londey/pico-gs/twin/components/rasterizer/tests/fixtures/single_triangle_ref.png

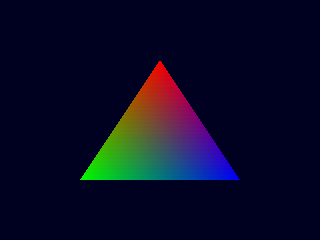
twin/components/rasterizer/tests/fixtures/single_triangle_ref.png
