londey/pico-gs/integration/golden/ver_013_color_combined.png

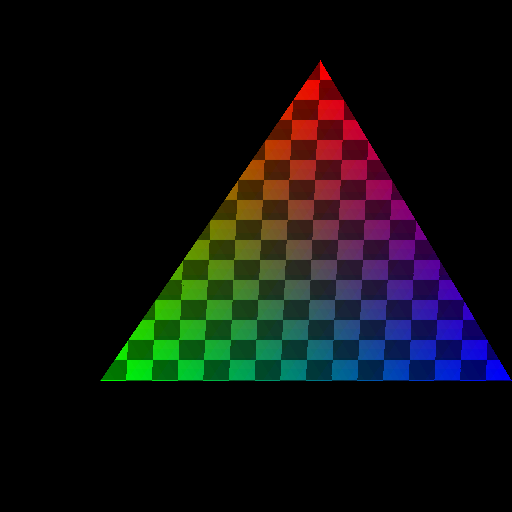
integration/golden/ver_013_color_combined.png
