londey/pico-gs/README.md

# pico-gs

A PS1/N64-era 3D graphics processor implemented in SystemVerilog, targeting the **ECP5-25K** FPGA on an [ICEpi Zero v1.3](external/icepi-zero/) board.
An **RP2350** (Raspberry Pi Pico 2) drives the GPU over SPI; the GPU outputs 640x480 @ 60 Hz DVI.
Named after the PS2 Graphics Synthesizer.

See [ARCHITECTURE.md](ARCHITECTURE.md) for the GPU pipeline architecture, block diagram, and memory system.

## Repository Structure

```text
pico-gs/
├── rtl/                  # SystemVerilog RTL
│   ├── pkg/              # Shared SV packages (fp_types_pkg.sv)
│   ├── top/gpu_top.sv    # Top-level RTL module
│   ├── tb/               # C++ Verilator integration-level testbench (harness, sdram model)
│   └── components/       # Per-component RTL (one subdir each)
│       ├── rasterizer/   # Triangle setup + iteration
│       ├── stipple/      # Stipple test
│       ├── early-z/      # Early depth test
│       ├── texture/      # Texture sampling + decoding (with detail/ subunits)
│       ├── color-combiner/
│       ├── dither/
│       ├── pixel-write/  # Framebuffer write
│       ├── zbuf/         # Z-buffer tile cache
│       ├── memory/       # SDRAM + SRAM controllers
│       ├── display/      # Scan-out / DVI output
│       ├── spi/          # SPI transport + register file
│       ├── registers/    # GPU register interface (SystemRDL source + generated SV)
│       ├── core/         # PLL, reset (RTL only)
│       └── utils/        # FIFOs (RTL only)
├── twin/                 # Rust digital twin crates (one per component)
│   └── components/       # gs-rasterizer, gs-texture, gs-memory, gpu-registers, …
├── shared/
│   └── gs-twin-core/     # Shared Rust foundation crate (types, math)
├── integration/
│   ├── gs-twin/          # Pipeline orchestrator crate
│   ├── gs-twin-cli/      # CLI: render golden references
│   ├── sim/              # Interactive simulator
│   ├── golden/           # Approved golden images
│   └── scripts/          # Hex test scripts + Python generators
├── crates/
│   ├── qfixed/           # Fixed-point math library
│   ├── bits/             # Compile-time width-checked bit vector type
│   ├── ecp5-model/       # Cycle-accurate ECP5 primitive models (DP16KD, MULT18X18D)
│   ├── sdram-model/      # Cycle-accurate SDRAM chip model (W9825G6KH)
│   └── pico-gs-emulator/ # Cycle-accurate GPU emulator
├── pipeline/             # Pipeline microarchitecture (YAML model + validation + diagrams)
├── constraints/          # FPGA constraints
├── doc/                  # Syskit specifications (REQ/INT/UNIT/VER)
├── external/
│   └── icepi-zero/       # Board documentation (git submodule)
├── ARCHITECTURE.md       # GPU architecture document
├── build.sh              # Unified build script
└── Cargo.toml            # Workspace root
```

## Specifications

This project uses [syskit](CLAUDE.md#syskit) for specification-driven development.
Specifications live in `doc/`:

- **Requirements** (`doc/requirements/`): What the system must do (REQ-NNN)
- **Interfaces** (`doc/interfaces/`): Contracts between components (INT-NNN)
- **Design** (`doc/design/`): Implementation approach and decisions (UNIT-NNN)

## Pipeline Model

`pipeline/pipeline.yaml` defines the GPU's pipeline microarchitecture — hardware units, FPGA resource budgets (DSP/EBR/LUT4), and cycle-level schedules for each pipeline mode.
Python scripts validate resource budgets and generate D2 sequence diagrams showing how units are scheduled across clock cycles.

```bash
./build.sh --pipeline   # Validate budgets + generate diagrams (SVG + PNG)
```

Output: `build/pipeline/` (dataflow diagram + per-schedule cycle maps).
Pipeline validation also runs as part of `./build.sh --check`.

## Building

### Prerequisites

- Rust stable (1.75+)
- FPGA toolchain: Yosys, nextpnr-ecp5, ecppack
- Verilator (for RTL simulation)
- ARM cross-compilation target: `rustup target add thumbv8m.main-none-eabihf`

### Build Commands

Build everything (software + FPGA + all tests):
```bash
./build.sh
```

Build specific components:
```bash
./build.sh --fpga-only       # Build FPGA bitstream only
./build.sh --firmware-only   # Build RP2350 firmware only
./build.sh --assets-only     # Process assets only
```

Build in release mode:
```bash
./build.sh --release
```

Flash to hardware:
```bash
./build.sh --flash-fpga --flash-firmware
```

### Component-Specific Builds

**FPGA:**
```bash
cd spi_gpu
make bitstream    # Full synthesis, PNR, bitstream
make synth        # Synthesis only
make program      # Flash to FPGA via JTAG
```

**Firmware:**
```bash
cargo build -p pico-gs-rp2350 --target thumbv8m.main-none-eabihf
cargo test -p pico-gs-core
```

**Asset tool:**
```bash
cargo build -p asset-build-tool
```

## Installing onto Hardware

pico-gs requires two boards: an **ICEpi Zero** (ECP5 FPGA) for the GPU and a **Raspberry Pi Pico 2** (RP2350) as the host controller.

### Prerequisites

In addition to the build prerequisites above:

- [openFPGALoader](https://trabucayre.github.io/openFPGALoader/) for FPGA programming
- [probe-rs](https://probe.rs/) for RP2350 flashing (via a debug probe such as the Raspberry Pi Debug Probe or another CMSIS-DAP adapter)

### Step 1: Build in release mode

```bash
./build.sh --release
```

This produces:
- FPGA bitstream: `build/gpu_top.bit`
- Firmware ELF: `build/pico-gs-rp2350.elf`

### Step 2: Flash the ICEpi Zero

Connect the ICEpi Zero via USB (the on-board FT231X provides JTAG).

**Volatile load** (bitstream lost on power-off — useful for development):
```bash
openFPGALoader -b icepi-zero build/gpu_top.bit
```

**Persistent flash** (bitstream survives power cycles):
```bash
openFPGALoader -b icepi-zero --write-flash build/gpu_top.bit
```

> **Note:** If you have an older version of openFPGALoader that does not recognise the `-b icepi-zero` flag, use `-cft231X --pins=7:3:5:6` instead.

### Step 3: Flash the Pico 2

#### Option A: Debug probe (probe-rs)

Connect a CMSIS-DAP debug probe (e.g. Raspberry Pi Debug Probe) to the Pico 2's SWD pins, then run:

```bash
probe-rs run --chip RP2350 build/pico-gs-rp2350.elf
```

Or use the cargo runner shortcut (configured in `.cargo/config.toml`):

```bash
cargo run --release -p pico-gs-rp2350 --target thumbv8m.main-none-eabihf
```

#### Option B: UF2 drag-and-drop (no debug probe required)

1. Hold the **BOOTSEL** button on the Pico 2 while connecting it via USB.
   It mounts as a USB mass-storage device.
2. Convert the ELF to UF2:
   ```bash
   elf2uf2-rs build/pico-gs-rp2350.elf build/pico-gs-rp2350.uf2
   ```
3. Copy the `.uf2` file to the mounted drive.
   The Pico 2 reboots and runs the firmware automatically.

> Install the conversion tool with `cargo install elf2uf2-rs` if you don't have it.

### One-step build and flash

The build script can build and flash both targets in one go:

```bash
./build.sh --release --flash-fpga --flash-firmware
```

## Digital Twin Verification

Each pipeline component has a Rust digital twin (`twin/`) that defines the bit-accurate expected behaviour.
The `/dt-verify-team` Claude Code command spawns an agent team to create DT-verified test benches for any component.

### Usage

```bash
/dt-verify-team rtl/components/texture/detail/l1-cache
```

The command accepts any component path under `rtl/components/` that has a matching twin crate under `twin/components/`.

### What it does

1. **Pre-flight** — reads the twin crate, RTL sources, and UNIT spec to understand the component
2. **dt-vectors** agent — proposes a test plan (waits for your approval), then generates Rust binaries that produce `$readmemh`-compatible hex stimulus and expected-output files
3. **rtl-testbench** agent — implements SystemVerilog testbenches that load those hex files and verify RTL output binary-matches the twin
4. **Integration** — wires the new test benches into `./build.sh --dt-verify`

Run all DT-verified test benches with:

```bash
./build.sh --dt-verify
```

### File naming conventions

| Type | Pattern | Location |
|---|---|---|
| Vector generator | `gen_<module>_<scenario>_vectors.rs` | `<component>/twin/src/bin/` |
| RTL testbench | `tb_<module>_<scenario>_dt.sv` | `<component>/rtl/tests/` |

## Development

See [CLAUDE.md](CLAUDE.md) for development guidelines and project conventions.

## License

MIT
