londey/pico-gs/doc/requirements/req_003.02_multitexture_rendering.md

# REQ-003.02: Multi-Texture Rendering

## Requirement

When the firmware configures two texture units (TEX0 and TEX1) with valid base addresses and formats, the system SHALL sample both textures during rasterization and provide both texture colors (TEX_COLOR0, TEX_COLOR1) as inputs to the color combiner stage.

## Rationale

Dual-texture rendering enables common multi-texture effects such as diffuse + lightmap, base texture + detail map, or environment mapping + diffuse in a single rendering pass.
This aligns with N64/GeForce2 MX-era dual-texture capabilities.
Effects requiring more than two textures (e.g., diffuse + lightmap + specular + detail) are achievable via multi-pass rendering.

## Parent Requirements

REQ-003

## Interfaces

- INT-010 (GPU Register Map)
- INT-014 (Texture Memory Layout)

## Design Allocation

UNIT-011 (Texture Sampler) — two independent sampler instances (TEX0, TEX1), each with its own index cache; palette LUT is shared

## Functional Requirements

### FR-008-1: Dual Texture Unit Support

When the firmware enables one or both texture units via TEXn_CFG.ENABLE, the system SHALL support up to 2 independent texture units (TEX0 and TEX1), each with its own base address, format, dimensions, and UV coordinate registers (UV0, UV1).

### FR-008-2: Independent Texture Configuration

When a texture unit is configured, each unit SHALL independently specify:

- Enable, format (INDEXED8_2X2 = 4'd0), filter, dimensions, wrap mode, and palette slot selection (TEXn_CFG register)
- Base address in SDRAM (TEXn_CFG.BASE_ADDR field, 512-byte granularity)
- Pre-divided texture coordinates per vertex (ST0_ST1 register, packed S=U/W, T=V/W)

### FR-008-3: Color Combiner Input

When both texture units are enabled, the system SHALL provide both sampled texture colors (TEX_COLOR0 from TEX0, TEX_COLOR1 from TEX1) as inputs to the color combiner stage (REQ-004.01).

### FR-008-4: Single Texture Fallback

When only TEX0 is enabled (TEX1 disabled), the system SHALL provide TEX_COLOR0 to the color combiner and treat TEX_COLOR1 as a neutral value (implementation-defined, typically white RGBA=1,1,1,1).

## Verification Method

**Demonstration:** The system SHALL meet the following acceptance criteria:

- [ ] Configure 2 independent texture units (TEX0, TEX1)
- [ ] Each texture unit configured independently via TEX0_CFG and TEX1_CFG registers
- [ ] Set ST0_ST1 register before each VERTEX write (packed S0/T0/S1/T1, pre-divided texture coordinates S=U/W, T=V/W)
- [ ] Both enabled textures sample in a single draw call using INDEXED8_2X2 format
- [ ] Textures can have different dimensions (e.g., 256×256 diffuse, 64×64 lightmap)
- [ ] Textures can reference different palette slots (TEX0 and TEX1 PALETTE_IDX may differ)
- [ ] Single-texture mode works correctly when only TEX0 is enabled (TEX1_CFG.ENABLE=0)
- [ ] See INT-010 (GPU Register Map) for register details

## Notes

This requirement supersedes the previous 4-texture-unit specification.
The reduction from 4 to 2 texture units per pass simplifies the pipeline while maintaining sufficient capability for common multi-texture effects.
Each sampler has an independent index cache (REQ-003.08); the palette LUT (UNIT-011.06) is shared between both samplers.
Effects previously requiring 4 simultaneous textures can be achieved through multi-pass rendering combined with the color combiner (REQ-004.01).
