londey/pico-gs/doc/requirements/req_001_gpu_spi_hardware.md

# REQ-001: GPU SPI Hardware

## Requirement

The system SHALL provide FPGA-side SPI hardware that accepts register read/write transactions, buffers commands in a FIFO, implements the vertex submission protocol, supports memory upload, and provides GPIO-based flow control to prevent command buffer overflow.

## Rationale

The GPU SPI hardware area groups all FPGA-side requirements for the physical SPI interface and its supporting mechanisms.
This covers the SPI slave controller, command FIFO, register file, vertex submission protocol, memory upload path, and flow control signaling.
Host-side driver software is covered separately by REQ-013 (Host SPI Driver).

## Parent Requirements

None (top-level area)

## Sub-Requirements

- REQ-001.01 (Basic Host Communication)
- REQ-001.02 (Memory Upload Interface)
- REQ-001.03 (SPI Electrical Interface)
- REQ-001.04 (Command Buffer FIFO)
- REQ-001.05 (Vertex Submission Protocol)
- REQ-001.06 (GPU Flow Control)

## Interfaces

- INT-010 (GPU Register Map)
- INT-012 (SPI Transaction Format)
- INT-013 (GPIO Status Signals)
