londey/pico-gs/doc/requirements/req_004_fragment_processor.md

# REQ-004: Fragment Processor / Color Combiner

## Requirement

The system SHALL process rasterized fragments through a programmable color combiner stage, combining texture samples, vertex colors, and constant colors using configurable blend equations at extended internal precision.

## Rationale

The fragment processor area groups requirements for the programmable color combination stage that sits between texture sampling and framebuffer write.
This includes the color combiner modes and the internal precision format used for intermediate calculations.

## Parent Requirements

None (top-level area)

## Interfaces

- INT-010 (GPU Register Map)

## Verification Method

**Inspection:** Verify that UNIT-010 (Color Combiner) is instantiated within UNIT-006 (Pixel Pipeline) with live connections from the `cc_mode` and `const_color` register file outputs, and that DST_COLOR is wired from the color tile buffer to the CC pass-2 input mux.
Child requirements REQ-004.01 and REQ-004.02 carry individual Test-level verification via VER-004 (color combiner unit test) and VER-013/VER-024 (golden image integration tests).

## Notes

This is one of 13 top-level requirement areas organizing the specification hierarchy.
UNIT-010 implements the three-pass color combiner; its `cc_mode` and `const_color` inputs are wired live from UNIT-003 (Register File) through UNIT-006 (Pixel Pipeline).
Alpha blending (REQ-005.03) is implemented as CC pass 2 within UNIT-010, reading DST_COLOR from the color tile buffer managed by UNIT-006.
