londey/pico-gs/doc/requirements/req_006_screen_scan_out.md

# REQ-006: Screen Scan Out

## Requirement

The system SHALL scan out the framebuffer contents as a DVI/HDMI video signal at 640x480 progressive 60 Hz with optional color grading.

## Rationale

The screen scan out area groups all requirements related to reading the completed framebuffer and producing a display output signal, including video timing, vsync frame synchronization, and post-processing (color grading LUT).

## Parent Requirements

None (top-level area)

## Interfaces

- INT-002 (DVI TMDS Output)
- INT-010 (GPU Register Map)
- INT-011 (SDRAM Memory Layout)
