londey/pico-gs/doc/requirements/req_013_host_spi_driver.md

# REQ-013: Host SPI Driver

## Requirement

The system SHALL provide host-side software that communicates with the GPU over SPI, managing the transaction protocol, texture upload sequences, and vsync frame synchronization.

## Rationale

The host SPI driver area groups all host-side (RP2350 and PC) software requirements for driving the GPU over SPI.
This is the software counterpart to REQ-001 (GPU SPI Hardware), covering the Rust driver API, transaction framing, and synchronization.

## Parent Requirements

None (top-level area)

## Sub-Requirements

- REQ-013.01 (GPU Communication Protocol)
- REQ-013.02 (Upload Texture)
- REQ-013.03 (VSync Synchronization)
