londey/pico-gs/doc/reports/rp2350_vertex_throughput.md

# RP2350 Vertex Processing Throughput Analysis

## Technical Report: Estimated Rendering Performance on Single Cortex-M33 Core

---

## 1. Hardware Foundation

**Processor:** RP2350 dual Cortex-M33 at 150 MHz (default clock)
**Available core:** One core (Core 1) dedicated to rendering; Core 0 handles scene management, USB input, and command generation
**FPU:** FPv5 single-precision, pipelined

**Confirmed FPU Instruction Latencies (Cortex-M33 FPv5):**

| Instruction | Latency (cycles) | Throughput (CPI) | Notes |
|---|---|---|---|
| VADD.F32 / VSUB.F32 | 1 | 1 | Single-cycle pipeline |
| VMUL.F32 | 1 | 1 | Single-cycle pipeline |
| VMLA.F32 (multiply-accumulate) | 3 | 3 | NOT fused; 3-cycle penalty vs separate VMUL+VADD (2 cycles) |
| VFMA.F32 (fused multiply-add) | 3 | 3 | Fused but same latency as VMLA |
| VNMUL.F32 | 1 | 1 | Negate-multiply |
| VDIV.F32 | 14 | 14 | Iterative; integer instructions can execute concurrently |
| VSQRT.F32 | 14 | 14 | Iterative; same concurrency as VDIV |
| VCVT (float<->int) | 1 | 1 | Single-cycle conversion |
| VLDR.F32 | 1-2 | 1 | Zero-wait-state from SRAM; may stall on bus contention |
| VSTR.F32 | 1 | 1 | Zero-wait-state to SRAM |
| VMOV (FPU<->GPR) | 1 | 1 | Register transfer |

**Key insight:** VMLA/VFMA take 3 cycles.
The compiler often prefers separate VMUL+VADD (2 cycles total) over VMLA (3 cycles).
With `glam` in scalar mode (no SIMD on Cortex-M33), the generated code will be scalar FPU operations.

**Memory:** 520 KB SRAM in 10 independent banks via AHB-Lite crossbar.
SRAM accesses are single-cycle when no bus contention occurs between cores.
The crossbar supports concurrent access to different banks from different bus masters.

**SPI interface:** 25 MHz SPI to FPGA GPU.
Each register write is a 9-byte SPI transaction (1 address byte + 8 data bytes).
At 25 MHz, one 9-byte write takes 72 SPI bit-clocks = 2.88 us = **432 CPU cycles at 150 MHz**.

---

## 2. Current Pipeline Implementation

Based on the actual codebase, the current vertex processing pipeline performs these operations per vertex:

From `/workspaces/pico-gs/crates/pico-gs-core/src/render/mesh.rs` (lines 59-67):
```rust
let screen = transform_vertex(pos, mvp);          // MVP + perspective divide + viewport
let eye_normal = transform_normal(norm, mv);       // Normal transform + normalize
let color = compute_lighting(eye_normal, base_color, lights, ambient);  // 4-light Gouraud
```

**Architecture note:** The current system splits work across cores:
- **Core 0** performs all vertex transformation, lighting, culling, and packing
- **Core 1** only dequeues `RenderCommand` structs and sends pre-packed data over SPI

This means the vertex processing throughput is determined by **Core 0's** compute budget, not Core 1.
The SPSC queue (64 entries) provides decoupling but Core 0 will block when it fills up.

---

## 3. Detailed Per-Vertex Cycle Breakdown

### 3.1 Common Operations

#### A. Mat4 * Vec4 (MVP Transform)

`glam` on Cortex-M33 uses scalar fallback (no SIMD, `default-features = false`).
A Mat4 * Vec4 expands to:
- 4 result components, each = dot product of matrix row with Vec4
- Each dot product: 4 VMUL + 3 VADD = 7 FPU ops
- Total: 16 VMUL + 12 VADD = **28 FPU cycles** (assuming no pipeline stalls)
- Load overhead: 16 matrix floats + 4 vector floats = 20 VLDR instructions = ~20 cycles
- Store: 4 VSTR = 4 cycles
- **Subtotal: ~52 cycles** (pure instruction count)

With pipeline hazards, register pressure, and loop/function call overhead:
- **Realistic estimate: 60-75 cycles per Mat4 * Vec4**

#### B. Perspective Divide

- VABS + VCMP + branch: ~3 cycles
- VDIV (1.0 / w): **14 cycles**
- 3x VMUL (ndc_x, ndc_y, ndc_z): 3 cycles (but first depends on VDIV result)
- Note: VDIV allows concurrent integer execution, but subsequent VMUL.F32 must wait
- **Subtotal: ~20 cycles**

#### C. Viewport Transform

- Per axis: 1 VADD + 2 VMUL (or 1 VADD + 1 VMUL if constants pre-combined)
- 3 axes: ~9 VADD/VMUL = **~9 cycles**
- Plus clamp on sz: VMOV + VCMP + conditional moves = ~4 cycles
- **Subtotal: ~13 cycles**

#### D. Normal Transform + Normalize

- Mat4 * Vec4 (with w=0.0, compiler may optimize away 4 multiplies): **~50-65 cycles** (slightly cheaper)
- `normalize_or_zero()`:
  - Dot product (length_squared): 3 VMUL + 2 VADD = 5 cycles
  - Comparison with epsilon: 2 cycles
  - VSQRT: **14 cycles**
  - VDIV (1/length): **14 cycles** (or reciprocal + VMUL)
  - 3x VMUL (scale): 3 cycles
  - **Normalize subtotal: ~38 cycles**
- **Subtotal: ~88-103 cycles**

#### E. Back-Face Culling (per triangle, amortized per vertex)

- 4 VSUB + 2 VMUL + 1 VSUB + VCMP = ~8 FPU cycles
- Per triangle = 3 vertices, so per-vertex amortized: ~2.7 cycles
- **Subtotal (amortized per vertex): ~3 cycles**

#### F. Float-to-Fixed Conversion (Packing)

Per conversion: clamp (2 VCMP + 2 conditional moves) + VMUL + VCVT.F32.S32 = ~6 cycles
- 3 conversions (x, y, z): ~18 cycles
- Bit packing (shifts + ORs on integer side): ~10 integer cycles
- Color packing: ~5 integer cycles (byte shifts + ORs)
- **Subtotal: ~33 cycles**

---

## 4. Scenario Analysis

### Scenario A: Lightmapped Static Mesh with 4 Dynamic Point Lights

This scenario represents a pre-transformed world-space mesh (common in retro-style engines where level geometry is static).
Vertices are stored in world space, so only a VP (view-projection) transform is needed.

| Operation | FPU Ops | Est. Cycles | Notes |
|---|---|---|---|
| Load vertex data (pos, normal, 2 UVs) | - | 20 | 5 Vec3/Vec2 loads from SRAM |
| VP transform (Mat4*Vec4) | 28 | 65 | No model matrix needed |
| Perspective divide | 4 | 20 | 1 VDIV + 3 VMUL |
| Viewport transform | 9 | 13 | Scale + offset, 3 axes |
| Normal load (pre-transformed) | - | 6 | 3 floats from SRAM |
| **Point light 1** | | | |
| - Vertex-to-light vector | 3 | 3 | 3 VSUB |
| - Distance squared | 5 | 5 | 3 VMUL + 2 VADD |
| - VSQRT(distance) | 1 | 14 | Iterative |
| - 1/distance (attenuation) | 1 | 14 | VDIV (can overlap sqrt integer work) |
| - Attenuation factor | 2 | 2 | VMUL + VMUL (1/d^2 * intensity) |
| - N dot L | 5 | 5 | 3 VMUL + 2 VADD |
| - Clamp + scale color | 6 | 6 | max(0) + 3 VMUL for RGB |
| **Point light subtotal (x1)** | 23 | **49** | |
| **Point lights (x4)** | 92 | **196** | Dominated by VSQRT + VDIV |
| Accumulate ambient | 3 | 3 | 3 VADD |
| Modulate base color | 3 | 3 | 3 VMUL |
| Color to u8 (clamp + convert) | - | 12 | 3x VCVT + clamp |
| UV0 pass-through | - | 4 | Load + store |
| UV1 (lightmap) pass-through | - | 4 | Load + store |
| Pack UV (with 1/w) | 5 | 24 | 1 VDIV + 2 VMUL + 3 VCVT + bit ops |
| Float-to-fixed + pack position | - | 33 | As computed above |
| Back-face cull (amortized) | - | 3 | Per-vertex share |
| **TOTAL (instruction count)** | | **406** | |
| Loop + function overhead | | ~60 | Branch, index, bounds check |

| Metric | Optimistic | Realistic (1.5x overhead) |
|---|---|---|
| **Cycles per vertex** | 406 | 610 |
| **Vertices/sec at 150 MHz** | 369,458 | 245,902 |
| **Triangles/sec** (1.5 verts/tri) | 246,305 | 163,934 |
| **Triangles/frame at 60 FPS** | 4,105 | 2,732 |

**Key bottleneck:** The 4 point lights account for ~48% of the per-vertex cost, with VSQRT and VDIV (14 cycles each) dominating.
Optimization: precompute 1/distance^2 tables, use fast inverse-square-root approximation, or switch to directional lights.

---

### Scenario B: Static Mesh with 4 Directional Lights

This is closest to the existing teapot demo in the codebase, which already implements exactly this pattern.

| Operation | FPU Ops | Est. Cycles | Notes |
|---|---|---|---|
| Load vertex data (pos, normal) | - | 12 | 2 Vec3 loads |
| MVP transform (Mat4*Vec4) | 28 | 65 | Pre-combined model*view*projection |
| Perspective divide | 4 | 20 | 1 VDIV + 3 VMUL |
| Viewport transform | 9 | 13 | |
| Normal transform (MV * normal) | 28 | 60 | Mat4*Vec4 with w=0 |
| Normalize | 12 | 38 | dot + sqrt + div + 3 mul |
| **Directional light 1** | | | |
| - N dot L | 5 | 5 | 3 VMUL + 2 VADD |
| - max(0, NdotL) | 1 | 2 | VCMP + conditional |
| - Scale by light color (RGB) | 3 | 3 | 3 VMUL |
| **Dir light subtotal (x1)** | 9 | **10** | |
| **Dir lights (x4)** | 36 | **40** | Very cheap without distance |
| Accumulate ambient | 3 | 3 | |
| Modulate by base color | 3 | 3 | |
| Color clamp + convert to u8 | - | 12 | |
| Float-to-fixed + pack position | - | 33 | |
| Back-face cull (amortized) | - | 3 | |
| **TOTAL (instruction count)** | | **302** | |
| Loop + function overhead | | ~45 | |

| Metric | Optimistic | Realistic (1.5x overhead) |
|---|---|---|
| **Cycles per vertex** | 302 | 453 |
| **Vertices/sec at 150 MHz** | 496,689 | 331,126 |
| **Triangles/sec** (1.5 verts/tri) | 331,126 | 220,751 |
| **Triangles/frame at 60 FPS** | 5,519 | 3,679 |

**Validation against existing codebase:** The teapot demo has 146 vertices and 288 triangles.
At 453 cycles/vertex, 146 vertices = 66,138 cycles = **0.44 ms** at 150 MHz.
This leaves ample headroom within a 16.67 ms frame.
The actual demo runs at 60 FPS without issue, which is consistent with these estimates (the SPI submission on Core 1 is the real bottleneck for that demo: 288 triangles x 6-9 register writes x 432 cycles/write = 745k-1.1M cycles = 5-7.5 ms).

---

### Scenario C: 3-Bone Skinned Mesh with 4 Directional Lights

This is the most computationally intensive scenario.
Skeletal animation requires blending bone matrices per vertex before any other transform.

| Operation | FPU Ops | Est. Cycles | Notes |
|---|---|---|---|
| Load vertex data (pos, normal, weights, bone indices) | - | 20 | pos(3) + normal(3) + weights(3) + indices(3) |
| **Load 3 bone matrices** | - | 54 | 3 x 16 floats x ~1.1 cycles (potential bank contention) |
| **Skinned position: w0*(M0*v) + w1*(M1*v) + w2*(M2*v)** | | | |
| - M0 * Vec4 | 28 | 65 | Full Mat4*Vec4 |
| - w0 * result0 | 4 | 4 | Scalar * Vec4 |
| - M1 * Vec4 | 28 | 65 | |
| - w1 * result1 | 4 | 4 | |
| - result0 + result1 | 4 | 4 | Vec4 add |
| - M2 * Vec4 | 28 | 65 | |
| - w2 * result2 | 4 | 4 | |
| - result01 + result2 | 4 | 4 | Vec4 add |
| **Skinned position subtotal** | 104 | **215** | |
| **Skinned normal (Mat3 approx)** | | | |
| - M0_3x3 * normal | 15 | 40 | 9 mul + 6 add + overhead |
| - w0 * result0 | 3 | 3 | |
| - M1_3x3 * normal | 15 | 40 | |
| - w1 * result1 | 3 | 3 | |
| - M2_3x3 * normal | 15 | 40 | |
| - w2 * result2 | 3 | 3 | |
| - Accumulate (2 Vec3 adds) | 6 | 6 | |
| **Skinned normal subtotal** | 60 | **135** | |
| Renormalize skinned normal | 12 | 38 | dot + sqrt + div + 3 mul |
| VP transform (skinned pos already in world space) | 28 | 65 | |
| Perspective divide | 4 | 20 | |
| Viewport transform | 9 | 13 | |
| **Dir lights (x4)** | 36 | 40 | Same as Scenario B |
| Accumulate ambient + modulate | 6 | 6 | |
| Color convert | - | 12 | |
| Float-to-fixed + pack | - | 33 | |
| Back-face cull (amortized) | - | 3 | |
| **TOTAL (instruction count)** | | **654** | |
| Loop + function overhead | | ~80 | More complex function, more loads |

**Memory access concern:** Loading 3 bone matrices = 3 x 16 x 4 = 192 bytes.
If bone matrices are stored contiguously and span SRAM bank boundaries, the AHB crossbar provides single-cycle access.
However, if Core 0 is simultaneously accessing the same bank for scene data, bank contention adds 1 cycle per conflicting access.
Realistic overhead factor should be higher for this scenario: **1.6-2.0x**.

| Metric | Optimistic | Realistic (1.8x overhead) |
|---|---|---|
| **Cycles per vertex** | 654 | 1,177 |
| **Vertices/sec at 150 MHz** | 229,358 | 127,443 |
| **Triangles/sec** (1.5 verts/tri) | 152,905 | 84,962 |
| **Triangles/frame at 60 FPS** | 2,548 | 1,416 |

---

## 5. SPI Submission Bottleneck Analysis

The vertex processing throughput estimated above is for **Core 0 only** (compute-bound).
However, the system must also submit the computed triangles to the FPGA GPU over SPI.
This is handled by Core 1, and the SPI bandwidth may be the actual bottleneck.

**Per-triangle SPI cost:**

Each triangle requires:
- 3 vertices x (1 COLOR write + 1 VERTEX write) = **6 register writes** (non-textured)
- 3 vertices x (1 COLOR write + 1 UV0 write + 1 VERTEX write) = **9 register writes** (textured)

Each register write = 9 bytes at 25 MHz SPI = **2.88 microseconds = 432 CPU cycles**.

| Config | Writes/Triangle | SPI Time/Triangle | Triangles/sec (SPI-limited) | Tri/frame @60fps |
|---|---|---|---|---|
| Non-textured | 6 | 17.28 us | 57,870 | 964 |
| Textured | 9 | 25.92 us | 38,580 | 643 |

**This is a critical finding:** The SPI bottleneck at 25 MHz limits throughput far below the vertex compute capacity.
The SPI bus can push at most **964 non-textured triangles/frame** or **643 textured triangles/frame** at 60 FPS.

This means Core 0's vertex processing is NOT the bottleneck in any scenario.
Core 0 can transform vertices faster than Core 1 can ship them over SPI, and the 64-entry SPSC queue will frequently fill up causing Core 0 to spin-wait.

---

## 6. Summary Table

| Scenario | Cycles/Vert (Optimistic) | Cycles/Vert (Realistic) | Verts/sec (Realistic) | Tri/sec Compute | Tri/sec SPI-limited | Tri/frame @60fps (Effective) |
|---|---|---|---|---|---|---|
| **A: Lightmapped + 4 Point Lights** | 406 | 610 | 245,902 | 163,934 | 38,580 (textured) | **643** |
| **B: Static + 4 Dir Lights** | 302 | 453 | 331,126 | 220,751 | 57,870 (non-textured) | **964** |
| **C: 3-Bone Skinned + 4 Dir Lights** | 654 | 1,177 | 127,443 | 84,962 | 57,870 (non-textured) | **964** |

**Effective triangle budget** is dominated by SPI bandwidth, not vertex compute.

---

## 7. Optimization Opportunities

### 7.1 SPI Throughput (highest impact)

The SPI clock of 25 MHz is the dominant bottleneck.
Options:
1. **Increase SPI clock to 50 MHz** (if FPGA supports it): doubles triangle throughput to ~1,928 tri/frame
2. **DMA-based SPI with overlap**: While DMA transfers one triangle's data, Core 1 prepares the next.
   Effective throughput gain: ~10-20%
3. **Batch register protocol**: Send multiple vertices in a single CS-low transaction without repeating the address byte per register.
   Could reduce per-vertex overhead by ~15%
4. **Wider SPI bus (dual/quad SPI)**: 4x throughput with QSPI

### 7.2 Vertex Compute Optimizations

These matter less given SPI bottleneck, but would help if SPI is improved:

1. **Fast inverse square root** for point lights: Replace VSQRT + VDIV (28 cycles) with Newton-Raphson approximation (~6 cycles).
   The FPv5 has VRSQRTE (reciprocal square root estimate, ~1 cycle) that can seed a single Newton iteration.
2. **Skip normalize when normals are unit-length**: If the model matrix has uniform scale, transformed normals only need rescaling, not full normalize.
   Saves ~24 cycles/vertex.
3. **Pre-combine MVP matrix once per frame** (already done in the teapot demo): Saves one Mat4*Vec4 per vertex.
4. **Use Cortex-M33 custom instructions** (if implemented in RP2350): The RP2350 supports Arm Custom Instructions (ACI).
   In theory, dot-product-4 could be a single instruction.
5. **Dual-core vertex processing**: Currently Core 0 does all transforms.
   If the SPI bottleneck is resolved, split vertex batches across both cores with double-buffered output.

### 7.3 Realistic Target for the Hobby GPU

At 60 FPS with current 25 MHz SPI:
- **~640-960 triangles per frame** is the hard ceiling
- This is comparable to early 3D consoles (Virtual Boy: ~300 triangles, PS1 launch titles: ~500-2000 visible triangles)
- Well-suited for low-poly aesthetic: a character (200 tri) + environment (400 tri) + props (200 tri) fits within budget

At 50 MHz SPI (achievable with careful FPGA timing):
- **~1,300-1,900 triangles per frame** becomes feasible
- Vertex compute for Scenario B (directional lights) still has 3.6x headroom

With QSPI (see FTDI 245 vs SPI report):
- **~2,500-3,800 triangles per frame** at 37.5 MHz QSPI
- Vertex compute starts to matter for Scenario C (skinned meshes)

---

## 8. Validation: Existing Teapot Demo

The codebase's spinning teapot (146 vertices, 288 triangles, 2 active directional lights) provides a real-world validation point:

- **Vertex compute (Core 0):** 146 vertices x ~400 cycles = 58,400 cycles = 0.39 ms
- **SPI submission (Core 1):** 288 triangles x 6 writes x 432 cycles = 746,496 cycles = 4.98 ms
- **Total frame time estimate:** ~5.4 ms (dominated by SPI)
- **Achievable framerate:** ~185 FPS (compute+SPI only), capped at 60 FPS by vsync
- **Headroom:** ~3x more triangles could fit within the 16.67 ms frame budget

This is consistent with the demo running comfortably at 60 FPS as designed.

---

## Sources

- [ARM Cortex-M33 Technical Reference Manual](https://documentation-service.arm.com/static/5f15c42420b7cf4bc5247f3a)
- [Cortex-M33 instruction cycle counts discussion (ST Community)](https://community.st.com/t5/stm32-mcus-products/cortex-m33-instruction-cycle-counts/td-p/123198)
- [Cortex-M4 Instruction Timing Reference](https://www.cse.scu.edu/~dlewis/book3/docs/Cortex-M4%20Instruction%20Timing.pdf)
- [ARM Cortex-M Wikipedia (FPU comparison table)](https://en.wikipedia.org/wiki/ARM_Cortex-M)
- [RP2350 Datasheet (Raspberry Pi)](https://datasheets.raspberrypi.com/rp2350/rp2350-datasheet.pdf)
- [Introducing the RP2350 (Dmitry.GR)](https://dmitry.gr/?r=06.+Thoughts&proj=11.+RP2350)
- [SEGGER Floating-Point Performance Comparison](https://blog.segger.com/floating-point-face-off-part-2-comparing-performance/)
- [glam-rs GitHub (scalar math fallback)](https://github.com/bitshifter/glam-rs)
- [STM32 Cortex-M33 Programming Manual](https://www.st.com/resource/en/programming_manual/pm0264-stm32-cortexm33-mcus-and-mpus-programming-manual-stmicroelectronics.pdf)
