londey/pico-gs/doc/interfaces/int_010_gpu_register_map.md

# INT-010: GPU Register Map

## Type

Internal

## Specification

## Overview

The GPU is controlled via a 7-bit address space providing 128 register locations. Each register is 64 bits wide, though many use fewer bits (unused bits are reserved and must be written as zero, read as zero).

**Transaction Format** (72 bits total):
```
[71]      R/W̄ (1 = read, 0 = write)
[70:64]   Register address (7 bits)
[63:0]    Register value (64 bits)
```

**Command Sources:** Register writes arrive at the register file (UNIT-003) from the command FIFO (UNIT-002), which has two sources:
1. **SPI transactions** from the host (primary, steady-state source)
2. **Pre-populated boot commands** baked into the FIFO memory at bitstream generation time (autonomous, power-on only; see DD-019)

The boot sequence uses registers COLOR (0x00), VERTEX_KICK_012 (0x07), RENDER_MODE (0x30), FB_CONFIG (0x40), and FB_DISPLAY (0x41) to render a self-test screen.
All register semantics are identical regardless of command source.

**Major Features**:
- **2 independent texture units with separate UV coordinates**
- **Dedicated color combiner module with programmable input selection**
- **DOT3 bump mapping with interpolated light direction**
- **Dual vertex colors: diffuse (VER_COLOR0) + specular (VER_COLOR1)**
- **NEAREST (point-sample) texture filtering**
- **Single texture format: INDEXED8_2X2** — 8-bit palette index per 2×2 apparent-texel tile; 4-bit FORMAT field retained for ABI stability (values 4'd1–4'd15 reserved); see INT-014
- **2-slot shared palette LUT** — 256 entries × 4 quadrant RGBA colors per slot; loaded via PALETTE0/PALETTE1 registers (0x12/0x13)
- Swizzle patterns for channel reordering
- **Unified RENDER_MODE register (TRI_MODE + ALPHA_BLEND + Z-modes + dithering)**
- **Scissor rectangle for pixel clipping**
- **Framebuffer write enable masks (Z-buffer, color buffer)**
- Memory upload interface
- Color grading LUT at scanout
- Integrated triangle kick mode control
- **Packed performance counters: 2×32-bit per register**
- Backface culling based on winding order
- **Material colors (MAT_COLOR0, MAT_COLOR1) and fog via Z_COLOR**

---

## Address Space Organization

```
0x00-0x0F: Vertex State (COLOR, ST0_ST1, LIGHT_DIR, VERTEX variants)
0x10-0x17: Texture Configuration (2 units × 4 registers each)
0x18-0x1F: Color Combiner (CC_MODE, MAT_COLOR0, MAT_COLOR1, FOG_COLOR, reserved)
0x20-0x2F: Reserved (freed from old texture registers)
0x30-0x3F: Rendering Configuration (RENDER_MODE consolidated)
0x40-0x4F: Framebuffer, Z-Buffer, Scissor, Color Grading
0x50: Performance Timestamp (PERF_TIMESTAMP)
0x51-0x6F: Reserved
0x70-0x7F: Status & Control (MEM_ADDR, MEM_DATA, ID)
```

**Key Optimizations**:
- Texture units reduced from 4 to 2, with 4x larger per-unit cache (16K texels)
- Color combiner replaces sequential 4-texture blend with flexible N64/GeForce2-style combining
- UV2_UV3 register eliminated (0x02 freed), texture registers 0x18-0x1F repurposed for color combiner
- Performance counters replaced with command-stream timestamp marker (PERF_TIMESTAMP writes to SDRAM)

---

## Register Summary

| Addr | Name | R/W | Description |
|---|---|-----|---|
| **Vertex State** ||||
| 0x00 | COLOR | W | Diffuse[63:32] + Specular[31:0] vertex colors |
| 0x01 | ST0_ST1 | W | Texture units 0+1 pre-divided coordinates (packed S=U/W, T=V/W) |
| 0x02 | - | - | Reserved |
| 0x03 | LIGHT_DIR | W | Light direction XYZ for DOT3 (X8Y8Z8) |
| 0x04-0x05 | - | - | Reserved (future vertex attributes) |
| 0x06 | VERTEX_NOKICK | W | Vertex position + 1/W, no triangle draw |
| 0x07 | VERTEX_KICK_012 | W | Vertex position + 1/W, draw tri (v[0], v[1], v[2]) |
| 0x08 | VERTEX_KICK_021 | W | Vertex position + 1/W, draw tri (v[0], v[2], v[1]) |
| 0x09-0x0F | - | - | Reserved (future vertex attributes) |
| **Texture Units** ||||
| 0x10 | TEX0_CFG | R/W | Texture unit 0: enable, format, dimensions, filter, wrap, palette slot, base addr, cache inv |
| 0x11 | TEX1_CFG | R/W | Texture unit 1: same layout as TEX0_CFG |
| 0x12 | PALETTE0 | R/W | Palette slot 0: SDRAM base address + load trigger |
| 0x13 | PALETTE1 | R/W | Palette slot 1: SDRAM base address + load trigger |
| 0x14–0x17 | - | - | Reserved |
| **Color Combiner** ||||
| 0x18 | CC_MODE | R/W | Color combiner mode and input selection |
| 0x19 | MAT_COLOR0 | R/W | Material color 0 (RGBA8888) |
| 0x1A | MAT_COLOR1 | R/W | Material color 1 (RGBA8888) |
| 0x1B | FOG_COLOR | R/W | Fog color (RGBA8888) |
| 0x1C-0x1F | - | - | Reserved |
| 0x20-0x2F | - | - | Reserved |
| **Rendering Config** ||||
| 0x30 | RENDER_MODE | R/W | **Unified rendering state** |
| 0x31 | Z_RANGE | R/W | **Depth range clipping min/max** |
| 0x32 | - | - | Reserved |
| 0x33-0x3F | - | - | Reserved (rendering config) |
| **Framebuffer** ||||
| 0x40 | FB_CONFIG | R/W | **Render target: color/Z base addresses + surface dimensions (WIDTH_LOG2, HEIGHT_LOG2)** |
| 0x41 | FB_DISPLAY | R/W | **Display scanout + LUT control + FB_WIDTH_LOG2 + LINE_DOUBLE (non-blocking)** |
| 0x42 | - | - | Reserved (previously FB_ZBUFFER; Z base address now in FB_CONFIG) |
| 0x43 | FB_CONTROL | R/W | **Scissor rectangle** |
| 0x44 | MEM_FILL | W | **Memory fill operation (blocking-write)** |
| 0x45 | FB_CACHE_CTRL | W | **Color-buffer cache flush/invalidate (blocking-write)** |
| 0x46 | - | - | Reserved |
| 0x47 | FB_DISPLAY_SYNC | R/W | **Display scanout + LUT control (vsync-blocking, same format as FB_DISPLAY)** |
| 0x48-0x4F | - | - | Reserved (framebuffer config) |
| **Performance Timestamp** ||||
| 0x50 | PERF_TIMESTAMP | R/W | **Write: capture cycle counter to SDRAM[22:0]; Read: live counter** |
| 0x51-0x6F | - | - | Reserved |
| **Status & Control** ||||
| 0x70 | MEM_ADDR | R/W | Memory dword address pointer (22-bit) |
| 0x71 | MEM_DATA | R/W | Memory data (bidirectional 64-bit, auto-increment) |
| 0x72-0x7E | - | - | Reserved |
| 0x7F | ID | R | GPU identification |

---

## Vertex State Registers (0x00-0x0F)

### 0x00: COLOR (Diffuse + Specular)

Latches RGBA colors for the next vertex push. Now holds both diffuse and specular colors.

```
[63:56]   Diffuse Alpha (8 bits)
[55:48]   Diffuse Blue (8 bits)
[47:40]   Diffuse Green (8 bits)
[39:32]   Diffuse Red (8 bits)
[31:24]   Specular Alpha (8 bits)
[23:16]   Specular Blue (8 bits)
[15:8]    Specular Green (8 bits)
[7:0]     Specular Red (8 bits)
```

**Blending Pipeline** (Color Combiner):
```
Step 1: Sample TEX0, TEX1 (2 texture units max)
Step 2: Color combiner pass 0 (CC0): combines inputs per CC_MODE[31:0] equation
        Inputs: VER_COLOR0 (diffuse), VER_COLOR1 (specular), TEX_COLOR0, TEX_COLOR1,
                MAT_COLOR0, MAT_COLOR1, Z_COLOR (fog)
Step 3: Color combiner pass 1 (CC1): combines inputs per CC_MODE[63:32]; COMBINED = pass 0 output
Step 4: Color combiner pass 2 (CC2/blend): COMBINED = pass 1 output;
        DST_COLOR from color tile buffer available; RENDER_MODE.ALPHA_BLEND selects blend equation
```

**Notes**:
- VER_COLOR0 (diffuse) and VER_COLOR1 (specular) are the two vertex colors
- The color combiner (CC_MODE register 0x18) controls how these inputs are combined
- VER_COLOR0 and VER_COLOR1 are interpolated across the triangle (Gouraud shading)
- Values are 0-255, where 255 = full intensity
- Color is associated with the next VERTEX write

**Reset Value**: 0x00000000_00000000 (both transparent black)

---

### 0x01: ST0_ST1

Latches pre-divided texture coordinates for texture units 0 and 1.
Values are pre-divided by W for perspective correction (S=U/W, T=V/W).
**Note**: 1/W (Q) is stored in VERTEX registers.

```
[63:48]   T1 = V1/W (Q4.12 signed fixed-point)
[47:32]   S1 = U1/W (Q4.12 signed fixed-point)
[31:16]   T0 = V0/W (Q4.12 signed fixed-point)
[15:0]    S0 = U0/W (Q4.12 signed fixed-point)
```

**Fixed-Point Format (Q4.12)**:
- Bit 15: Sign
- Bits 14:12: Integer part (3 bits)
- Bits 11:0: Fractional value
- Range: -8.0 to +7.999
- Resolution: 1/4096 ≈ 0.000244

**Notes**:
- Host must compute S=U/W, T=V/W per vertex for each texture unit
- GPU reconstructs U = S/Q, V = T/Q per pixel using Q from VERTEX register
- If only ST0 is used (single texture), write ST1 fields as 0
- ST coordinates for disabled texture units are ignored

**Reset Value**: 0x0000000000000000

---

### 0x02: UV2_UV3 (Removed)

Removed. With only 2 texture units, ST0_ST1 (0x01) provides all needed texture coordinates. This address is now reserved.

---

### 0x03: LIGHT_DIR

Latches light direction vector for DOT3 bump mapping. Interpolated across the triangle (Gouraud-style).

```
[63:24]   Reserved (write as 0)
[23:16]   Z direction (signed 8-bit, -128 to +127)
[15:8]    Y direction (signed 8-bit, -128 to +127)
[7:0]     X direction (signed 8-bit, -128 to +127)
```

**Format**: Signed 8-bit fixed-point, range [-1.0, +0.992] (scale: 128 = 1.0)

**Usage with DOT3**:
```
Per-vertex (host):
  light_dir = normalize(light_position - vertex_position)
  X = clamp(light_dir.x × 128, -128, 127)
  Y = clamp(light_dir.y × 128, -128, 127)
  Z = clamp(light_dir.z × 128, -128, 127)
  gpu_write(REG_LIGHT_DIR, (Z << 16) | (Y << 8) | X)

Per-pixel (GPU):
  light_xyz = interpolate_linear(v0.light_dir, v1.light_dir, v2.light_dir, bary)
  normal_xyz = texture_sample(normal_map) × 2 - 1  // Map [0,1] to [-1,+1]
  dot3_result = clamp(dot(normal_xyz, light_xyz), 0, 1)
  // Use dot3_result in texture blending when BLEND=DOT3
```

**Notes**:
- Light direction interpolated linearly across triangle (like vertex colors)
- Interpolated vector may not be unit length, but acceptable for DOT3
- Requires texture unit configured with BLEND=DOT3 mode
- Normal map texture typically uses BC4 (single R channel for compressed grayscale normals), BC1, or RGB565 encoding

**Reset Value**: 0x0000000000000000 (zero vector)

---

### 0x04-0x05: Reserved

Reserved for future vertex attributes (normals, tangents, skinning weights, etc.).

**Reset Value**: N/A (reserved)

---

### 0x06: VERTEX

Deprecated. Use VERTEX_NOKICK (0x06), VERTEX_KICK_012 (0x07), or VERTEX_KICK_021 (0x08) instead. This entry is retained for reference; the register address is now VERTEX_NOKICK.

```
[63:48]   Q = 1/W (UQ1.15 unsigned fixed-point)
[47:32]   Z depth (16 bits unsigned)
[31:16]   Y coordinate (Q12.4 signed fixed-point)
[15:0]    X coordinate (Q12.4 signed fixed-point)
```

**Fixed-Point Format (Q12.4)**:
- Bits 15:4: Signed integer (-2048 to +2047)
- Bits 3:0: Fractional (1/16 pixel)

**Fixed-Point Format Q (UQ1.15)**:
- Bit 15: Integer part (1 bit)
- Bits 14:0: Fractional value (resolution 1/32768)
- Range: 0.0 to ~2.0 (unsigned; 1/W is always non-negative, W ≥ 1)

**Z Format (16 bits)**:
- Unsigned, 0 = near plane, 0xFFFF = far plane
- Maps to normalized device coordinates after projection
- Higher values are further away

**Vertex Push Behavior**:
```
Write to VERTEX:
  vertex[vertex_count] = {current_COLOR, current_ST0_ST1, X, Y, Z}
  vertex_count++
  if vertex_count == 3:
    submit_triangle(vertex[0], vertex[1], vertex[2])
    vertex_count = 0
```

**Reset Value**: N/A (write-only trigger)

---

### 0x06: VERTEX_NOKICK

Latches vertex position and 1/W without triggering triangle rasterization. Used to accumulate vertices for strips, fans, or explicit triangle submission.

```
[63:48]   Q = 1/W (UQ1.15 unsigned fixed-point)
[47:32]   Z depth (16 bits unsigned)
[31:16]   Y coordinate (Q12.4 signed fixed-point)
[15:0]    X coordinate (Q12.4 signed fixed-point)
```

**Behavior**:
```
Write to VERTEX_NOKICK:
  vertex_buffer[vertex_count] = {current_COLOR, current_ST0_ST1, X, Y, Z, Q}
  vertex_count = (vertex_count + 1) % 3  // Wrap at 3
  // No triangle submission
```

**Use Cases**:
- **Triangle Strips**: Write first 2 vertices with NOKICK, then alternate KICK modes
- **Triangle Fans**: Write center vertex with NOKICK, then kick subsequent triangles
- **Explicit Control**: Accumulate 3 vertices, then trigger draw with a KICK register

**Reset Value**: N/A (write-only trigger)

---

### 0x07: VERTEX_KICK_012

Latches vertex position and 1/W, then triggers triangle rasterization with vertex order (v[0], v[1], v[2]).

```
[63:48]   Q = 1/W (UQ1.15 unsigned fixed-point)
[47:32]   Z depth (16 bits unsigned)
[31:16]   Y coordinate (Q12.4 signed fixed-point)
[15:0]    X coordinate (Q12.4 signed fixed-point)
```

**Behavior**:
```
Write to VERTEX_KICK_012:
  vertex_buffer[vertex_count] = {current_COLOR, current_ST0_ST1, X, Y, Z, Q}
  vertex_count = (vertex_count + 1) % 3
  submit_triangle(vertex_buffer[0], vertex_buffer[1], vertex_buffer[2])  // CW winding
```

**Winding Order**: Counter-clockwise (CCW) when vertices are in screen-space order (0, 1, 2).

**Use Cases**:
- Standard triangle rendering (same as deprecated VERTEX register)
- Triangle strips (odd triangles maintain winding)
- Triangle fans (all triangles with same winding)

**Reset Value**: N/A (write-only trigger)

---

### 0x08: VERTEX_KICK_021

Latches vertex position and 1/W, then triggers triangle rasterization with **reversed** vertex order (v[0], v[2], v[1]).

```
[63:48]   Q = 1/W (UQ1.15 unsigned fixed-point)
[47:32]   Z depth (16 bits unsigned)
[31:16]   Y coordinate (Q12.4 signed fixed-point)
[15:0]    X coordinate (Q12.4 signed fixed-point)
```

**Behavior**:
```
Write to VERTEX_KICK_021:
  vertex_buffer[vertex_count] = {current_COLOR, current_ST0_ST1, X, Y, Z, Q}
  vertex_count = (vertex_count + 1) % 3
  submit_triangle(vertex_buffer[0], vertex_buffer[2], vertex_buffer[1])  // Reversed
```

**Winding Order**: Clockwise (CW) when using the same vertex order as KICK_012. This reverses the triangle facing.

**Use Cases**:
- **Triangle strips**: Alternate with KICK_012 to maintain consistent winding across strip
  - Triangle 0: NOKICK, NOKICK, KICK_012 (v0, v1, v2) → CCW
  - Triangle 1: KICK_021 (v2, v1, v3) → CCW (winding maintained!)
  - Triangle 2: KICK_012 (v2, v3, v4) → CCW
- **Backface culling control**: Explicitly reverse winding for special cases

**Strip Example**:
```c
// 5-vertex triangle strip
gpu_write(COLOR, color0); gpu_write(ST0_ST1, st0); gpu_write(VERTEX_NOKICK, v0);  // v[0]
gpu_write(COLOR, color1); gpu_write(ST0_ST1, st1); gpu_write(VERTEX_NOKICK, v1);  // v[1]
gpu_write(COLOR, color2); gpu_write(ST0_ST1, st2); gpu_write(VERTEX_KICK_012, v2); // Draw tri(v0,v1,v2)
gpu_write(COLOR, color3); gpu_write(ST0_ST1, st3); gpu_write(VERTEX_KICK_021, v3); // Draw tri(v2,v1,v3)
gpu_write(COLOR, color4); gpu_write(ST0_ST1, st4); gpu_write(VERTEX_KICK_012, v4); // Draw tri(v2,v3,v4)
```

**Reset Value**: N/A (write-only trigger)

---

## Texture Configuration Registers (0x10-0x13)

TEX0_CFG is at index 0x10, TEX1_CFG at 0x11.
PALETTE0 is at index 0x12, PALETTE1 at 0x13.
Indices 0x14–0x17 are reserved.

---

### TEXn_CFG (0x10, 0x11) — Texture Sampler Configuration

> **Authoritative bit-field layout:** `registers/rdl/gpu_regs.rdl`, register `tex_cfg_reg`.
> This section documents behavioral semantics only; see the RDL for field positions and encodings.

Each sampler has a single 64-bit configuration register consolidating base address, format, dimensions, filtering, wrap modes, palette slot selection, and cache invalidation.
Any write to TEXn_CFG invalidates the corresponding sampler's index cache (see UNIT-011).

**Key fields** (see RDL for exact bit positions):

- **ENABLE** — activates the sampler.
- **FORMAT** — 4-bit field; only `INDEXED8_2X2 = 4'd0` is valid.
  Values 4'd1–4'd15 are reserved.
  The 4-bit field width is retained for ABI stability (see DD-042).
  Field encoding is defined in `registers/rdl/gpu_regs.rdl` (`tex_format_e`); see INT-014 for the INDEXED8_2X2 memory layout.
- **FILTER** — NEAREST (2'd0) only; values 2'd1–2'd3 are reserved.
  The 2-bit field is preserved for ABI compatibility.
- **WIDTH_LOG2, HEIGHT_LOG2** — log₂ of apparent texture dimensions (valid range: 1–10, i.e. 2–1024 apparent texels per axis; minimum texture 2×2).
- **U_WRAP, V_WRAP** — REPEAT, CLAMP_TO_EDGE, CLAMP_TO_ZERO, or MIRROR.
  For MIRROR, wrapping is applied on the full apparent (u, v) coordinates; the low bit then becomes the quadrant selector naturally (mirrored tiles swap NE↔NW or SE↔SW).
  Octahedral wrap implements coupled diagonal mirroring.
- **PALETTE_IDX[24:24]** — selects which of the two resident palette slots (0 or 1) is active for this sampler.
  The slot must be loaded via the corresponding PALETTEn register before sampling.
- **BASE_ADDR** — 16-bit value × 512 = byte address in SDRAM of the INDEXED8_2X2 index array (512-byte granularity, 32 MiB addressable).
- **RSVD_MID[31:25]** — reserved, write as zero.

**Behavioral notes:**

- Any write to TEXn_CFG invalidates the corresponding per-sampler index cache.
  Palette slot contents are not affected by TEXn_CFG writes; slots persist until a new PALETTEn load completes.
- Textures are sampled independently and passed to the color combiner (CC_MODE, 0x18).
- Swizzle patterns (SWIZZLE field) apply after palette lookup; see INT-014.

**Reset Value**: 0x0000000000000000 (disabled, INDEXED8_2X2, 2×2, NEAREST, REPEAT, slot 0)

---

### PALETTE0 (0x12) / PALETTE1 (0x13) — Palette Slot Load

> **Authoritative bit-field layout:** `registers/rdl/gpu_regs.rdl`, register `palette_reg`.
> This section documents behavioral semantics only; see the RDL for field positions and encodings.

Each register controls loading of one of the two resident palette slots into UNIT-011.06 (Palette LUT).

**Key fields:**

- **BASE_ADDR[15:0]** — 16-bit value × 512 = SDRAM byte address of the palette payload.
  The payload is 4096 bytes: 256 entries × 4 quadrant colors (NW, NE, SW, SE) × 4 bytes (RGBA8888 little-endian, R at lowest byte).
  Base address must be 512-byte aligned.
- **LOAD_TRIGGER[16:16]** — self-clearing pulse.
  When written as 1, the palette load FSM inside UNIT-011 begins a DMA load of 4096 bytes from `BASE_ADDR × 512` into the corresponding slot.
  The hardware clears this bit automatically when the load completes; reads return 0 when idle.
  Firmware must not assume the slot is valid until the load is complete (no status register; see firmware contract notes below).
- **[63:17]** — reserved, write as zero.

**Behavioral notes:**

- The palette load FSM is internal to `texture_sampler.sv` (UNIT-011) and uses SDRAM Port 3 via the 3-way arbiter shared with index cache fills.
- Each RGBA8888 channel byte is promoted to UQ1.8 inline during load: `UQ1.8 = UNORM8 << 1` (9-bit, top bit always 0 since UNORM8 ≤ 0xFF).
- An in-flight index cache fill preempts a pending palette load; the palette load resumes on the next Port 3 grant.
- Slot contents are isolated: writing PALETTE0 does not affect slot 1 and vice versa.
- There is no hardware fault or status if a sampler references an unloaded slot; firmware is responsible for loading before rendering.
- LOAD_TRIGGER is not affected by TEXn_CFG writes (palette contents persist across sampler reconfiguration).

**Reset Value**: 0x0000000000000000

---

---

## Color Combiner Registers (0x18-0x1F)

The color combiner replaces the sequential 4-texture blending pipeline with a programmable three-pass combiner (CC0, CC1, CC2/blend) implemented on a single time-multiplexed `(A-B)*C+D` datapath (UNIT-010).
Pass 2 uses DST_COLOR from the color tile buffer to express all alpha blend modes without a dedicated blend unit.

### 0x18: CC_MODE (Color Combiner Mode)

> **Authoritative bit-field layout:** `registers/rdl/gpu_regs.rdl`, register `cc_mode_reg`.
> **Source enumerations:** `cc_source_e` (A/B/D and all alpha slots), `cc_rgb_c_source_e` (RGB C slot).
> This section documents behavioral semantics only; see the RDL for field positions and encodings.

Selects the combiner equation and input mapping.
Currently 64 bits wide: pass 0 selectors occupy [31:0], pass 1 selectors occupy [63:32].
Pass-2 configuration for alpha blending is driven by RENDER_MODE.ALPHA_BLEND (see below).

**Combiner Equation** (applied independently to RGB and Alpha for each pass):

```
result = (A - B) × C + D
```

Each pass has 8 source selectors: RGB A/B/C/D and Alpha A/B/C/D.
The RGB C slot uses `cc_rgb_c_source_e` (includes alpha-to-RGB broadcast sources for blend factors).
All other slots use `cc_source_e`.
COMBINED (the output of the previous pass) chains passes together.
DST_COLOR (the promoted destination pixel from the color tile buffer) is available in all passes.

**Behavioral notes:**

- All operations are performed in Q4.12 fixed-point format (REQ-004.02)
- RENDER_MODE.ALPHA_BLEND selects the blend equation for the third combiner pass (CC2); when DISABLED, pass 2 is a passthrough
- Z_COLOR is computed as `interpolated_Z[15:8]` (high byte), providing 256-level fog granularity
- The combiner equation `(A - B) × C + D` can express multiply, add, subtract, lerp, fog, and all blend modes

---

### 0x19: MAT_COLOR0 (Material Color 0)

Per-material constant color for use in the color combiner.

```
[63:32]   Reserved (write as 0)
[31:24]   Alpha (8 bits)
[23:16]   Blue (8 bits)
[15:8]    Green (8 bits)
[7:0]     Red (8 bits)
```

**Use Cases**:
- Constant diffuse tint (environment color)
- Fog color (when used as D input with Z_COLOR as C)
- Material-specific flat color

**Reset Value**: 0x00000000FFFFFFFF (opaque white)

---

### 0x1A: MAT_COLOR1 (Material Color 1)

Second per-material constant color for use in the color combiner.

```
[63:32]   Reserved (write as 0)
[31:24]   Alpha (8 bits)
[23:16]   Blue (8 bits)
[15:8]    Green (8 bits)
[7:0]     Red (8 bits)
```

**Use Cases**:
- Secondary material color (e.g., highlight color, rim light color)
- Blend target for material transitions

**Reset Value**: 0x0000000000000000 (transparent black)

---

### 0x1B: FOG_COLOR

Fog color for distance-based fogging. Used as a combiner input source (Z_COLOR selects fog intensity from interpolated Z depth).

```
[63:32]   Reserved (write as 0)
[31:24]   Alpha (8 bits)
[23:16]   Blue (8 bits)
[15:8]    Green (8 bits)
[7:0]     Red (8 bits)
```

**Fog Implementation**:
```
Z_COLOR = interpolated_Z[15:8] / 255.0  // 0.0 (near) to 1.0 (far)
fog_result = (fragment_color - FOG_COLOR) × (1 - Z_COLOR) + FOG_COLOR
           = lerp(FOG_COLOR, fragment_color, 1 - Z_COLOR)
```

To achieve fog, configure CC_MODE: A=computed_color, B=FOG_COLOR, C=ONE_MINUS_Z_COLOR, D=FOG_COLOR.

**Notes**:
- Z_COLOR derives from the high byte of interpolated Z (0-255 → 0.0-1.0)
- For non-linear fog curves, a fog LUT could be added in future (using reserved address space)

**Reset Value**: 0x0000000000000000 (transparent black, no fog)

---

### 0x1C-0x1F: Reserved

Reserved for future color combiner expansion (additional combiner stages, fog LUT pointer, etc.).

**Reset Value**: N/A (reserved)

---

## Rendering Configuration Registers (0x30-0x3F)

### 0x30: RENDER_MODE (Unified Rendering State)

Consolidated rendering state register. Combines TRI_MODE, ALPHA_BLEND, Z-buffer modes, and dithering.

```
[63:16]   Reserved (write as 0)
[15:13]   Z_COMPARE: Depth test comparison function (3 bits)
          000 = LESS (<)
          001 = LEQUAL (≤)
          010 = EQUAL (=)
          011 = GEQUAL (≥)
          100 = GREATER (>)
          101 = NOTEQUAL (≠)
          110 = ALWAYS (always pass, no Z-test)
          111 = NEVER (always fail)
[12:11]   DITHER_PATTERN: Ordered dither pattern (2 bits)
          00 = Blue noise 16×16 (default)
          01-11 = Reserved
[10]      DITHER_EN: Dithering enable (1=enabled, 0=disabled)
[9:7]     ALPHA_BLEND: Framebuffer alpha blending mode (3 bits)
          000 = DISABLED (overwrite destination)
          001 = ADD (result = src + dst, saturate)
          010 = SUBTRACT (result = src - dst, saturate)
          011 = ALPHA_BLEND (result = src × α + dst × (1-α))
          100-111 = Reserved
[6:5]     CULL_MODE: Backface culling mode (2 bits)
          00 = CULL_NONE (draw all triangles, default)
          01 = CULL_CW (cull clockwise-wound triangles)
          10 = CULL_CCW (cull counter-clockwise triangles)
          11 = Reserved (treat as CULL_NONE)
[4]       COLOR_WRITE_EN: Enable color buffer writes (1=enabled, 0=Z-only pass)
[3]       Z_WRITE_EN: Write to Z-buffer on depth test pass
[2]       Z_TEST_EN: Enable depth testing
[1]       Reserved
[0]       GOURAUD: Enable Gouraud shading (1=interpolate vertex colors; 0=reserved, treat as 1)
```

**Update Frequency by Field**:
- **Per-material**: GOURAUD, ALPHA_BLEND, CULL_MODE (changes when switching materials/objects)
- **Per-render-pass**: Z_TEST_EN, Z_WRITE_EN, Z_COMPARE (e.g., opaque pass vs transparent pass)
- **Per-scene/frame**: DITHER_EN, DITHER_PATTERN (rarely changes)

**Common Mode Combinations**:

| Use Case | GOURAUD | Z_TEST_EN | Z_WRITE_EN | COLOR_WRITE_EN | Z_COMPARE | ALPHA_BLEND | CULL_MODE |
|---|---|---|---|---|---|---|---|
| Opaque 3D object | 1 | 1 | 1 | 1 | LEQUAL | DISABLED | CULL_CW |
| Transparent object | 1 | 1 | 0 | 1 | LEQUAL | ALPHA_BLEND | CULL_NONE |
| Skybox | 1 | 0 | 0 | 1 | ALWAYS | DISABLED | CULL_NONE |
| Particle additive | 1 | 1 | 0 | 1 | LEQUAL | ADD | CULL_NONE |
| UI/HUD 2D | 0 | 0 | 0 | 1 | ALWAYS | ALPHA_BLEND | CULL_NONE |
| Z-prepass | 0 | 1 | 1 | 0 | LEQUAL | DISABLED | CULL_CW |
| Depth-only shadow | 0 | 1 | 1 | 0 | LEQUAL | DISABLED | CULL_CW |

**Notes**:
- Z_COMPARE is in RENDER_MODE[15:13]; the Z-buffer base address is in FB_CONFIG[31:16] (Z_BASE)
- ALPHA_BLEND expanded from 2 bits to 3 bits for future blend modes (e.g., multiply, screen, etc.)
- Dithering typically enabled for all 3D rendering, disabled for UI
- Z_WRITE_EN should be 0 for transparent objects (still test depth, don't write it)
- CULL_MODE: Computed in Triangle Setup (UNIT-005.01) using signed area
  ```
  signed_area = (v1.x - v0.x) * (v2.y - v0.y) - (v2.x - v0.x) * (v1.y - v0.y)
  if signed_area > 0: triangle is CW
  if signed_area < 0: triangle is CCW
  if signed_area == 0: degenerate (always culled)
  ```

**Behavioral Note**: All fields in RENDER_MODE are consumed by the pixel pipeline (UNIT-006) after pixel pipeline integration.
GOURAUD, ALPHA_BLEND, CULL_MODE, DITHER_EN, DITHER_PATTERN, STIPPLE_EN, ALPHA_TEST, ALPHA_REF are live inputs to the pixel pipeline's per-fragment processing stages.
Writes to any of these fields have immediate effect on fragments that enter the pipeline after the write clears the command FIFO.

**Reset Value**: 0x0000000000000411 (GOURAUD=1, COLOR_WRITE_EN=1, DITHER_EN=1, DITHER_PATTERN=0, Z_COMPARE=LEQUAL, all else 0)

---

### 0x31: Z_RANGE (Depth Range Clipping)

Depth range clipping register (Z scissor). Fragments whose Z value falls outside [Z_RANGE_MIN, Z_RANGE_MAX] are discarded before any SDRAM access.

```
[63:32]   Reserved (write as 0)
[31:16]   Z_RANGE_MAX: Maximum Z value (16-bit unsigned, inclusive)
[15:0]    Z_RANGE_MIN: Minimum Z value (16-bit unsigned, inclusive)
```

**Depth Range Test**:
```
if fragment_z < Z_RANGE_MIN or fragment_z > Z_RANGE_MAX:
    discard fragment (no SDRAM access, no Z-test, no color write)
```

**Use Cases**:
- **Fog/distance culling**: Set Z_RANGE_MAX to discard fragments beyond a fog distance
- **Near-plane clipping**: Set Z_RANGE_MIN to discard fragments too close to camera
- **Depth slicing**: Render specific depth layers for multi-pass effects
- **Disabled (default)**: Z_RANGE_MIN=0x0000, Z_RANGE_MAX=0xFFFF passes all fragments

**Notes**:
- Test uses inclusive comparison: MIN <= fragment_z <= MAX
- Combined with early Z-test in Stage 0 of pixel pipeline (UNIT-006)
- Z_RANGE applies regardless of RENDER_MODE.Z_TEST_EN setting (independent clip test)
- This address was previously ALPHA_BLEND (moved to RENDER_MODE[9:7])

**Reset Value**: 0x00000000FFFF0000 (Z_RANGE_MAX=0xFFFF, Z_RANGE_MIN=0x0000 -- all fragments pass)

---

### 0x32: DITHER_MODE (Removed)

Separate DITHER_MODE register at address 0x32 has been removed.
Dithering control is now packed into RENDER_MODE[12:10].

See RENDER_MODE register (0x30) for current dithering control.

---

## Framebuffer & Z-Buffer Registers (0x40-0x4F)

### 0x40: FB_CONFIG

Render target configuration: color and Z-buffer base addresses with power-of-two surface dimensions.

```
[63:40]   Reserved (write as 0)
[39:36]   HEIGHT_LOG2: log₂(surface height in pixels), 0-15
          Effective height = 1 << HEIGHT_LOG2 pixels
          Rasterizer uses this to compute bounding box Y scissor: clamp Y to (1<<HEIGHT_LOG2)-1
[35:32]   WIDTH_LOG2: log₂(surface width in pixels), 0-15
          Effective width = 1 << WIDTH_LOG2 pixels
          Rasterizer and pixel pipeline use this for 4×4 block-tiled address calculation:
            stride = 1 << (WIDTH_LOG2 - 2) tiles per row
[31:16]   Z_BASE: Z-buffer base address >> 9 (512-byte aligned, 16 bits)
          Effective address range: 0x000000 - 0x1FFFE00 (32 MiB SDRAM)
[15:0]    COLOR_BASE: Color buffer base address >> 9 (512-byte aligned, 16 bits)
          Effective address range: 0x000000 - 0x1FFFE00 (32 MiB SDRAM)
```

**Consuming Units**:
- **UNIT-005 (Rasterizer)**: uses WIDTH_LOG2 for tiled stride, HEIGHT_LOG2 for Y scissor bound
- **UNIT-006 (Pixel Pipeline)**: uses WIDTH_LOG2 for tiled address calculation on all framebuffer and Z-buffer writes/reads
- FB_CONFIG is independent of FB_DISPLAY so that render-to-texture passes can reprogram the draw surface mid-frame without affecting the displayed framebuffer

**Notes**:
- Default after reset: COLOR_BASE=0x000000, Z_BASE=0x000000, WIDTH_LOG2=0, HEIGHT_LOG2=0
- Changing FB_CONFIG mid-frame allows render-to-texture (render to an off-screen surface, then bind as texture)
- Both color buffer and Z-buffer share the same surface dimensions; a paired Z-buffer at Z_BASE always has the same WIDTH_LOG2/HEIGHT_LOG2 as the color buffer
- Address encoding (×512) matches texture BASE_ADDR encoding

**Reset Value**: 0x0000000000000000

---

### 0x41: FB_DISPLAY (Non-Blocking)

Display scanout framebuffer address with horizontal scaling, vertical line doubling, and optional color grading LUT auto-load.
Non-blocking write (returns immediately); changes take effect at next vsync.

```
[63:52]   Reserved (write as 0)
[51:48]   FB_WIDTH_LOG2: Display framebuffer source width log₂, 0-15
          Source width = 1 << FB_WIDTH_LOG2 pixels (e.g. 9 → 512, 8 → 256)
          The display controller fetches this many RGB565 words per source scanline.
          A Bresenham accumulator stretches the source scanline to 640 output pixels.
          Latched independently from FB_CONFIG so the display surface and render surface
          can have different widths simultaneously (double-buffered rendering).
[47:32]   FB_ADDR: Framebuffer base address >> 9 (512-byte aligned, 16 bits)
          Effective address range: 0x000000 - 0x1FFFE00 (32 MiB SDRAM)
          Same encoding as texture BASE_ADDR
[31:16]   LUT_ADDR: Color grading LUT base address >> 9 (512-byte aligned, 16 bits)
          Effective address range: 0x000000 - 0x1FFFE00
          Special value: 0x0000 = skip LUT auto-load, keep current LUT
[15:2]    Reserved (write as 0)
[1]       LINE_DOUBLE: 1 = vertical line doubling enabled; 0 = normal (1:1 vertical)
          When set: only 240 source rows are read from SDRAM; each is output twice
          to fill 480 display lines. The scanline FIFO is reused for the repeated row
          (no additional SDRAM read). Halves display scanout SDRAM bandwidth.
[0]       COLOR_GRADE_ENABLE: 1=color grading enabled, 0=bypass (RGB565→RGB888 expansion)
```

**Behavior**:
- Write returns immediately (non-blocking)
- Framebuffer switch and LUT auto-load (if enabled) take effect at next vsync
- If `LUT_ADDR != 0`: Hardware auto-loads 384-byte LUT from SDRAM to inactive EBR bank during vblank, then swaps banks atomically with framebuffer switch
- If `LUT_ADDR == 0`: Skip LUT auto-load, only switch framebuffer
- Non-blocking allows firmware to continue work during frame rendering

**SDRAM LUT Format** (384 bytes at LUT_ADDR):
```
Offset  | Data    | Description
--------|---------|----------------------------------
0x000   | RGB888  | Red LUT entry 0 (R_in=0)
0x003   | RGB888  | Red LUT entry 1 (R_in=1)
...     | ...     | ...
0x05D   | RGB888  | Red LUT entry 31 (R_in=31)
0x060   | RGB888  | Green LUT entry 0 (G_in=0)
...     | ...     | ...
0x11D   | RGB888  | Green LUT entry 63 (G_in=63)
0x120   | RGB888  | Blue LUT entry 0 (B_in=0)
...     | ...     | ...
0x17D   | RGB888  | Blue LUT entry 31 (B_in=31)
```

Each RGB888 entry: 3 bytes (R[23:16], G[15:8], B[7:0])

**Notes**:
- Replaces register-based LUT upload
- LUT data must be prepared in SDRAM by firmware before write (see REQ-006.03)
- Address encoding matches texture BASE_ADDR (16-bit, 512-byte granularity, 32 MiB addressable)
- LUT auto-load DMA takes ~2µs during vblank (~1.43ms available)
- For blocking write (waits for vsync), use FB_DISPLAY_SYNC (0x47) instead
- Writing only FB address with LUT_ADDR=0, ENABLE=0 behaves as address-only mode

**Reset Value**: 0x0000000000000000 (FB at 0x000000, no LUT, color grading disabled)

---

### 0x42: Reserved

Previously FB_ZBUFFER (Z-buffer base address).
The Z-buffer base address (`Z_BASE`) is now part of **FB_CONFIG (0x40)**, field `[31:16]`.
Writes to 0x42 are ignored; reads return 0.

---

### 0x43: FB_CONTROL

Scissor rectangle for fragment clipping.

```
[63:40]   Reserved (write as 0)
[39:30]   SCISSOR_HEIGHT: Scissor rectangle height (10 bits, 1-1024)
[29:20]   SCISSOR_WIDTH: Scissor rectangle width (10 bits, 1-1024)
[19:10]   SCISSOR_Y: Scissor rectangle top-left Y (10 bits, 0-1023)
[9:0]     SCISSOR_X: Scissor rectangle top-left X (10 bits, 0-1023)
```

**Scissor Rectangle Behavior**:
- Pixels outside the scissor rect are discarded before Z-test and color writes
- Rectangle defined as: [SCISSOR_X, SCISSOR_X + SCISSOR_WIDTH) × [SCISSOR_Y, SCISSOR_Y + SCISSOR_HEIGHT)
- Default (disabled): SCISSOR_X=0, SCISSOR_Y=0, SCISSOR_WIDTH=1024, SCISSOR_HEIGHT=1024 (full screen)
- Typical use: UI rendering (set scissor per UI element to prevent overdraw)

**Common Use Cases**:

| Use Case | SCISSOR |
|---|---|
| Normal rendering | Full screen or UI bounds |
| Z-only prepass | Full screen |
| UI element | UI element bounding box |
| HUD overlay | HUD region |

**Reset Value**: 0x00000000_3FF003FF (full screen scissor 1024×1024 at 0,0)

---

### 0x44: MEM_FILL (Memory Fill — Blocking)

Triggers a hardware-accelerated SDRAM fill operation.
Writes blocks the SPI command stream until the fill completes.

```
[63:52]   Reserved (write as 0)
[51:32]   COUNT: Number of 16-bit words to fill (20 bits)
[31:16]   VALUE: 16-bit fill constant written to every word
[15:0]    FILL_BASE: Fill target base address >> 9 (512-byte aligned, 16 bits)
          Effective address range: 0x000000 – 0x1FFFE00 (32 MiB SDRAM)
```

**Behavior:**

- Asserts `mem_fill_trigger` for one cycle in UNIT-003 (Register File)
- SDRAM fill unit writes VALUE to COUNT consecutive 16-bit words starting at `FILL_BASE × 512`
- SPI command stream does not advance until fill completes

**Driver usage:** Issue `MEM_FILL` targeting the color buffer before `FB_CACHE_CTRL.INVALIDATE_TRIGGER` when clearing the framebuffer; the cache invalidate ensures stale cached lines are not written back over the freshly-filled SDRAM region.

**Reset Value:** N/A (write-only trigger)

---

### 0x45: FB_CACHE_CTRL (Color-Buffer Cache Control — Blocking)

Software-controlled flush and invalidate triggers for the color-buffer tile cache (UNIT-013).
Writes block the SPI command stream until the requested operation completes, matching the `MEM_FILL` (0x44) and `FB_DISPLAY_SYNC` (0x47) blocking semantics.

```
[63:2]    Reserved (write as 0)
[1]       INVALIDATE_TRIGGER: Self-clearing invalidate trigger
          When written as 1: drops all valid and dirty bits in the cache and resets
          the per-tile uninitialized flag array (16,384 cycles sweep).
          Lines that were dirty are discarded without writeback.
          After the sweep, subsequent first-touch writes lazy-fill with zeros
          rather than reading SDRAM (REQ-005.08).
          Hardware clears this bit and asserts invalidate_done when complete.
[0]       FLUSH_TRIGGER: Self-clearing flush trigger
          When written as 1: writes back all dirty 4×4 tiles to SDRAM via
          16-word burst writes on UNIT-007 port 1.
          Lines remain valid after flush; dirty bits are cleared.
          Hardware clears this bit and asserts flush_done when complete.
```

**Blocking behavior:**
Writing this register with either bit set causes the SPI command stream to stall (SPI CS held asserted) until the cache operation completes and the corresponding `flush_done` or `invalidate_done` pulse is received by UNIT-003.
Writing both bits simultaneously is undefined; driver software must issue them as separate writes.

**Driver usage — double-buffered swap:**
```
// Before every framebuffer swap:
gpu_write(FB_CACHE_CTRL, FLUSH_TRIGGER);  // Write-back dirty lines; blocks until done
gpu_write(FB_DISPLAY_SYNC, new_fb_addr);  // Swap; blocks until vsync
```

**Driver usage — render-target retarget (e.g., after MEM_FILL clear):**
```
// After clearing and before rendering to a new color base:
gpu_write(MEM_FILL, fill_params);            // Clear SDRAM; blocks until done
gpu_write(FB_CONFIG, new_color_z_config);    // Switch render target
gpu_write(FB_CACHE_CTRL, INVALIDATE_TRIGGER); // Drop stale cache state; blocks until done
// Render to new target...
```

**Consuming units:** UNIT-013 (Color-Buffer Tile Cache) receives the flush and invalidate pulses; UNIT-003 (Register File) emits the pulses and waits for ack.

**Reset Value:** N/A (write-only trigger; self-clearing)

---

### 0x47: FB_DISPLAY_SYNC (V-Sync Blocking)

Display scanout framebuffer address with horizontal scaling, vertical line doubling, and optional color grading LUT auto-load. **Blocking write** (waits for vsync).
Same register format as FB_DISPLAY (0x41); the only difference is blocking vs. non-blocking behavior.

```
[63:52]   Reserved (write as 0)
[51:48]   FB_WIDTH_LOG2: Display framebuffer source width log₂, 0-15 (same semantics as FB_DISPLAY)
[47:32]   FB_ADDR: Framebuffer base address >> 9 (512-byte aligned, 16 bits)
          Effective address range: 0x000000 - 0x1FFFE00 (32 MiB SDRAM)
          Same encoding as texture BASE_ADDR
[31:16]   LUT_ADDR: Color grading LUT base address >> 9 (512-byte aligned, 16 bits)
          Effective address range: 0x000000 - 0x1FFFE00
          Special value: 0x0000 = skip LUT auto-load, keep current LUT
[15:2]    Reserved (write as 0)
[1]       LINE_DOUBLE: 1 = vertical line doubling enabled (same semantics as FB_DISPLAY)
[0]       COLOR_GRADE_ENABLE: 1=color grading enabled, 0=bypass (RGB565→RGB888 expansion)
```

**Behavior**:
- **Write blocks** until next vsync edge (SPI CS remains asserted)
- Framebuffer switch and LUT auto-load (if enabled) happen atomically at vsync
- SPI transaction completes only after vsync trigger and updates applied
- If `LUT_ADDR != 0`: Hardware auto-loads 384-byte LUT from SDRAM to inactive EBR bank during vblank, then swaps banks atomically with framebuffer switch
- If `LUT_ADDR == 0`: Skip LUT auto-load, only switch framebuffer
- Blocking write ties up SPI bus for 0-16.67ms (max one frame period)

**SDRAM LUT Format** (384 bytes at LUT_ADDR):
```
Offset  | Data    | Description
--------|---------|----------------------------------
0x000   | RGB888  | Red LUT entry 0 (R_in=0)
0x003   | RGB888  | Red LUT entry 1 (R_in=1)
...     | ...     | ...
0x05D   | RGB888  | Red LUT entry 31 (R_in=31)
0x060   | RGB888  | Green LUT entry 0 (G_in=0)
...     | ...     | ...
0x11D   | RGB888  | Green LUT entry 63 (G_in=63)
0x120   | RGB888  | Blue LUT entry 0 (B_in=0)
...     | ...     | ...
0x17D   | RGB888  | Blue LUT entry 31 (B_in=31)
```

Each RGB888 entry: 3 bytes (R[23:16], G[15:8], B[7:0])

**Use Cases**:
- Game rendering: Atomic frame flip + color grading update
- PS2/N64-style rendering: Natural sync point between frames
- Simplified firmware: No explicit `gpu_wait_vsync()` needed
- Prevents tearing artifacts

**Implementation**:
- SPI slave keeps CS asserted during vsync wait via `spi_cs_hold` signal
- Register data latched on write, applied at vsync edge
- LUT DMA triggered during vblank if `LUT_ADDR != 0`

**Notes**:
- Same register format as FB_DISPLAY (0x41), only difference is blocking behavior
- LUT data must be prepared in SDRAM by firmware before write (see REQ-006.03)
- Address encoding matches texture BASE_ADDR (16-bit, 512-byte granularity, 32 MiB addressable)
- LUT auto-load DMA takes ~2µs during vblank (~1.43ms available)
- For non-blocking write, use FB_DISPLAY (0x41) instead

**Reset Value**: N/A (write-only blocking register)

---

## Performance Timestamp (0x50)

Command-stream timestamp marker for precise GPU-side profiling.
A 32-bit unsigned saturating cycle counter increments every `clk_core` cycle (100 MHz, 10 ns resolution) and resets to 0 on each vsync rising edge.
At 100 MHz the counter saturates after ~42.9 seconds, far exceeding the 16.67 ms frame period.

---

### 0x50: PERF_TIMESTAMP

**Write Behavior:**

DATA[22:0] specifies a 23-bit SDRAM word address (32-bit word granularity, 32 MiB addressable).
When this write reaches the front of the command FIFO and is executed by the register file, the GPU captures the current frame-relative cycle counter value and writes it as a 32-bit word to the specified SDRAM address via memory arbiter port 3.

The SDRAM write is fire-and-forget: the command FIFO advances immediately after latching the request.
If a second PERF_TIMESTAMP write arrives before the previous SDRAM write completes, the new request overwrites the pending one (latest wins).

```
[63:23]   Reserved (0)
[22:0]    SDRAM word address (32-bit granularity)
```

**Read Behavior:**

Returns the current (instantaneous) cycle counter value in bits [31:0], zero-extended to 64 bits.
This read is NOT FIFO-ordered — it returns the counter value at the time the read is processed, not when the read was submitted.

```
[63:32]   0 (reserved)
[31:0]    Frame-relative cycle counter (32-bit unsigned saturating, 100 MHz)
```

**Cycle Counter Specification:**
- Clock: clk_core (100 MHz, 10 ns resolution)
- Width: 32 bits unsigned, saturating at 0xFFFFFFFF
- Reset: clears to 0 on each vsync rising edge

**Usage Example:**
```rust
// Allocate a small timestamp buffer in SDRAM (e.g. at a known word address)
const TS_BUF: u32 = 0x7F_FF00;

// Bracket a draw call with timestamps
gpu.write(PERF_TIMESTAMP, TS_BUF as u64);       // t0: before draw
// ... draw calls ...
gpu.write(PERF_TIMESTAMP, (TS_BUF + 1) as u64);  // t1: after draw

// Read results back via MEM_ADDR/MEM_DATA
let t0 = gpu.read_memory_word(TS_BUF);
let t1 = gpu.read_memory_word(TS_BUF + 1);
let elapsed_cycles = t1.wrapping_sub(t0);
let elapsed_us = elapsed_cycles as f32 * 0.01;  // 10 ns per cycle
```

**Reset Value**: 0x0000000000000000

---

### 0x51-0x6F: Reserved

---

## Status & Control Registers (0x70-0x7F)

### 0x70: MEM_ADDR

Memory access dword address pointer.

```
[63:22]   Reserved (write as 0)
[21:0]    SDRAM dword address (addresses 8-byte dwords in 32 MiB SDRAM)
```

**Usage**: Set this register before reading/writing MEM_DATA.
The address is used for bulk transfers of textures, lookup tables, or other GPU memory.
The 22-bit address field covers 2²² × 8 = 32 MiB.

**Prefetch**: Writing MEM_ADDR initiates an SDRAM read at the specified dword address.
The result is latched into an internal holding register so that the next SPI read of MEM_DATA returns data immediately (combinational from the register file).
The inter-transaction gap (~3–8 µs at 25 MHz SPI) provides ample time for the SDRAM access (~100 ns).

**Reset Value**: 0x0000000000000000

---

### 0x71: MEM_DATA

Bidirectional 64-bit memory data register with auto-increment.

```
[63:0]    64-bit data dword
```

**Write Behavior**:
- Writes DATA[63:0] to SDRAM at MEM_ADDR
- Auto-increments MEM_ADDR by 1 (next 8-byte dword)
- Allows host to upload textures via SPI

**Read Behavior**:
- Returns the prefetched 64-bit SDRAM dword (loaded when MEM_ADDR was written, or by the previous MEM_DATA read)
- Auto-increments MEM_ADDR by 1 and triggers prefetch of the next dword
- Successive reads form a burst: each read returns the current dword and pipelines the next

**Example — Upload 1 KB texture**:
```c
gpu_write(REG_MEM_ADDR, 0x70800);  // Dword address (byte addr 0x384000 >> 3)
for (int i = 0; i < 128; i++) {
    gpu_write(REG_MEM_DATA, texture_data[i]);  // 64-bit dwords, auto-increments
}
```

**Example — Read back 1 KB**:
```c
gpu_write(REG_MEM_ADDR, 0x70800);  // Triggers prefetch of first dword
for (int i = 0; i < 128; i++) {
    readback[i] = gpu_read(REG_MEM_DATA);  // Returns prefetched dword, triggers next
}
```

**Reset Value**: N/A (depends on memory contents)

---

### 0x7F: ID

GPU identification (read-only).

```
[63:32]   Reserved (reads as 0)
[31:16]   VERSION: Major.Minor (8.8 unsigned)
[15:0]    DEVICE_ID: 0x6702 ("gp" + version 2)
```

**Example**: Version 10.0 → reads as 0x00000A00_00006702

**Reset Value**: 0x00000A0000006702

---

## Edge Cases & Behavioral Specifications

### Texture Dimensions

**Power-of-2 Enforcement**: The register encoding (WIDTH_LOG2, HEIGHT_LOG2) inherently enforces power-of-2 dimensions. Valid values are 3-10, giving dimensions from 8 to 1024 pixels.

**Non-Power-of-2 Textures**: Not supported. If needed, pad texture data to the next power-of-2.

### UV Coordinate Wrapping

Behavior is controlled by TEXn_WRAP register:
- **REPEAT** (00): UV mod texture_size (U=1.5 becomes U=0.5)
- **CLAMP_TO_EDGE** (01): Clamp to [0, size-1], prevents edge sampling artifacts
- **CLAMP_TO_ZERO** (10): Out of bounds samples return RGBA=(0,0,0,0)
- **MIRROR** (11): Reflect at boundaries (0→1→0→1...), reduces tiling artifacts

### Color Combiner Operation

Textures are sampled independently, then combined via the color combiner:
```
Step 1: Sample TEX0 → TEX_COLOR0
Step 2: Sample TEX1 → TEX_COLOR1 (if enabled)
Step 3: Color combiner: result = (A - B) × C + D (per CC_MODE register)
Step 4: Apply alpha blend with framebuffer if ALPHA_BLEND != DISABLED
```

The combiner inputs (A, B, C, D) are selected from: TEX_COLOR0, TEX_COLOR1, VER_COLOR0, VER_COLOR1, MAT_COLOR0, MAT_COLOR1, Z_COLOR, ZERO, ONE.
See CC_MODE (0x18) for details.

### Invalid Swizzle Patterns

Swizzle is encoded as a 4-bit index (0x0-0xF). Undefined patterns (0xD-0xF) default to RGBA (0x0).

### Alpha Blending Edge Cases

When alpha is 0 or 1 in ALPHA_BLEND mode, the math still applies correctly:
- **alpha = 0**: result = src × 0 + dst × 1 = dst (fully transparent)
- **alpha = 1**: result = src × 1 + dst × 0 = src (fully opaque)

No special casing required.

### Z-Buffer Memory Overlap

**Undefined Behavior**: Z-buffer must not overlap framebuffer memory. The hardware does not validate address ranges. If overlap occurs:
- Reading Z may return color data (corrupted depth test)
- Writing Z may corrupt color data
- Visual artifacts and incorrect depth sorting will occur

**Recommended Layout** (640×480):
```
0x000000: FB_A (1,228,800 bytes)
0x12C000: FB_B (1,228,800 bytes)
0x258000: Z-buffer (1,228,800 bytes)
0x384000: Textures
```

### BC1 Texture Dimensions

BC1 compressed textures require both width and height to be multiples of 4. Since power-of-2 dimensions (8, 16, 32, ..., 1024) are all multiples of 4, this constraint is automatically satisfied by the WIDTH_LOG2/HEIGHT_LOG2 encoding.

**BC1 Block Address Calculation**:
```
block_x = pixel_x / 4
block_y = pixel_y / 4
block_addr = TEXn_BASE + (block_y * (width / 4) + block_x) * 8
```

See INT-014 for full BC1 decompression algorithm.

### Texture Address Validation

**Invalid Memory Addresses**: The hardware does not validate texture addresses. If TEXn_BASE points to invalid or unmapped memory:
- Behavior is undefined (may return garbage, zeros, or hang)
- Software must ensure all texture addresses are valid
- Textures must fit within SDRAM bounds (0x000000-0x1FFFFFF)

---

## Programming Examples

### Example 1: Multi-Texture Rendering (Diffuse + Lightmap)

```c
// Configure texture unit 0: diffuse map (RGB565) at 0x384000, 256x256
gpu_write(REG_TEX0_BASE, 0x384000);
gpu_write(REG_TEX0_FMT,
    (0x0 << 17) |  // Swizzle: RGBA (identity)
    (8 << 13) |    // HEIGHT_LOG2: 256 (bits [16:13])
    (8 << 9) |     // WIDTH_LOG2: 256 (bits [12:9])
    (0x0 << 7) |   // FILTER: NEAREST (bits [8:7])
    (0x5 << 2) |   // FORMAT: RGB565 (bits [5:2], value 0101 = 5)
    (1 << 0)       // ENABLE: yes
);

// Configure texture unit 1: lightmap (BC1) at 0x3C4000, 256x256
gpu_write(REG_TEX1_BASE, 0x3C4000);
gpu_write(REG_TEX1_FMT,
    (0x0 << 17) |  // Swizzle: RGBA (identity)
    (8 << 13) |    // HEIGHT_LOG2: 256 (bits [16:13])
    (8 << 9) |     // WIDTH_LOG2: 256 (bits [12:9])
    (0x0 << 7) |   // FILTER: NEAREST (bits [8:7])
    (0x0 << 2) |   // FORMAT: BC1 (bits [5:2], value 0000 = 0)
    (1 << 0)       // ENABLE: yes
);

// Set rendering mode: Gouraud + textured + Z-buffer
gpu_write(REG_TRI_MODE,
    (1 << 3) |  // Z_WRITE
    (1 << 2) |  // Z_TEST
    (1 << 0)    // GOURAUD
);

// Draw triangle with two sets of UV coordinates
gpu_write(REG_COLOR, 0xFFFFFFFF);           // White (no tint)
gpu_write(REG_UV0, PACK_UVQ(0.0, 0.0, q0)); // Diffuse UV
gpu_write(REG_UV1, PACK_UVQ(0.0, 0.0, q0)); // Lightmap UV
gpu_write(REG_VERTEX, PACK_XYZ(x0, y0, z0));

gpu_write(REG_COLOR, 0xFFFFFFFF);
gpu_write(REG_UV0, PACK_UVQ(1.0, 0.0, q1));
gpu_write(REG_UV1, PACK_UVQ(1.0, 0.0, q1));
gpu_write(REG_VERTEX, PACK_XYZ(x1, y1, z1));

gpu_write(REG_COLOR, 0xFFFFFFFF);
gpu_write(REG_UV0, PACK_UVQ(0.5, 1.0, q2));
gpu_write(REG_UV1, PACK_UVQ(0.5, 1.0, q2));
gpu_write(REG_VERTEX, PACK_XYZ(x2, y2, z2));  // Triggers draw
```

---

### Example 2: BC1 Compressed Texture Setup

```c
// Upload BC1-compressed texture to SDRAM at 0x404000
// For 128x128 texture: (128/4) x (128/4) = 1024 blocks x 8 bytes = 8192 bytes
gpu_write(REG_MEM_ADDR, 0x404000 >> 3);  // Dword address
for (int i = 0; i < 8192 / 8; i++) {
    gpu_write(REG_MEM_DATA, bc1_data[i]);  // 64-bit dwords, auto-increments
}

// Configure texture unit 0 for BC1 compressed format
gpu_write(REG_TEX0_BASE, 0x404000);
gpu_write(REG_TEX0_FMT,
    (0x0 << 17) |  // Swizzle: RGBA (identity)
    (7 << 13) |    // HEIGHT_LOG2: 128 (bits [16:13])
    (7 << 9) |     // WIDTH_LOG2: 128 (bits [12:9])
    (0x0 << 7) |   // FILTER: NEAREST (bits [8:7])
    (0x0 << 2) |   // FORMAT: BC1 (bits [5:2], value 0000 = 0)
    (1 << 0)       // ENABLE: yes
);
```

---

### Example 3: Z-Buffer with Compare Functions

```c
// Configure render target: color at 0x000000, Z at 0x258000, 512×512 surface
gpu_write(REG_FB_CONFIG,
    ((uint64_t)9 << 36) |         // HEIGHT_LOG2 = 9 (512 rows)
    ((uint64_t)9 << 32) |         // WIDTH_LOG2  = 9 (512 columns)
    ((0x258000 >> 9) << 16) |     // Z_BASE = 0x258000
    (0x000000 >> 9)               // COLOR_BASE = 0x000000
);

// Enable Z-test, Z-write, and Gouraud shading in RENDER_MODE
gpu_write(REG_RENDER_MODE,
    (1 << 3) |  // Z_WRITE_EN
    (1 << 2) |  // Z_TEST_EN
    (1 << 0)    // GOURAUD
);

// Clear Z-buffer to maximum depth using Z_COMPARE=ALWAYS
gpu_write(REG_RENDER_MODE,
    (1 << 3) |  // Z_WRITE_EN
    (6 << 13)   // Z_COMPARE = ALWAYS
);

// Draw full-screen triangles with Z=0xFFFF (far)
uint16_t far_z = 0xFFFF;
gpu_write(REG_COLOR, 0x00000000);
gpu_write(REG_VERTEX_NOKICK, PACK_XYZ(0,   0,   far_z));
gpu_write(REG_VERTEX_NOKICK, PACK_XYZ(511, 0,   far_z));
gpu_write(REG_VERTEX_KICK,   PACK_XYZ(511, 479, far_z));
gpu_write(REG_VERTEX_NOKICK, PACK_XYZ(0,   0,   far_z));
gpu_write(REG_VERTEX_NOKICK, PACK_XYZ(511, 479, far_z));
gpu_write(REG_VERTEX_KICK,   PACK_XYZ(0,   479, far_z));

// Restore LEQUAL compare
gpu_write(REG_RENDER_MODE,
    (1 << 3) |  // Z_WRITE_EN
    (1 << 2) |  // Z_TEST_EN
    (1 << 13)   // Z_COMPARE = LEQUAL
);
```

---

### Example 4: Alpha Blending for Transparency

```c
// Enable standard alpha blend mode
gpu_write(REG_ALPHA_BLEND, 0x03);  // Mode 11: alpha blend

// Configure rendering (no Z-write for transparent objects)
gpu_write(REG_TRI_MODE,
    (0 << 3) |  // Z_WRITE: no
    (1 << 2) |  // Z_TEST: yes (still test depth)
    (1 << 0)    // GOURAUD: yes
);

// Draw particle with alpha=0.5 (semi-transparent)
gpu_write(REG_COLOR, 0x80FFFFFF);  // RGBA: white, alpha=128
gpu_write(REG_VERTEX, PACK_XYZ(x0, y0, z0));
gpu_write(REG_VERTEX, PACK_XYZ(x1, y1, z1));
gpu_write(REG_VERTEX, PACK_XYZ(x2, y2, z2));

// After rendering transparent objects, disable alpha blend
gpu_write(REG_ALPHA_BLEND, 0x00);  // DISABLED
```

---

### Example 5: Channel Swizzling (Grayscale)

```c
// Use a single-channel grayscale texture (R8 format)
// Swizzle 0x7: RRR1 (replicate R to RGB, alpha=1)
gpu_write(REG_TEX0_BASE, 0x384000);
gpu_write(REG_TEX0_FMT,
    (0x7 << 17) |  // Swizzle: RRR1 (grayscale to RGB, bits [20:17])
    (8 << 13) |    // HEIGHT_LOG2: 256 (bits [16:13])
    (8 << 9) |     // WIDTH_LOG2: 256 (bits [12:9])
    (0x0 << 7) |   // FILTER: NEAREST (bits [8:7])
    (0x7 << 2) |   // FORMAT: R8 (bits [5:2], value 0111 = 7)
    (1 << 0)       // ENABLE: yes
);

// When sampled, if texture R=128:
// Raw output: RGBA=(128, 0, 0, 255); after RRR1 swizzle: RGBA=(128, 128, 128, 255)
```

---

## Reset State

After hardware reset or power-on:

| Register | Reset Value | Description |
|---|---|---|
| COLOR | 0x00000000_00000000 | Both diffuse and specular transparent black |
| ST0_ST1 | 0x0000000000000000 | Zero coordinates |
| UV2_UV3 | N/A | Removed |
| LIGHT_DIR | 0x0000000000000000 | Zero vector |
| VERTEX_NOKICK | N/A | Write-only trigger |
| VERTEX_KICK_012 | N/A | Write-only trigger |
| VERTEX_KICK_021 | N/A | Write-only trigger |
| TEX0-TEX1 BASE | 0x0000000000000000 | Address 0x000000 |
| TEX0-TEX1 FMT | 0x0000000000000000 | Disabled, BC1, nearest, 8×8, no mipmaps |
| TEX0-TEX1 MIP_BIAS | 0x0000000000000000 | No bias |
| TEX0-TEX1 WRAP | 0x0000000000000000 | REPEAT both axes |
| CC_MODE | 0x0000000000720020 | TEX0 × VER_COLOR0 (default textured Gouraud) |
| MAT_COLOR0 | 0x00000000FFFFFFFF | Opaque white |
| MAT_COLOR1 | 0x0000000000000000 | Transparent black |
| FOG_COLOR | 0x0000000000000000 | Transparent black |
| RENDER_MODE | 0x0000000000000401 | GOURAUD=1, DITHER_EN=1, Z_COMPARE=LEQUAL, all else 0 |
| FB_CONFIG | 0x0000000000000000 | COLOR_BASE=0x000000, Z_BASE=0x000000, WIDTH_LOG2=0, HEIGHT_LOG2=0 |
| FB_DISPLAY | 0x0000000000000000 | FB=0x000000, LUT=0x0, FB_WIDTH_LOG2=0, LINE_DOUBLE=0, color grading disabled |
| FB_CONTROL | 0x00000000_3FF003FF | Full screen scissor 1024×1024 |
| FB_DISPLAY_SYNC | N/A | Write-only blocking register |
| PERF_TIMESTAMP | 0x0000000000000000 | Cycle counter starts at 0 |
| MEM_ADDR | 0x0000000000000000 | Dword address 0x000000 |
| MEM_DATA | N/A | Depends on memory |
| ID | 0x00000A0000006702 | Device 0x6702 |
| vertex_count | 0 | Internal state counter |

---

## GPIO Signals

Active-high outputs from GPU to host.

| Signal | Description |
|---|---|
| CMD_FULL | FIFO depth ≥ (MAX - 2), host should pause writes |
| CMD_EMPTY | FIFO depth = 0, safe to read registers |
| VSYNC | Pulses high for one clk_core cycle at frame boundary |

**Timing Notes**:
- CMD_FULL has 2-slot slack: host may complete in-flight transaction
- VSYNC aligns with display vertical blanking start
- Poll GPIO for FIFO and VSYNC information

---

## Transaction Timing

**Write Transaction** (72 bits @ 25 MHz SPI):
- Duration: 2.88 µs
- Latency: Command visible to GPU within 100 clk_core cycles of CS rising

**Read Transaction** (72 bits @ 25 MHz SPI):
- Duration: 2.88 µs
- Data valid on MISO starting from bit 63
- Only read registers (ID, MEM_DATA) when CMD_EMPTY to avoid stale data

**Triangle Submission** (typical multi-texture):
- Minimum: 3 VERTEX writes = 8.64 µs
- Typical (1 texture): RENDER_MODE + 3×(COLOR + ST0_ST1 + VERTEX) = 28.8 µs
- Max (2 textures): RENDER_MODE + 3×(COLOR + ST0_ST1 + VERTEX) = 28.8 µs (same, ST0_ST1 holds both)
- Theoretical max: ~35,000 triangles/second

## Constraints

See specification details above.

## Texture Cache Interaction (REQ-003.08)

Writing to **TEXn_BASE** or **TEXn_FMT** registers (n=0,1) implicitly invalidates the corresponding sampler's texture cache. All valid bits for the affected sampler are cleared, ensuring the next texture access fetches fresh data from SDRAM.

No explicit cache control registers are defined.
Future versions may add a `CACHE_CTRL` register for explicit flush/invalidate commands.

## Notes

External consumer: [pico-racer](https://github.com/londey/pico-racer) — host SPI driver and render command dispatch.

Migrated from speckit contract: specs/001-spi-gpu/contracts/register-map.md
