londey/pico-gs/doc/interfaces/int_013_gpio_status_signals.md

# INT-013: GPIO Status Signals

## Type

External Standard

## External Specification

- **Standard:** GPIO Status Signals
- **Reference:** GPIO signals for flow control (CMD_FULL, CMD_EMPTY, VSYNC).

## Specification

### Overview

This project uses a subset of the GPIO Status Signals standard.

### Usage

GPIO signals for flow control (CMD_FULL, CMD_EMPTY, VSYNC).

## Constraints

See external specification for full details.
