londey/pico-gs/doc/README.md

# System Documentation

*Software documentation set for <system name>*

## System Overview

<Brief description of the system: what it is, what it does, and its operational context.>

## Document Description

<Brief overview of what this document set covers and how it is organized.>

## Document Set

- [**requirements/**](requirements/README.md) — WHAT the system must do. Condition/response statements (`REQ-NNN`).
- [**interfaces/**](interfaces/README.md) — Contracts between components and with external systems (`INT-NNN`).
- [**design/**](design/README.md) — HOW the system works. Design units linked to requirements, interfaces, and source (`UNIT-NNN`).
- [**verification/**](verification/README.md) — HOW requirements are verified (`VER-NNN`).

Supporting documents at the project root:

- `ARCHITECTURE.md` — Auto-generated architecture overview with block diagram.

For AI-assistant conventions, document style rules, and workflow commands, see `.syskit/AGENTS.md`.
