londey/pico-gs/rtl/tb/README.md

# Integration Test Harness

Shared C++ harness for VER-010 through VER-013 golden image integration tests.
This harness drives a Verilated `gpu_top` model with register-write command scripts, captures the resulting framebuffer from a behavioral SDRAM model, and writes PNG golden images for comparison.

## Architecture Overview

The harness consists of four components:

1. **Main harness** (`harness.cpp`) -- Instantiates the Verilated GPU model, connects the behavioral SDRAM model to the memory arbiter ports, drives register-write command scripts into the register file inputs, runs the clock loop until rendering completes, and calls the PNG writer to serialize the framebuffer.

2. **Behavioral SDRAM model** (`sdram_model.h`, `sdram_model.cpp`) -- A cycle-accurate behavioral model of the W9825G6KH-6 SDRAM (INT-011).
   Provides a simple C++ API (`read_word()`, `write_word()`, `fill_texture()`) and implements the 4x4 block-tiled address layout defined in INT-011.

3. **PNG writer** (`png_writer.h`, `png_writer.cpp`) -- Reads an RGB565 framebuffer array and writes a PNG file using stb_image_write, converting 16-bit RGB565 pixels to 8-bit-per-channel RGB.

4. **Command scripts** -- C++ arrays of `{addr, data}` pairs encoding register-write sequences per INT-010 and INT-012.
   Each VER test scene provides its own command script that replicates the register writes for rendering and clearing operations.

## Verilator Invocation

The harness is compiled with Verilator using the project's shared flags:

```
verilator --binary -f verilator.f <RTL sources> tests/harness/harness.cpp tests/harness/sdram_model.cpp tests/harness/png_writer.cpp --top-module gpu_top -o harness
```

This matches the existing Makefile convention (`VERILATOR_FLAGS = --binary -f verilator.f`).

## Behavioral SDRAM Model

The SDRAM model implements the INT-011 4x4 block-tiled address layout for all surface types (color buffers, Z-buffer, textures).

### Block-Tiled Address Calculation (INT-011)

```
block_x    = x >> 2
block_y    = y >> 2
local_x    = x & 3
local_y    = y & 3
block_idx  = (block_y << (WIDTH_LOG2 - 2)) | block_x
word_addr  = base_word + block_idx * 16 + (local_y * 4 + local_x)
byte_addr  = word_addr * 2
```

### C++ API

- `read_word(uint32_t addr)` -- Read a 16-bit word from the given word address.
- `write_word(uint32_t addr, uint16_t data)` -- Write a 16-bit word at the given word address.
- `fill_texture(uint32_t base_addr, uint8_t format, const uint8_t* pixel_data, size_t size)` -- Upload texture data to the model, laying out pixels in the INT-011 4x4 block-tiled scheme at the burst lengths defined in UNIT-011 for each format.

### UNIT-011 Burst Lengths

The texture cache (UNIT-011) issues burst reads with format-dependent lengths on cache miss:

| Format | burst_len (16-bit words) | Bytes | Description |
|---|---|---|---|
| BC1 | 4 | 8 | 64-bit BC1 block |
| BC2 | 8 | 16 | 128-bit BC2 block |
| BC3 | 8 | 16 | 128-bit BC3 block |
| BC4 | 4 | 8 | 64-bit BC4 block |
| RGB565 | 16 | 32 | 16 x 16-bit pixels |
| RGBA8888 | 32 | 64 | 16 x 32-bit pixels |
| R8 | 8 | 16 | 16 x 8-bit pixels packed  |

The behavioral model must serve data at these burst lengths when the Verilated memory arbiter issues burst read requests.

## Command Script Format

Each test scene defines a command script as a C++ array of register-write pairs:

```cpp
struct RegWrite {
    uint8_t  addr;   // Register address (INT-010 register map index)
    uint64_t data;   // Register data (up to 64 bits for MEM_DATA)
};

// Example: VER-010 flat-shaded triangle
static const RegWrite ver_010_script[] = {
    {REG_RENDER_MODE, 0x...},   // Configure render mode
    {REG_COLOR,       0x...},   // Set vertex color
    {REG_VERTEX,      0x...},   // Submit vertex (kick triangle)
    // ...
};
```

This format directly encodes register-write sequences per INT-010 and INT-012.
The harness drives these writes into the register file inputs of the Verilated model.

## PNG Output

After the simulation completes rendering, the harness:

1. Extracts the framebuffer contents from the SDRAM model (512x480 region of the 512x512 color buffer).
2. Calls `png_writer::write_png()` to convert RGB565 pixels to 8-bit RGB and write a PNG file (via stb_image_write).
3. The output PNG is compared against approved golden images in `tests/golden/`.

## Directory Layout

```
tests/
  harness/
    README.md           -- This file
    harness.cpp         -- Main harness skeleton
    sdram_model.h       -- Behavioral SDRAM model header
    sdram_model.cpp     -- Behavioral SDRAM model implementation
    png_writer.h        -- PNG image writer header
    png_writer.cpp      -- PNG image writer implementation (uses stb_image_write.h)
    stb_image_write.h   -- stb single-header PNG encoder (vendored, public domain)
  golden/
    .gitkeep            -- Golden images (empty until first approved image)
  vectors/
    .gitkeep            -- Test vectors (empty until extended)
```

## References

- **INT-011** (SDRAM Memory Layout) -- 4x4 block-tiled address calculation, memory map, SDRAM timing.
- **INT-014** (Texture Memory Layout) -- Texture format encodings and block sizes.
- **UNIT-011** (Texture Sampler) -- Cache miss burst lengths per texture format.
- **VER-010** -- Flat-Shaded Triangle Golden Image Test.
- **VER-011** -- Depth-Tested Overlapping Triangles Golden Image Test.
- **VER-012** -- Textured Triangle Golden Image Test.
- **VER-013** -- Color-Combined Output Golden Image Test.
