londey/pico-gs/doc/design/unit_003_register_file.md

# UNIT-003: Register File

## Purpose

Stores GPU state and vertex data

## Implements Requirements

- REQ-001.01 (Basic Host Communication)
- REQ-001.02 (Memory Upload Interface)
- REQ-001.05 (Vertex Submission Protocol)
- REQ-003.09 (Palette Slots)
- REQ-011.02 (Resource Constraints)
- REQ-001 (GPU SPI Hardware)

## Interfaces

### Provides

- INT-010 (GPU Register Map)

### Consumes

None
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
