londey/pico-gs/integration/golden/ver_010_gouraud_triangle.png

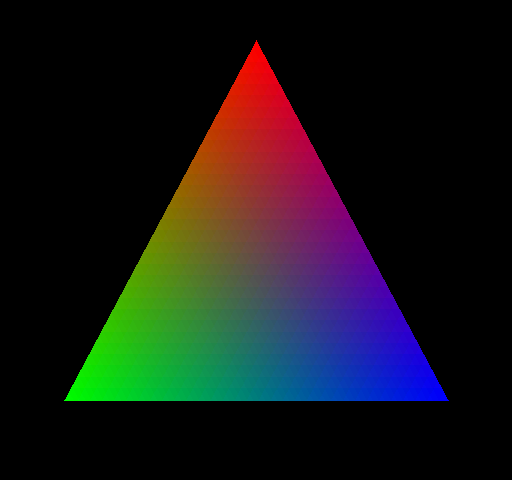
integration/golden/ver_010_gouraud_triangle.png
