londey/pico-gs/integration/golden/ver_012_textured_triangle.png

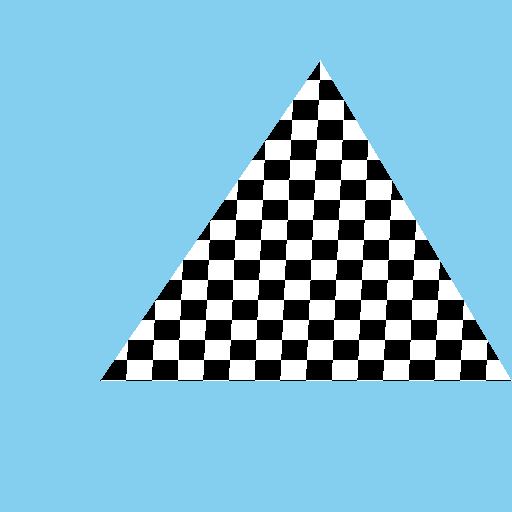
integration/golden/ver_012_textured_triangle.png
