londey/pico-gs/integration/golden/ver_014_textured_cube.png

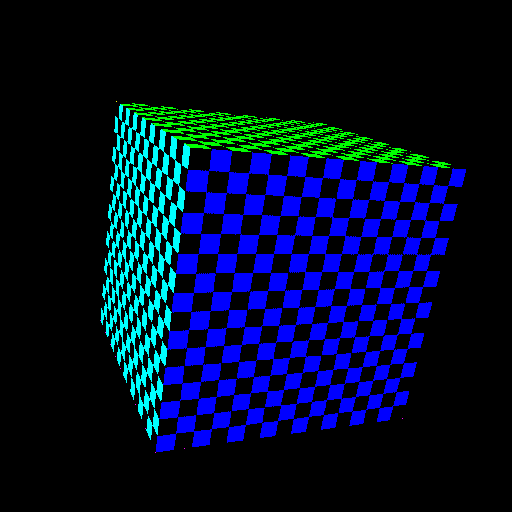
integration/golden/ver_014_textured_cube.png
