londey/pico-gs/integration/golden/ver_014_textured_cube_z.png

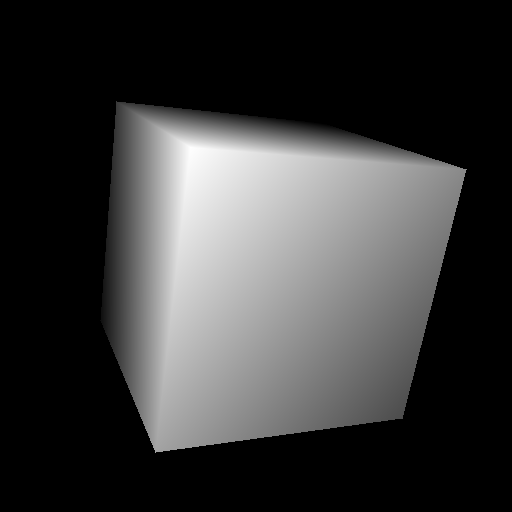
integration/golden/ver_014_textured_cube_z.png
