londey/pico-gs/integration/golden/ver_015_size_grid.png

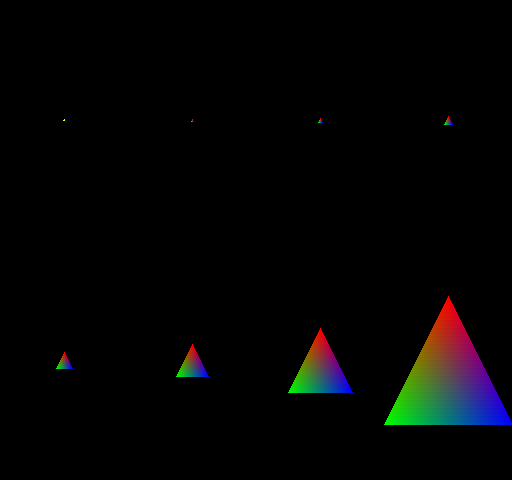
integration/golden/ver_015_size_grid.png
