londey/pico-gs/integration/golden/ver_016_perspective_road.png

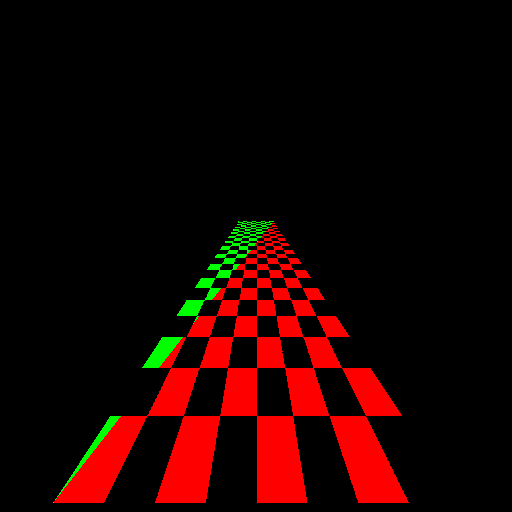
integration/golden/ver_016_perspective_road.png
