londey/pico-gs/integration/golden/ver_016_perspective_road_z.png

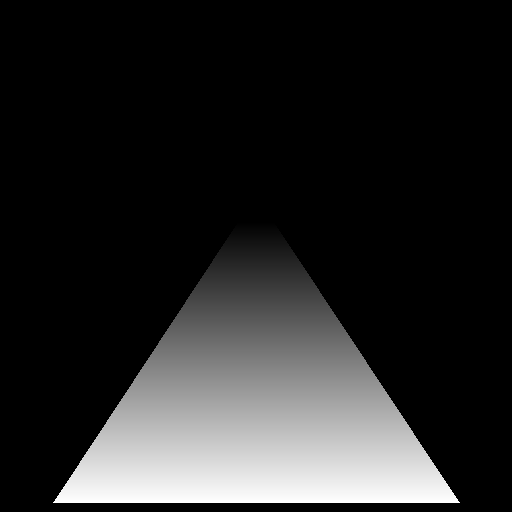
integration/golden/ver_016_perspective_road_z.png
