londey/pico-gs/integration/golden/ver_017_indexed_pixel_art.png

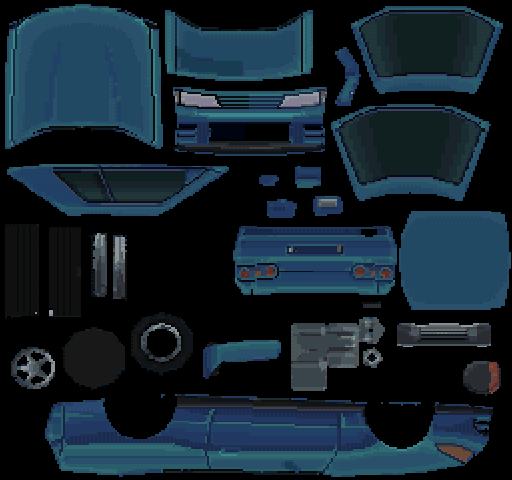
integration/golden/ver_017_indexed_pixel_art.png
