londey/pico-gs/integration/golden/ver_024_alpha_blend.png

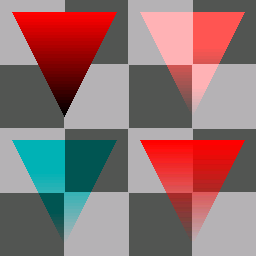
integration/golden/ver_024_alpha_blend.png
