londey/pico-gs/assets/source/meshes/teapot.obj

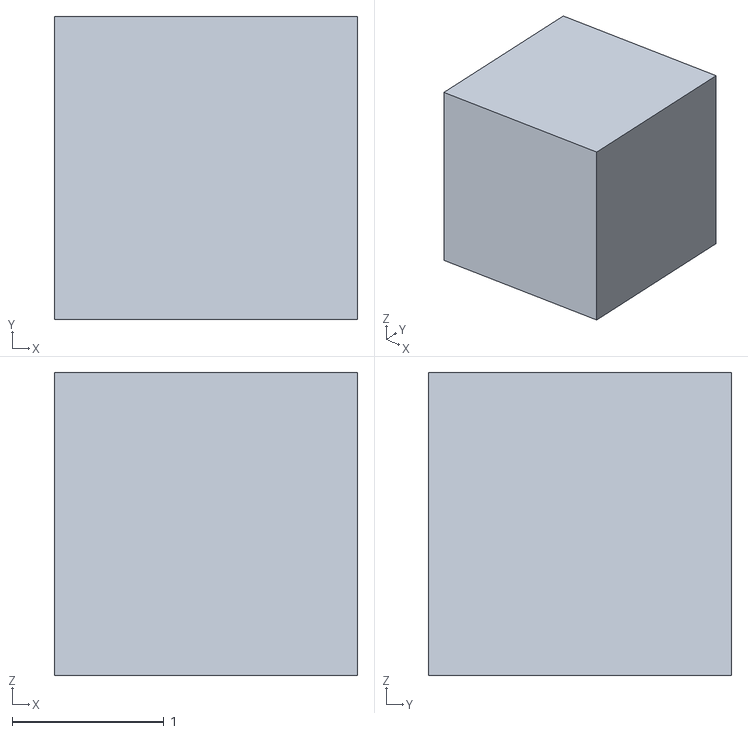
[picture p12: CAD file, 2026-01-31, last stored version]
assets/source/meshes/teapot.obj
2.00 x 2.00 x 2.00
