londey/pico-gs/doc/requirements/req_005.07_zbuffer_operations.md

# REQ-005.07: Z-Buffer Operations

## Requirement

When Z_TEST_EN=1 and a fragment's interpolated depth value is compared against the Z-buffer using the configured Z_COMPARE function, the system SHALL pass the fragment and, when Z_WRITE_EN=1, update the Z-buffer with the new depth value; otherwise the system SHALL discard the fragment without modifying the Z-buffer or color buffer.

When Z_RANGE is configured with Z_RANGE_MIN and Z_RANGE_MAX values, the system SHALL discard any fragment whose interpolated Z value falls outside [Z_RANGE_MIN, Z_RANGE_MAX] before performing the depth comparison.

When Z_WRITE_EN=1 and a fragment passes the depth test, the system SHALL update the Hi-Z metadata for the containing 4×4 tile: if the written depth value (Z[15:7]) is less than the tile's stored minimum depth (min_z), the system SHALL replace min_z with the truncated written depth value.

When the Z-cache uninitialized flag (UNIT-012) is set for a tile, the system SHALL treat any Hi-Z comparison for that tile as passing (i.e., not reject the tile), and the first Z-write to that tile SHALL clear the uninitialized flag and initialize the Hi-Z min_z with that depth value.

## Rationale

This requirement defines the functional behavior of the Z-buffer operations subsystem, including depth range clipping, Z-buffer write control, and Hi-Z metadata maintenance.
The Z-buffer tile cache (UNIT-012) absorbs most Z read/write traffic; only cache misses and evictions generate SDRAM accesses via the arbiter (UNIT-007).
The Hi-Z metadata (8 DP16KD blocks, UNIT-005.06) stores a 9-bit truncated min_z per tile, enabling tile-level rejection in the rasterizer (UNIT-005.05) before any fragments are emitted.
The uninitialized/cleared-tile state is tracked by a separate 1-bit flag array in UNIT-012 (one DP16KD, 32×512 mode), co-located with the Z-cache that consumes it for lazy-fill decisions.
Maintaining min_z on every Z-write is a side-effect of the write path that must not change functional pixel output.

## Parent Requirements

- REQ-005 (Blend/Frame Buffer Store)

## Interfaces

- INT-010 (GPU Register Map)
- INT-011 (SDRAM Memory Layout)

## Verification Method

**Test:** Execute relevant test suite for Z-buffer operations.

- [ ] Depth comparison produces correct pass/fail results for all 8 compare functions (LESS, LEQUAL, EQUAL, GEQUAL, GREATER, NOTEQUAL, ALWAYS, NEVER)
- [ ] When Z_WRITE_EN=1, passing fragments update the Z-buffer with the new depth value
- [ ] When Z_WRITE_EN=0, the Z-buffer is not modified regardless of depth test result
- [ ] When Z_RANGE is configured to a sub-range, fragments outside [Z_RANGE_MIN, Z_RANGE_MAX] are discarded before depth test
- [ ] When Z_RANGE_MIN=0x0000 and Z_RANGE_MAX=0xFFFF, all fragments proceed to depth test (full range passthrough)
- [ ] When Z_WRITE_EN=1 and a fragment passes the depth test, the Hi-Z metadata min_z for the tile is updated if the written depth (Z[15:7]) is less than the stored min_z
- [ ] When Z_WRITE_EN=0, the Hi-Z metadata is not modified regardless of depth test result
- [ ] When a tile's Z-cache uninitialized flag (UNIT-012) is set, the Hi-Z test passes (tile is not rejected) and the first Z-write to that tile clears the flag and initializes min_z

## Notes

The Z-buffer stores 16-bit unsigned depth values (0 = near, 0xFFFF = far) in 4×4 block-tiled layout identical to the framebuffer format (INT-011).
Z-buffer addresses use the same block-tiled address calculation as framebuffer pixel addresses.

The Hi-Z metadata array (UNIT-005.06) holds one entry per 4×4 tile: a 9-bit truncated min_z representing the minimum depth written to that tile (Z[15:7]), with sentinel `9'h1FF` meaning no Z-write since the last clear.
The rasterizer (UNIT-005.05) reads this metadata at tile granularity before emitting any fragments; tiles whose stored min_z (excluding the sentinel) exceeds the incoming Z threshold are rejected entirely (Hi-Z test, UNIT-005.05).
The uninitialized/cleared-tile state is tracked by the Z-cache uninitialized flag array in UNIT-012; a tile whose flag is set always passes the Hi-Z test regardless of the min_z sentinel.
Hi-Z metadata maintenance on Z-write is a side-effect of the existing Z-write path and must not alter the final framebuffer contents.

Cross-references: REQ-005.04 (Enhanced Z-Buffer) defines configurable compare functions, depth range clipping, and per-pixel early Z.
REQ-005.08 (Clear Framebuffer) defines the fast-clear path that bulk-invalidates Hi-Z metadata.
See REQ-005.04 for detailed acceptance criteria for each sub-feature.
