londey/pico-gs/doc/requirements/req_011.01_performance_targets.md

# REQ-011.01: Performance Targets

## Requirement

When rendering typical scene content, the system SHALL achieve frame rates and throughput sufficient for interactive rendering as measured by the performance observations defined in quality_metrics.md.

## Rationale

Performance is highly content-dependent (triangle count, overdraw, texture cache hit rate). Rather than setting arbitrary numeric targets, this requirement establishes that the system must support interactive rendering for typical scenes.

**Target Use Case:** Low-poly textured and lit animated models (e.g., skeletal animated T-Rex) at interactive frame rates (≥15 FPS).

**Hardware Constraints:**
- 100 MHz unified GPU core and SDRAM controller clock (single clock domain for rendering pipeline and memory controller)
- 16-bit SDRAM bus (W9825G6KH) at 100 MHz (200 MB/s peak bus rate; effective throughput reduced by CAS latency, row activation, and auto-refresh overhead)
- 90-degree phase-shifted 100 MHz SDRAM clock output from PLL
- 25 MHz pixel clock derived as a synchronous 4:1 divisor from the 100 MHz core clock
- 25 MHz QSPI command interface (72-bit transactions = ~3 MB/s command bandwidth)

**Actual Performance Observations** (tracked in quality_metrics.md):
- Triangle throughput: ~17,000 triangles/second @ 60 fps (SpinningTeapot: 288 tri/frame)
- Fill rate: ~22.5 Mpixels/second theoretical maximum (limited by SDRAM write bandwidth accounting for row activation overhead on typical rasterization patterns; requires the pixel pipeline, UNIT-006, and color tile cache, UNIT-013, to be functionally integrated for end-to-end measurement)
- Frame time: Content-dependent (simple scenes may exceed 60 FPS, complex scenes may drop below)
- Early Z rejection: Reduces effective fill cost for overdraw-heavy scenes by skipping texture and blending stages for occluded fragments (see REQ-005.04).
  Benefit scales with overdraw ratio; scenes with 2-3x overdraw may see 30-50% reduction in SDRAM texture bandwidth.
- Texture fragment latency: 4 cycles best-case (index cache hit + palette EBR lookup); miss latency adds an SDRAM index cache fill burst (~8 cycles for a 4×4 16-byte index block, not counting row activation overhead).
  A single-burst SDRAM palette load covers 4096 bytes (≈515 cycles) and is amortized across the lifetime of that palette slot.
  There is no L2-miss penalty path; the two-level L1/L2 hierarchy has been replaced by a single index cache tier.
- Color tile cache (UNIT-013) Port 1 utilisation: raster-order writes produce ~94%+ same-tile spatial locality, so Port 1 traffic is approximately 1/16 of the per-pixel rate (one 16-word burst eviction per tile instead of one write per pixel).
  Alpha-blend DST_COLOR reads no longer pay a per-pixel SDRAM round-trip; only a cache-miss fill burst (~16-word read) is issued on the first access to each tile.
- SDRAM sequential access: Improves effective SDRAM throughput for sequential access patterns (display scanout, texture cache fills, color tile cache eviction/fill) by amortizing row activation and CAS latency overhead across multiple column accesses. See INT-011 for SDRAM bandwidth budget.

Triangle setup latency includes sequential derivative precomputation in UNIT-005.03, which time-multiplexes 28 attribute derivative multiplications through shared MULT18X18D blocks.
The setup-iteration overlap FIFO (DD-035) absorbs this latency for sustained workloads; the impact is measurable only for scenes dominated by very small triangles where setup time exceeds iteration time.

These performance characteristics place the system in the N64-era capability range given the hardware constraints.
The dual-texture architecture with a dedicated color combiner aligns with N64/GeForce2 MX-era dual-texture-per-pass capabilities.
The index cache (32 sets × 1 way × 16 indices/line per sampler) holds 512 index entries per sampler at half resolution; spatial locality on typical low-poly scenes produces high hit rates for the 8-bit index array, reducing SDRAM index fill traffic.
Palette data is resident in on-chip EBR after firmware load, so palette lookup adds zero SDRAM traffic per fragment.
Best-case fragment latency through the texture sampler is 4 cycles (index cache hit + palette EBR lookup), down from ~8 cycles with the prior L1/L2 decoded cache hierarchy.

## Parent Requirements

- REQ-011 (System Constraints)

## Interfaces

- INT-010 (GPU Register Map)
- INT-011 (SDRAM Memory Layout)

## Verification Method

**Analysis:** Measure actual performance/resource usage against observations defined in quality_metrics.md:

- [ ] Measure triangle throughput for typical test scenes (flat, Gouraud, textured)
- [ ] Measure fill rate for typical pixel workloads (cache hit vs cache miss)
- [ ] Measure frame time for reference scenes (SpinningTeapot, low-poly animated model)
- [ ] Verify interactive frame rate (≥15 FPS) for target use case content
- [ ] Document actual performance observations in quality_metrics.md

## Notes

Performance targets are **content-dependent observations**, not fixed requirements.
See [quality_metrics.md](quality_metrics.md) for detailed performance measurements and analysis.

**Bandwidth scaling with FB_WIDTH_LOG2:**
Display scanout bandwidth scales proportionally to the configured source framebuffer width: `bandwidth ∝ (1 << FB_DISPLAY.FB_WIDTH_LOG2)`.
Reducing the source width (e.g. 256-wide with LINE_DOUBLE enabled) lowers display scanout bandwidth and increases available bandwidth for rendering.
The fill rate and triangle throughput observations in quality_metrics.md use a 512-wide source surface as the reference configuration; performance at other widths should be scaled accordingly.

Performance observations recorded in quality_metrics.md are measured on real FPGA hardware.
The Verilator interactive simulator uses a behavioral SDRAM model and may not precisely reflect hardware timing; fill rate and frame time measurements from simulation should be treated as approximations only.
See UNIT-007 for W9825G6KH timing parameters that the behavioral model must implement to bound the simulation error.

Specific resource constraints (FPGA LUT/EBR usage, SRAM/Flash budgets) are defined in REQ-011.02.
Reliability and timing constraints are defined in REQ-011.03 and quality_metrics.md.
