londey/pico-gs/integration/golden/ver_011_depth_test.png

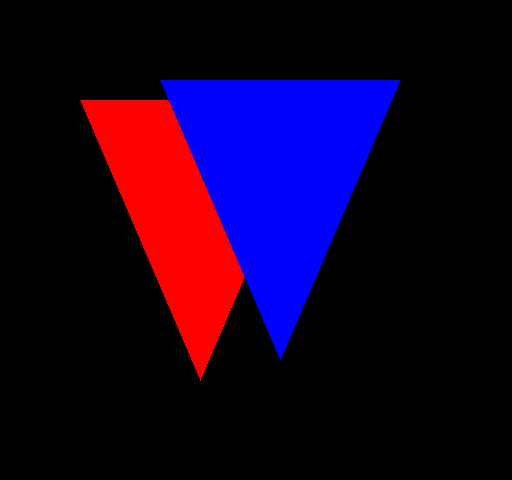
integration/golden/ver_011_depth_test.png
