londey/pico-gs/integration/golden/ver_023_stipple_test.png

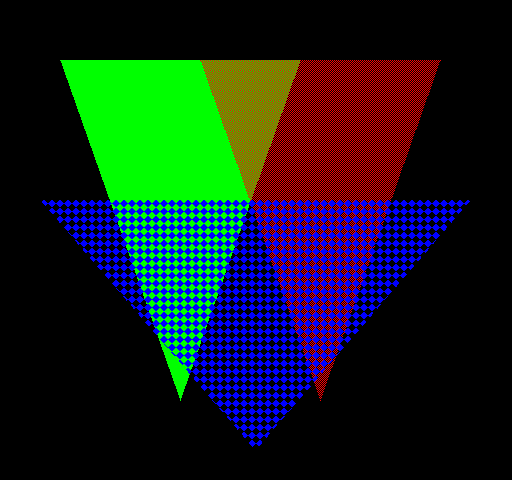
integration/golden/ver_023_stipple_test.png
