londey/pico-gs/pipeline/pipeline.yaml

# pipeline.yaml — GPU pipeline microarchitecture
# Single source of truth for units, resources, schedules, and status.

device:
  name: ECP5-25K
  dsp: 28
  ebr: 56
  lut4: 24000
  sdram_ports: 3

budget:
  dsp: 16
  ebr: 48     # Reflects actual unit accounting; previous 39 target was understated against real synth (was missing zbuf data + tag EBR).

# -- Hardware Units ----------------------------------------------------------

units:

  # -- Geometry --------------------------------------------------------------

  triangle_setup:
    name: Triangle Setup
    pipeline: geometry
    dsp: 2              # 2 MULT18X18D in raster_deriv (delta * inv_area)
    ebr: 2              # recip LUTs
    lut4: 600           # 1 shift-mul-47x11 (shared edge+init), down from 8+4
    status: verified
    rtl: [rasterizer.sv, raster_recip_area.sv, raster_deriv.sv]
    twin: gs-rasterizer
    stages:
      - id: edge_setup
        latency: 3
      - id: deriv_compute
        latency: 98     # 14 attributes sequential, 1 at a time
      - id: recip
        latency: 2
    notes: "Area-optimized: 1 shared 47x11 LUT mul, 2 DSPs. 98-cycle latency hidden behind pixel processing of previous triangle."

  block_rasterize:
    name: Block Rasterize (4x4)
    pipeline: geometry
    dsp: 0
    ebr: 0
    lut4: 500
    status: verified
    rtl: [raster_edge_walk.sv]
    twin: gs-rasterizer
    stages:
      - id: block_walk
        latency: 1

  hiz_test:
    name: Hi-Z Block Reject
    pipeline: geometry
    dsp: 0
    ebr: 8          # Hi-Z metadata DP16KD
    lut4: 200
    status: verified
    rtl: [raster_edge_walk.sv]
    twin: gs-rasterizer
    stages:
      - id: hiz_fetch
        latency: 1
      - id: hiz_compare
        latency: 1    # combinational, pipelined with fetch

  fragment_rasterize:
    name: Fragment Rasterize
    pipeline: geometry
    dsp: 6          # 4 persp correct + 2 edge eval
    ebr: 0
    lut4: 1000
    status: verified
    rtl: [raster_edge_walk.sv]
    twin: gs-rasterizer
    stages:
      - id: edge_eval
        latency: 1
      - id: persp_correct
        latency: 2

  # -- Pixel Pipeline --------------------------------------------------------

  stipple:
    name: Stipple Test
    pipeline: pixel
    dsp: 0
    ebr: 0
    lut4: 40
    status: verified
    rtl: [stipple.sv]
    twin: gs-stipple
    stages:
      - id: stipple_test
        latency: 0      # combinational
    can_kill: true

  z_cache:
    name: Z-Buffer Cache
    pipeline: pixel
    dsp: 0
    ebr: 7            # 2 data DP16KD + 4 tag PDPW16KD + 1 uninit DP16KD
    lut4: 2000        # FSM, valid/dirty/LRU register arrays, address arithmetic
    status: implemented
    rtl: [pixel_pipeline.sv]
    twin: gs-zbuf
    stages:
      - id: zcache_tag_fetch
        latency: 1
      - id: zcache_uninit_fetch
        latency: 1
      - id: zcache_value_fetch
        latency: 1
        stall: sdram_port_2    # cache miss -> SDRAM load
      - id: z_test
        latency: 0             # combinational compare
    can_kill: true

  tex_sampler:
    name: Texture Sampler
    pipeline: pixel
    dsp: 0              # NEAREST-only; no DSP required for filtering
    ebr: 16             # L1/L2 cache per sampler instance
    lut4: 2000
    status: in_progress
    rtl: [
      texture_sampler.sv,
      texture_uv_coord.sv,
      texture_cache_l1.sv,
      texture_l2_cache.sv,
      texture_block_decode.sv,
      texture_bc1.sv,
      texture_bc2.sv,
      texture_bc3.sv,
      texture_bc4.sv,
      texture_rgb565.sv,
      texture_rgba8888.sv,
      texture_r8.sv,
      texel_promote.sv,
    ]
    twin: gs-texture
    stages:
      - id: uv_wrap
        latency: 1
      - id: l1_tag_fetch
        latency: 1
      - id: l2_tag_fetch
        latency: 1
        conditional: l1_miss
      - id: l2_sdram_load
        latency: { best: 8, worst: 40 }
        stall: sdram_port_1
        conditional: l2_miss
      - id: l2_to_l1_decode
        latency: 1
        conditional: l2_miss
      - id: l1_sample
        latency: 1
      - id: filter
        latency: 0       # NEAREST pass-through (combinational)
    notes: >
      One physical unit, time-multiplexed for TEX0 and TEX1.
      16 EBR per sampler instance (4 banks x 4 EBR each).
      NEAREST-only filtering is active; no DSP is required for filtering.
      Top-level assembly of the L1/L2/block-decoder subunits into texture_sampler.sv
      is still in progress.

  color_combiner:
    name: Color Combiner
    pipeline: pixel
    dsp: 4              # (A-B)*C for RGB+A; single instance, 3-pass time-multiplexed
    ebr: 0
    lut4: 300
    status: implemented
    rtl: [color_combiner.sv]
    twin: gs-color-combiner
    stages:
      - id: cc_op
        latency: 1       # (A-B)*C+D, one pass per cycle
    notes: >
      One physical unit, time-multiplexed for 3 passes per fragment (CC0, CC1, CC2/blend).
      Pass 2 reads DST_COLOR from the color tile buffer for blend/fog.
      4-cycle/fragment throughput target with passes pipelined back-to-back.

  color_tile_cache:
    name: Color Tile Cache (UNIT-013)
    pipeline: pixel
    dsp: 0
    ebr: 7              # 2×DP16KD data + 4×PDPW16KD tag + 1×DP16KD uninit flags
    lut4: 250           # FSM + tag compare + address generation
    status: planned
    rtl: [color_tile_cache.sv, color_tile_tag_bram.sv]
    twin: gs-pixel-write
    design_doc: unit_013_color_tile_cache.md
    stages:
      - id: cache_lookup
        latency: 2      # Fast path: S_IDLE → S_RD_HIT (last-tag hit)
        stall: sdram_port_1    # Cache miss → SDRAM fill (16-word burst)
      - id: cache_write
        latency: 1      # S_WR_UPDATE (write hit)
        stall: sdram_port_1    # Cache miss before write → SDRAM fill then write
    notes: >
      4-way 32-set write-back EBR cache for RGB565 color-buffer access.
      Absorbs per-pixel SDRAM traffic; only dirty evictions and cache-miss fills
      use SDRAM port 1.  ~94% same-tile hit rate with 4×4 rasterization order.
      Software issues FB_CACHE_CTRL.FLUSH_TRIGGER before FB_DISPLAY swap.
      FB_CACHE_CTRL.INVALIDATE_TRIGGER resets uninit flags for lazy-fill after
      retargeting COLOR_BASE.  Exclusively owns SDRAM arbiter port 1.

  alpha_test:
    name: Alpha Test
    pipeline: pixel
    dsp: 0
    ebr: 0
    lut4: 20
    status: verified
    rtl: [pixel_pipeline.sv]
    twin: gs-twin-core
    stages:
      - id: alpha_compare
        latency: 0
    can_kill: true

  # alpha_blend: retired — blending is now implemented as color combiner pass 2 via color_tile_cache.

  dither:
    name: Ordered Dither
    pipeline: pixel
    dsp: 0
    ebr: 1            # blue noise matrix
    lut4: 100
    status: implemented
    rtl: [dither.sv]
    twin: gs-dither
    stages:
      - id: dither_lookup
        latency: 1

  pixel_output:
    name: Pixel Output
    pipeline: pixel
    dsp: 0
    ebr: 0
    lut4: 100
    status: implemented
    rtl: [pixel_pipeline.sv]
    twin: gs-pixel-write
    stages:
      - id: z_write
        latency: 1
        stall: sdram_port_2
      - id: color_write
        latency: 0          # writes to color_tile_cache (UNIT-013); SDRAM burst on dirty eviction

  # -- Display ---------------------------------------------------------------

  scanout:
    name: Scanout Controller
    pipeline: display
    dsp: 0
    ebr: 1           # scanline FIFO
    lut4: 500
    status: implemented
    rtl: [display_controller.sv]
    twin: gs-display
    stages:
      - id: scanout_read
        latency: 1
        stall: sdram_port_0

  color_grade:
    name: Color Grading LUT
    pipeline: display
    dsp: 0
    ebr: 2           # double-buffered LUT
    lut4: 100
    status: planned
    rtl: []
    stages:
      - id: cgrade_read
        latency: 1
      - id: cgrade_lookup
        latency: 1
      - id: cgrade_sum
        latency: 0

  dvi_output:
    name: DVI TMDS Output
    pipeline: display
    dsp: 0
    ebr: 0
    lut4: 200
    serdes: 4
    status: implemented
    rtl: [dvi_output.sv]
    stages:
      - id: tmds_encode
        latency: 1

  # -- Infrastructure (no pipeline stages) -----------------------------------

  spi_transport:
    name: SPI + Command FIFO
    pipeline: infrastructure
    dsp: 0
    ebr: 1
    lut4: 300
    status: verified
    rtl: [spi_slave.sv, command_fifo.sv]
    twin: gs-spi

  pll_reset:
    name: PLL + Reset
    pipeline: infrastructure
    dsp: 0
    ebr: 0
    lut4: 50
    status: verified
    rtl: [pll_wrapper.sv, reset_sync.sv]

# -- Schedules ---------------------------------------------------------------
# Each schedule shows one pixel's journey through the pipeline.
# Cycle numbers are best-case (all cache hits, no SDRAM stalls).
#
# Structure:
#   lead_in   — arrows before the first pipeline cycle (fragment arrival)
#   lead_out  — arrows after the last pipeline cycle (writeback)
#   groups    — named phases; each contains arrows from cycle.span to cycle.span
#               with a label (shown on the arrow) and unit (for validation)

schedules:

  single_tex:
    name: "Single Texture (4 cyc/pixel target)"
    cycles_per_pixel: 4
    lead_in:
      - from: -1
        to: 0
        span: fragment_ready
        label: "Fragment Created"
    groups:
      - name: "Early Fragment Test"
        arrows:
          - from: { cycle: 0, span: fragment_ready }
            to: { cycle: 1, span: early_test_complete }
            label: "Stipple Test"
            unit: stipple
          - from: { cycle: 0, span: fragment_ready }
            to: { cycle: 1, span: early_test_complete }
            label: "Z-Buffer Cache"
            unit: z_cache
      - name: "Texture Sampler [tex0]"
        arrows:
          - from: { cycle: 1, span: early_test_complete }
            to: { cycle: 2, span: textures_sampled }
            label: "Sample Texture"
            unit: tex_sampler
      - name: "Color Combiners"
        arrows:
          - from: { cycle: 2, span: textures_sampled }
            to: { cycle: 3, span: cc_pass0_complete }
            label: cc_pass0
            unit: color_combiner
          - from: { cycle: 3, span: cc_pass0_complete }
            to: { cycle: 4, span: cc_pass1_complete }
            label: cc_pass1
            unit: color_combiner
      - name: "Late Fragment Test"
        arrows:
          - from: { cycle: 4, span: cc_pass1_complete }
            to: { cycle: 5, span: final_fragment_value }
            label: "Alpha Test"
            unit: alpha_test
          - from: { cycle: 4, span: cc_pass1_complete }
            to: { cycle: 5, span: final_fragment_value }
            label: "Color Dither"
            unit: dither
      - name: "Fragment Output"
        arrows:
          - from: { cycle: 5, span: final_fragment_value }
            to: { cycle: 6, span: fragment_done }
            label: "Tile Buffer Write"
            unit: pixel_output
          - from: { cycle: 5, span: final_fragment_value }
            to: { cycle: 6, span: fragment_done }
            label: "Z-Cache Write"
            unit: pixel_output
    notes: >
      Assumes z-cache hit (no SDRAM stall), L1 cache hit (no L2/SDRAM),
      blend mode = NONE (no CC pass 2, no tile prefetch). Tile buffer flush burst
      issued at tile exit (amortized; not shown per-fragment).

  dual_tex:
    name: "Dual Texture (8 cyc/pixel target)"
    cycles_per_pixel: 8
    lead_in:
      - from: -1
        to: 0
        span: fragment_ready
        label: "Fragment Created"
    groups:
      - name: "Early Fragment Test"
        arrows:
          - from: { cycle: 0, span: fragment_ready }
            to: { cycle: 1, span: early_test_complete }
            label: "Stipple Test"
            unit: stipple
          - from: { cycle: 0, span: fragment_ready }
            to: { cycle: 1, span: early_test_complete }
            label: "Z-Buffer Cache"
            unit: z_cache
      - name: "Texture Sampler [tex0]"
        arrows:
          - from: { cycle: 1, span: early_test_complete }
            to: { cycle: 4, span: tex0_complete }
            label: "Sample Texture 0"
            unit: tex_sampler
      - name: "Texture Sampler [tex1]"
        arrows:
          - from: { cycle: 4, span: tex0_complete }
            to: { cycle: 7, span: textures_sampled }
            label: "Sample Texture 1"
            unit: tex_sampler
      - name: "Color Combiners"
        arrows:
          - from: { cycle: 7, span: textures_sampled }
            to: { cycle: 8, span: cc_pass0_complete }
            label: cc_pass0
            unit: color_combiner
          - from: { cycle: 8, span: cc_pass0_complete }
            to: { cycle: 9, span: cc_pass1_complete }
            label: cc_pass1
            unit: color_combiner
      - name: "Late Fragment Test"
        arrows:
          - from: { cycle: 9, span: cc_pass1_complete }
            to: { cycle: 10, span: final_fragment_value }
            label: "Alpha Test"
            unit: alpha_test
          - from: { cycle: 9, span: cc_pass1_complete }
            to: { cycle: 10, span: final_fragment_value }
            label: "Color Dither"
            unit: dither
      - name: "Fragment Output"
        arrows:
          - from: { cycle: 10, span: final_fragment_value }
            to: { cycle: 11, span: fragment_done }
            label: "Tile Buffer Write"
            unit: pixel_output
          - from: { cycle: 10, span: final_fragment_value }
            to: { cycle: 11, span: fragment_done }
            label: "Z-Cache Write"
            unit: pixel_output
    notes: >
      Texture sampler time-multiplexed: TEX0 then TEX1.
      CC overlaps with late TEX1 stages if possible.
      Blend mode = NONE assumed (no CC pass 2). Tile buffer flush burst issued at tile exit.

  single_tex_blend:
    name: "Single Texture + Alpha Blend (3-pass CC)"
    cycles_per_pixel: 4
    lead_in:
      - from: -1
        to: 0
        span: fragment_ready
        label: "Fragment Created"
    groups:
      - name: "Early Fragment Test"
        arrows:
          - from: { cycle: 0, span: fragment_ready }
            to: { cycle: 1, span: early_test_complete }
            label: "Stipple Test"
            unit: stipple
          - from: { cycle: 0, span: fragment_ready }
            to: { cycle: 1, span: early_test_complete }
            label: "Z-Buffer Cache"
            unit: z_cache
      - name: "Texture Sampler [tex0]"
        arrows:
          - from: { cycle: 1, span: early_test_complete }
            to: { cycle: 2, span: textures_sampled }
            label: "Sample Texture"
            unit: tex_sampler
      - name: "Color Combiners"
        arrows:
          - from: { cycle: 2, span: textures_sampled }
            to: { cycle: 3, span: cc_pass0_complete }
            label: cc_pass0
            unit: color_combiner
          - from: { cycle: 3, span: cc_pass0_complete }
            to: { cycle: 4, span: cc_pass1_complete }
            label: cc_pass1
            unit: color_combiner
          - from: { cycle: 4, span: cc_pass1_complete }
            to: { cycle: 5, span: cc_pass2_complete }
            label: "cc_pass2 (DST_COLOR)"
            unit: color_combiner
      - name: "Late Fragment Test"
        arrows:
          - from: { cycle: 5, span: cc_pass2_complete }
            to: { cycle: 6, span: final_fragment_value }
            label: "Alpha Test"
            unit: alpha_test
          - from: { cycle: 5, span: cc_pass2_complete }
            to: { cycle: 6, span: final_fragment_value }
            label: "Color Dither"
            unit: dither
      - name: "Fragment Output"
        arrows:
          - from: { cycle: 6, span: final_fragment_value }
            to: { cycle: 7, span: fragment_done }
            label: "Tile Buffer Write"
            unit: pixel_output
          - from: { cycle: 6, span: final_fragment_value }
            to: { cycle: 7, span: fragment_done }
            label: "Z-Cache Write"
            unit: pixel_output
    notes: >
      CC pass 2 reads DST_COLOR from the color tile buffer (on-chip; no SDRAM stall per fragment).
      Tile buffer was pre-fetched (16-word burst read) at tile entry.
      Tile buffer flushed (16-word burst write) at tile exit.
      4-cycle/fragment throughput maintained: tile buffer read/write amortized over 16 fragments per tile.
      Assumes z-cache hit, L1 texture cache hit.
