londey/pico-gs/rtl/top/gpu_top.sv

`default_nettype none
// Spec-ref: unit_005.06_hiz_block_metadata.md `4c168133e627c4f6` 2026-04-13

// ICEpi SPI GPU - Top Level Module
// Version 3.0 - Pixel Pipeline Integration
//
// This module integrates all GPU subsystems:
// - Clock generation (PLL)
// - Reset synchronization
// - SPI interface
// - Memory subsystem (SDRAM controller and arbiter)
// - Display pipeline (timing, scanline FIFO, DVI output)
// - Rendering pipeline (rasterizer -> pixel pipeline -> color combiner -> FB/Z write)
//
// The rasterizer (UNIT-005) emits fragments via valid/ready handshake to
// the pixel pipeline (UNIT-006), which owns arbiter ports 1 and 2 (DD-025).
// The color combiner (UNIT-010) sits between the pixel pipeline's pre-combiner
// output and post-combiner input.

module gpu_top (
    // ==== Clock and Reset ====
    input  wire         clk_50,             // 50 MHz board oscillator
    input  wire         rst_n,              // Active-low reset

    // ==== SPI Interface (from RP2350) ====
    input  wire         spi_sck,            // SPI clock (up to 40 MHz)
    input  wire         spi_mosi,           // SPI data in
    output wire         spi_miso,           // SPI data out
    input  wire         spi_cs_n,           // SPI chip select (active-low)

    // ==== GPIO Status Outputs (to RP2350) ====
    output wire         gpio_cmd_full,      // Command buffer near-full warning
    output wire         gpio_cmd_empty,     // Command buffer empty (safe to read registers)
    output wire         gpio_vsync,         // Vertical sync pulse

    // ==== SDRAM Interface (32MB W9825G6KH-6, 16-bit synchronous) ====
    output wire         sdram_clk,          // 100 MHz clock, 90-degree phase shift from clk_core
    output wire         sdram_cke,          // Clock enable (active high)
    output wire         sdram_csn,          // Chip select (active low)
    output wire         sdram_rasn,         // Row address strobe (active low)
    output wire         sdram_casn,         // Column address strobe (active low)
    output wire         sdram_wen,          // Write enable (active low)
    output wire [1:0]   sdram_ba,           // Bank address
    output wire [12:0]  sdram_a,            // Address bus (row: A[12:0], column: A[8:0])
    inout  wire [15:0]  sdram_dq,           // Bidirectional data bus
    output wire [1:0]   sdram_dqm,          // Data mask (upper/lower byte)

    // ==== DVI/HDMI Output (TMDS differential) ====
    output wire [2:0]   tmds_data_p,        // TMDS data channels (positive)
    output wire [2:0]   tmds_data_n,        // TMDS data channels (negative)
    output wire         tmds_clk_p,         // TMDS clock (positive)
    output wire         tmds_clk_n          // TMDS clock (negative)
);

    // ========================================================================
    // Clock and Reset Infrastructure
    // ========================================================================

    // Internal clock signals
    wire clk_core;          // 100 MHz unified GPU core/SDRAM clock
    wire clk_pixel;         // 25.000 MHz pixel clock (clk_core / 4)
    wire clk_tmds;          // 250.0 MHz TMDS bit clock (10x pixel clock)
    wire clk_sdram;         // 100 MHz SDRAM chip clock, 90-degree phase shift
    wire pll_locked;        // PLL lock indicator

    // Synchronized reset signals for each clock domain
    wire rst_n_core;        // Reset synchronized to clk_core
    wire rst_n_pixel;       // Reset synchronized to clk_pixel
    wire rst_n_tmds;        // Reset synchronized to clk_tmds

    // PLL instantiation
    pll_core u_pll (
        .clk_50_in(clk_50),
        .rst_n(rst_n),
        .clk_core(clk_core),
        .clk_pixel(clk_pixel),
        .clk_tmds(clk_tmds),
        .clk_sdram(clk_sdram),
        .pll_locked(pll_locked)
    );

    // Route SDRAM clock directly from PLL to top-level output
    assign sdram_clk = clk_sdram;

    // Reset synchronizers for each clock domain
    reset_sync u_reset_sync_core (
        .clk(clk_core),
        .rst_n_async(rst_n),
        .pll_locked(pll_locked),
        .rst_n_sync(rst_n_core)
    );

    reset_sync u_reset_sync_pixel (
        .clk(clk_pixel),
        .rst_n_async(rst_n),
        .pll_locked(pll_locked),
        .rst_n_sync(rst_n_pixel)
    );

    reset_sync u_reset_sync_tmds (
        .clk(clk_tmds),
        .rst_n_async(rst_n),
        .pll_locked(pll_locked),
        .rst_n_sync(rst_n_tmds)
    );

    // ========================================================================
    // SPI Interface (Phase 2 - Implemented)
    // ========================================================================

    // SPI slave interface signals
    wire        spi_valid;
    wire        spi_rw;
    wire [6:0]  spi_addr;
    wire [63:0] spi_wdata;
    wire [63:0] spi_rdata;

    // Command FIFO signals
    wire        fifo_wr_en;
    wire [71:0] fifo_wr_data;
    wire        fifo_wr_full;
    wire        fifo_wr_almost_full /* verilator public */;
    wire        fifo_rd_en;
    wire [71:0] fifo_rd_data;
    wire        fifo_rd_empty;
    wire [9:0]  fifo_rd_count;

    // Register file signals
`ifdef SIM_DIRECT_REG
    wire        reg_cmd_valid;
`else
    reg         reg_cmd_valid;
`endif
    wire        reg_cmd_rw;
    wire [6:0]  reg_cmd_addr;
    wire [63:0] reg_cmd_wdata;
    wire [63:0] reg_cmd_rdata;

    // Triangle output signals (from register_file vertex state machine)
    wire        tri_valid /* verilator public */;
    wire [2:0][15:0] tri_x;
    wire [2:0][15:0] tri_y;
    wire [2:0][15:0] tri_z;
    wire [2:0][15:0] tri_q;
    wire [2:0][31:0] tri_color0;    // Diffuse RGBA8888 per vertex
    wire [2:0][31:0] tri_color1;    // Specular RGBA8888 per vertex
    wire [2:0][31:0] tri_st0;
    wire [2:0][31:0] tri_st1;

    // Rectangle output
    wire rect_valid;

    // Rendering mode signals (from RENDER_MODE register)
    wire        mode_gouraud;
    wire        mode_z_test;
    wire        mode_z_write;
    wire        mode_color_write;
    wire [1:0]  mode_cull;
    wire        mode_dither_en;
    wire [1:0]  mode_dither_pattern;
    wire [2:0]  mode_z_compare;
    wire        mode_stipple_en;
    wire [1:0]  mode_alpha_test;
    wire [7:0]  mode_alpha_ref;

    // Depth range clipping
    wire [15:0] z_range_min;
    wire [15:0] z_range_max;

    // Stipple pattern
    wire [63:0] stipple_pattern;

    // Framebuffer configuration (FB_CONFIG)
    wire [15:0] fb_color_base;      // Color buffer base (x512 byte addr)
    wire [15:0] fb_z_base;          // Z buffer base (x512 byte addr)
    wire [3:0]  fb_width_log2;
    wire [3:0]  fb_height_log2;

    // Scissor rectangle (FB_CONTROL)
    wire [9:0]  scissor_x;
    wire [9:0]  scissor_y;
    wire [9:0]  scissor_width;
    wire [9:0]  scissor_height;

    // Framebuffer config trigger (FB_CONFIG write pulse)
    wire        fb_config_trigger;

    // Memory fill (MEM_FILL)
    wire        mem_fill_trigger;
    wire [23:0] mem_fill_base;
    wire [15:0] mem_fill_value;
    wire [19:0] mem_fill_count;

    // Display configuration (FB_DISPLAY)
    wire [15:0] fb_lut_addr;
    wire [15:0] fb_display_addr;
    wire [3:0]  fb_display_width_log2;
    wire        fb_line_double;
    wire        color_grade_enable;

    // Color combiner
    wire [63:0] cc_mode;
    wire [31:0] cc_mode_2;
    wire [63:0] const_color;

    // Texture configuration
    wire [63:0] tex0_cfg;
    wire [63:0] tex1_cfg;
    wire        tex0_cache_inv;
    wire        tex1_cache_inv;

    // Palette load triggers (from register_file → texture_sampler via
    // pixel_pipeline forwarding).
    wire        palette0_load_trigger;
    wire [15:0] palette0_base_addr;
    wire        palette1_load_trigger;
    wire [15:0] palette1_base_addr;

    // Memory access (MEM_ADDR / MEM_DATA)
    wire [63:0] mem_addr_out;
    wire [63:0] mem_data_out;
    wire        mem_data_wr;
    wire [21:0] mem_data_dword_addr;
    wire        mem_data_rd;

    // Timestamp SDRAM write signals (register_file → arbiter port 3)
    wire        ts_mem_wr;
    wire [22:0] ts_mem_addr;
    wire [31:0] ts_mem_data;

    // Status signals
    wire gpu_busy /* verilator public */;
    wire vblank;

    // SPI Slave instantiation
    spi_slave u_spi_slave (
        .spi_sck(spi_sck),
        .spi_mosi(spi_mosi),
        .spi_miso(spi_miso),
        .spi_cs_n(spi_cs_n),
        .sys_clk(clk_core),
        .sys_rst_n(rst_n_core),
        .valid(spi_valid),
        .rw(spi_rw),
        .addr(spi_addr),
        .wdata(spi_wdata),
        .rdata(spi_rdata)
    );

    // Pack SPI transaction into FIFO format (synthesis) or sim injection (simulation)
    `ifdef SIM_DIRECT_CMD
        // Sim-only: direct command injection bypasses UNIT-001 (see UNIT-002)
        // Signals driven by the Verilator C++ wrapper (gpu_sim.cpp)
        /* verilator lint_off UNDRIVEN */
        logic        sim_cmd_valid  /* verilator public */;  // Sim write enable
        logic        sim_cmd_rw     /* verilator public */;  // R/W flag (matches INT-012 bit 71)
        logic [6:0]  sim_cmd_addr   /* verilator public */;  // Register address (matches INT-012 bits 70:64)
        logic [63:0] sim_cmd_wdata  /* verilator public */;  // Write data (matches INT-012 bits 63:0)
        /* verilator lint_on UNDRIVEN */
        assign fifo_wr_en   = sim_cmd_valid;
        assign fifo_wr_data = {sim_cmd_rw, sim_cmd_addr, sim_cmd_wdata};
    `else
        assign fifo_wr_en   = spi_valid;
        assign fifo_wr_data = {spi_rw, spi_addr, spi_wdata};
    `endif

    // Command FIFO instantiation (with boot pre-population)
    command_fifo u_cmd_fifo (
        .wr_clk(clk_core),
        .wr_rst_n(rst_n_core),
        .wr_en(fifo_wr_en),
        .wr_data(fifo_wr_data),
        .wr_full(fifo_wr_full),
        .wr_almost_full(fifo_wr_almost_full),
        .rd_clk(clk_core),
        .rd_rst_n(rst_n_core),
        .rd_en(fifo_rd_en),
        .rd_data(fifo_rd_data),
        .rd_empty(fifo_rd_empty),
        .rd_count(fifo_rd_count)
    );

`ifdef SIM_DIRECT_REG
    // Sim-only: direct register file injection bypasses both SPI and command FIFO.
    // Signals driven by the Verilator C++ harness (harness.cpp).
    /* verilator lint_off UNDRIVEN */
    logic        sim_reg_valid  /* verilator public */;  // Register write strobe
    logic        sim_reg_rw     /* verilator public */;  // R/W flag (0=write)
    logic [6:0]  sim_reg_addr   /* verilator public */;  // Register address
    logic [63:0] sim_reg_wdata  /* verilator public */;  // Write data
    logic        sim_zcache_flush /* verilator public */ = 1'b0; // Z-cache flush trigger (reserved)
    /* verilator lint_on UNDRIVEN */

    assign reg_cmd_valid = sim_reg_valid;
    assign reg_cmd_rw    = sim_reg_rw;
    assign reg_cmd_addr  = sim_reg_addr;
    assign reg_cmd_wdata = sim_reg_wdata;
    assign fifo_rd_en    = 1'b0;  // FIFO disabled in direct-reg mode
`else
    // Unpack FIFO data to register interface (data path is combinational —
    // async_fifo already registers rd_data, so it aligns with the pipelined valid)
    assign reg_cmd_rw = fifo_rd_data[71];
    assign reg_cmd_addr = fifo_rd_data[70:64];
    assign reg_cmd_wdata = fifo_rd_data[63:0];
    assign fifo_rd_en = !fifo_rd_empty && !gpu_busy;  // Read when data available and GPU not busy

    // Pipeline cmd_valid by one cycle to match async_fifo read latency.
    // The FIFO uses a standard (non-FWFT) read: rd_data updates one cycle
    // after rd_en fires.  Delaying valid by the same amount ensures the
    // register file sees valid HIGH in the same cycle that rd_data is stable.
    always_ff @(posedge clk_core or negedge rst_n_core) begin
        if (!rst_n_core)
            reg_cmd_valid <= 1'b0;
        else
            reg_cmd_valid <= fifo_rd_en;
    end
`endif

    // Register File instantiation (INT-010 v10.0)
    register_file u_register_file (
        .clk(clk_core),
        .rst_n(rst_n_core),

        // Register interface (from command FIFO)
        .cmd_valid(reg_cmd_valid),
        .cmd_rw(reg_cmd_rw),
        .cmd_addr(reg_cmd_addr),
        .cmd_wdata(reg_cmd_wdata),
        .cmd_rdata(reg_cmd_rdata),

        // Triangle output
        .tri_valid(tri_valid),
        .tri_x(tri_x),
        .tri_y(tri_y),
        .tri_z(tri_z),
        .tri_q(tri_q),
        .tri_color0(tri_color0),
        .tri_color1(tri_color1),
        .tri_st0(tri_st0),
        .tri_st1(tri_st1),

        // Rectangle output
        .rect_valid(rect_valid),

        // Rendering mode flags
        .mode_gouraud(mode_gouraud),
        .mode_z_test(mode_z_test),
        .mode_z_write(mode_z_write),
        .mode_color_write(mode_color_write),
        .mode_cull(mode_cull),
        .mode_dither_en(mode_dither_en),
        .mode_dither_pattern(mode_dither_pattern),
        .mode_z_compare(mode_z_compare),
        .mode_stipple_en(mode_stipple_en),
        .mode_alpha_test(mode_alpha_test),
        .mode_alpha_ref(mode_alpha_ref),

        // Depth range
        .z_range_min(z_range_min),
        .z_range_max(z_range_max),

        // Stipple
        .stipple_pattern(stipple_pattern),

        // Framebuffer configuration
        .fb_color_base(fb_color_base),
        .fb_z_base(fb_z_base),
        .fb_width_log2(fb_width_log2),
        .fb_height_log2(fb_height_log2),

        // Scissor rectangle
        .scissor_x(scissor_x),
        .scissor_y(scissor_y),
        .scissor_width(scissor_width),
        .scissor_height(scissor_height),

        // Framebuffer config trigger
        .fb_config_trigger(fb_config_trigger),

        // Memory fill
        .mem_fill_trigger(mem_fill_trigger),
        .mem_fill_base(mem_fill_base),
        .mem_fill_value(mem_fill_value),
        .mem_fill_count(mem_fill_count),

        // Display configuration
        .fb_lut_addr(fb_lut_addr),
        .fb_display_addr(fb_display_addr),
        .fb_display_width_log2(fb_display_width_log2),
        .fb_line_double(fb_line_double),
        .color_grade_enable(color_grade_enable),

        // Color combiner
        .cc_mode(cc_mode),
        .cc_mode_2(cc_mode_2),
        .const_color(const_color),

        // Texture configuration
        .tex0_cfg(tex0_cfg),
        .tex1_cfg(tex1_cfg),
        .tex0_cache_inv(tex0_cache_inv),
        .tex1_cache_inv(tex1_cache_inv),

        // Palette slot load triggers (UNIT-011.06 via UNIT-006/UNIT-011)
        .palette0_load_trigger(palette0_load_trigger),
        .palette0_base_addr   (palette0_base_addr),
        .palette1_load_trigger(palette1_load_trigger),
        .palette1_base_addr   (palette1_base_addr),

        // Memory access
        .mem_addr_out(mem_addr_out),
        .mem_data_out(mem_data_out),
        .mem_data_wr(mem_data_wr),
        .mem_data_dword_addr(mem_data_dword_addr),
        .mem_data_rd(mem_data_rd),
        .mem_data_in(64'h0),           // TODO: connect to SDRAM read path

        // Timestamp SDRAM write
        .ts_mem_wr(ts_mem_wr),
        .ts_mem_addr(ts_mem_addr),
        .ts_mem_data(ts_mem_data),

        // FB_CACHE_CTRL handshake with color tile cache (UNIT-013)
        .fb_cache_flush_trigger(rf_fb_cache_flush_trigger),
        .fb_cache_invalidate_trigger(rf_fb_cache_invalidate_trigger),
        .flush_done(ctcache_flush_done),
        .invalidate_done(ctcache_invalidate_done),

        // Status inputs
        .gpu_busy(gpu_busy),
        .vblank(vblank),
        .vsync_edge(disp_frame_start), // Use frame_start as vsync edge proxy
        .fifo_depth(fifo_rd_count[7:0])
    );

    // Route register file read data back to SPI slave for read transactions
    assign spi_rdata = reg_cmd_rdata;

    // GPIO outputs
    assign gpio_cmd_full = fifo_wr_almost_full;
    assign gpio_cmd_empty = fifo_rd_empty && !reg_cmd_valid;

    // Stall the command FIFO when the rasterizer cannot accept a new triangle.
    // This prevents VERTEX_KICK pulses from being lost while the rasterizer is
    // busy processing the previous triangle.
    wire dma_busy;
    assign gpu_busy = !rast_ready || dma_busy || rast_hiz_clear_busy;
    // vblank is assigned from display timing generator (see display section)

    // ========================================================================
    // Memory Subsystem (Phase 3 - SDRAM)
    // ========================================================================

    // Arbiter port signals
    wire        arb_port0_req;
    wire        arb_port0_we;
    wire [23:0] arb_port0_addr;
    wire [31:0] arb_port0_wdata;
    wire [7:0]  arb_port0_burst_len;
    wire [31:0] arb_port0_rdata;
    wire [15:0] arb_port0_burst_rdata;
    wire        arb_port0_burst_data_valid;
    wire        arb_port0_burst_wdata_req;
    wire        arb_port0_ack;
    wire        arb_port0_ready;

    wire        arb_port1_req /* verilator public */;
    wire        arb_port1_we;
    wire [23:0] arb_port1_addr /* verilator public */;
    wire [31:0] arb_port1_wdata /* verilator public */;
    wire [7:0]  arb_port1_burst_len;
    wire [15:0] arb_port1_burst_wdata;
    wire [31:0] arb_port1_rdata;
    wire [15:0] arb_port1_burst_rdata;
    wire        arb_port1_burst_data_valid;
    wire        arb_port1_burst_wdata_req;
    wire        arb_port1_ack;
    wire        arb_port1_ready;

    wire        arb_port2_req;
    wire        arb_port2_we;
    wire [23:0] arb_port2_addr;
    wire [31:0] arb_port2_wdata;
    wire [7:0]  arb_port2_burst_len;
    wire [15:0] arb_port2_burst_wdata;
    wire [31:0] arb_port2_rdata;
    wire [15:0] arb_port2_burst_rdata;
    wire        arb_port2_burst_data_valid;
    wire        arb_port2_burst_wdata_req;
    wire        arb_port2_ack;
    wire        arb_port2_ready;

    wire        arb_port3_req;
    wire        arb_port3_we;
    wire [23:0] arb_port3_addr;
    wire [31:0] arb_port3_wdata;
    wire [7:0]  arb_port3_burst_len;
    wire        arb_port3_burst_col_step2;
    wire [15:0] arb_port3_burst_wdata;
    wire [31:0] arb_port3_rdata;
    wire [15:0] arb_port3_burst_rdata;
    wire        arb_port3_burst_data_valid;
    wire        arb_port3_burst_wdata_req;
    wire        arb_port3_ack;
    wire        arb_port3_ready;

    // Memory controller signals (single-word)
    wire        mem_ctrl_req;
    wire        mem_ctrl_we;
    wire [23:0] mem_ctrl_addr;
    wire [31:0] mem_ctrl_wdata;
    wire [31:0] mem_ctrl_rdata;
    wire        mem_ctrl_ack;
    wire        mem_ctrl_ready;

    // Memory controller signals (burst)
    wire [7:0]  mem_ctrl_burst_len;
    wire        mem_ctrl_burst_col_step2;
    wire [15:0] mem_ctrl_burst_wdata;
    wire        mem_ctrl_burst_cancel;
    wire        mem_ctrl_burst_data_valid;
    wire        mem_ctrl_burst_wdata_req;
    wire        mem_ctrl_burst_done;
    wire [15:0] mem_ctrl_rdata_16;

    // Memory Arbiter instantiation
    sram_arbiter u_sram_arbiter (
        .clk(clk_core),
        .rst_n(rst_n_core),

        // Port 0: Display Read
        .port0_req(arb_port0_req),
        .port0_we(arb_port0_we),
        .port0_addr(arb_port0_addr),
        .port0_wdata(arb_port0_wdata),
        .port0_burst_len(arb_port0_burst_len),
        .port0_rdata(arb_port0_rdata),
        .port0_burst_rdata(arb_port0_burst_rdata),
        .port0_burst_data_valid(arb_port0_burst_data_valid),
        .port0_burst_wdata_req(arb_port0_burst_wdata_req),
        .port0_ack(arb_port0_ack),
        .port0_ready(arb_port0_ready),

        // Port 1: Framebuffer Write
        .port1_req(arb_port1_req),
        .port1_we(arb_port1_we),
        .port1_addr(arb_port1_addr),
        .port1_wdata(arb_port1_wdata),
        .port1_burst_len(arb_port1_burst_len),
        .port1_burst_col_step2(1'b1), // Color tile cache: stride-2 (byte-addressed RGB565 FB convention)
        .port1_burst_wdata(arb_port1_burst_wdata),
        .port1_rdata(arb_port1_rdata),
        .port1_burst_rdata(arb_port1_burst_rdata),
        .port1_burst_data_valid(arb_port1_burst_data_valid),
        .port1_burst_wdata_req(arb_port1_burst_wdata_req),
        .port1_ack(arb_port1_ack),
        .port1_ready(arb_port1_ready),

        // Port 2: Z-Buffer Read/Write
        .port2_req(arb_port2_req),
        .port2_we(arb_port2_we),
        .port2_addr(arb_port2_addr),
        .port2_wdata(arb_port2_wdata),
        .port2_burst_len(arb_port2_burst_len),
        .port2_burst_col_step2(1'b1), // Z-cache tiles: stride-2 (word-aligned 16-bit values)
        .port2_burst_wdata(arb_port2_burst_wdata),
        .port2_rdata(arb_port2_rdata),
        .port2_burst_rdata(arb_port2_burst_rdata),
        .port2_burst_data_valid(arb_port2_burst_data_valid),
        .port2_burst_wdata_req(arb_port2_burst_wdata_req),
        .port2_ack(arb_port2_ack),
        .port2_ready(arb_port2_ready),

        // Port 3: Texture Read
        .port3_req(arb_port3_req),
        .port3_we(arb_port3_we),
        .port3_addr(arb_port3_addr),
        .port3_wdata(arb_port3_wdata),
        .port3_burst_len(arb_port3_burst_len),
        .port3_burst_col_step2(arb_port3_burst_col_step2),
        .port3_burst_wdata(arb_port3_burst_wdata),
        .port3_rdata(arb_port3_rdata),
        .port3_burst_rdata(arb_port3_burst_rdata),
        .port3_burst_data_valid(arb_port3_burst_data_valid),
        .port3_burst_wdata_req(arb_port3_burst_wdata_req),
        .port3_ack(arb_port3_ack),
        .port3_ready(arb_port3_ready),

        // To memory controller — single-word
        .mem_req(mem_ctrl_req),
        .mem_we(mem_ctrl_we),
        .mem_addr(mem_ctrl_addr),
        .mem_wdata(mem_ctrl_wdata),
        .mem_rdata(mem_ctrl_rdata),
        .mem_ack(mem_ctrl_ack),
        .mem_ready(mem_ctrl_ready),

        // To memory controller — burst
        .mem_burst_len(mem_ctrl_burst_len),
        .mem_burst_col_step2(mem_ctrl_burst_col_step2),
        .mem_burst_wdata(mem_ctrl_burst_wdata),
        .mem_burst_cancel(mem_ctrl_burst_cancel),
        .mem_burst_data_valid(mem_ctrl_burst_data_valid),
        .mem_burst_wdata_req(mem_ctrl_burst_wdata_req),
        .mem_burst_done(mem_ctrl_burst_done),
        .mem_rdata_16(mem_ctrl_rdata_16)
    );

    // SDRAM Controller instantiation
    sdram_controller u_sdram_controller (
        .clk(clk_core),
        .rst_n(rst_n_core),

        // From arbiter — single-word
        .req(mem_ctrl_req),
        .we(mem_ctrl_we),
        .addr(mem_ctrl_addr),
        .wdata(mem_ctrl_wdata),
        .rdata(mem_ctrl_rdata),
        .ack(mem_ctrl_ack),
        .ready(mem_ctrl_ready),

        // From arbiter — burst
        .burst_len(mem_ctrl_burst_len),
        .burst_col_step2(mem_ctrl_burst_col_step2),
        .burst_wdata_16(mem_ctrl_burst_wdata),
        .burst_cancel(mem_ctrl_burst_cancel),
        .burst_data_valid(mem_ctrl_burst_data_valid),
        .burst_wdata_req(mem_ctrl_burst_wdata_req),
        .burst_done(mem_ctrl_burst_done),
        .rdata_16(mem_ctrl_rdata_16),

        // To external SDRAM (sdram_clk driven directly from PLL output)
        .sdram_cke(sdram_cke),
        .sdram_csn(sdram_csn),
        .sdram_rasn(sdram_rasn),
        .sdram_casn(sdram_casn),
        .sdram_wen(sdram_wen),
        .sdram_ba(sdram_ba),
        .sdram_a(sdram_a),
        .sdram_dq(sdram_dq),
        .sdram_dqm(sdram_dqm)
    );

    // Temporary port assignments
    // Port 0: Display controller burst signals now driven by u_display_ctrl

    // Port 1: Color tile cache (UNIT-013) — burst-16 for both fill reads
    // and eviction writes.  All port-1 SDRAM transfers move a complete
    // 4×4 tile (16 × 16-bit words).  Driven from the cache below.

    // Port 2: Z-buffer tile cache (burst-16: full 4×4 tile per SDRAM request)
    assign arb_port2_burst_len = (zcache_sdram_wr_req || zcache_sdram_rd_req) ? 8'd16 : 8'd0;
    assign arb_port2_burst_wdata = zcache_sdram_wr_data;

    // ========================================================================
    // Memory DMA Engine (MEM_DATA / MEM_FILL write path)
    // ========================================================================

    wire        dma_req;
    wire        dma_we;
    wire [23:0] dma_addr;
    wire [7:0]  dma_burst_len;
    wire        dma_burst_col_step2;
    wire [15:0] dma_burst_wdata;
    wire        dma_ack;
    wire        dma_burst_wdata_req;

    mem_dma u_mem_dma (
        .clk              (clk_core),
        .rst_n            (rst_n_core),
        .mem_data_wr      (mem_data_wr),
        .mem_data         (mem_data_out),
        .mem_dword_addr   (mem_data_dword_addr),
        .mem_fill_trigger (mem_fill_trigger),
        .mem_fill_base    (mem_fill_base),
        .mem_fill_value   (mem_fill_value),
        .mem_fill_count   (mem_fill_count),
        .dma_req          (dma_req),
        .dma_we           (dma_we),
        .dma_addr         (dma_addr),
        .dma_burst_len    (dma_burst_len),
        .dma_burst_col_step2 (dma_burst_col_step2),
        .dma_burst_wdata  (dma_burst_wdata),
        .dma_busy         (dma_busy),
        .dma_ack          (dma_ack),
        .dma_ready        (arb_port3_ready),
        .dma_burst_wdata_req (dma_burst_wdata_req)
    );

    // Port 3: Texture cache fill reads + DMA writes + PERF_TIMESTAMP writes (DD-026)
    //
    // Port 3 is shared between:
    //   - Texture cache fill burst reads from pixel_pipeline (UNIT-006)
    //   - MEM_DATA/MEM_FILL DMA burst writes from register_file
    //   - PERF_TIMESTAMP single-word SDRAM writes from register_file (UNIT-003)
    //
    // Texture fill requests take priority; timestamp writes are
    // fire-and-forget with coalescing semantics.
    //
    // Grant tracking:
    //   tex_req_granted — set when texture request wins port 3 grant;
    //                     cleared on arb_port3_ack
    //   ts_req_granted  — set when timestamp write wins port 3 grant;
    //                     cleared on arb_port3_ack

    // Texture cache port 3 wires (from pixel_pipeline, UNIT-006)
    wire        tex_req       = pp_tex_sram_req;
    wire [23:0] tex_addr      = pp_tex_sram_addr;
    wire [7:0]  tex_burst_len = pp_tex_sram_burst_len;
    wire [15:0] tex_burst_rdata;
    wire        tex_burst_data_valid;
    wire        tex_ack;

    // Timestamp pending register (fire-and-forget, coalescing)
    reg         ts_pending;
    reg  [23:0] ts_arb_addr;
    reg  [31:0] ts_arb_wdata;

    // Grant tracking registers
    reg         tex_req_granted;
    reg         dma_req_granted;
    reg         ts_req_granted;

    // Next-state signals for port 3 sharing FSM
    logic        next_ts_pending;
    logic [23:0] next_ts_arb_addr;
    logic [31:0] next_ts_arb_wdata;
    logic        next_tex_req_granted;
    logic        next_dma_req_granted;
    logic        next_ts_req_granted;

    always_comb begin
        next_ts_pending       = ts_pending;
        next_ts_arb_addr      = ts_arb_addr;
        next_ts_arb_wdata     = ts_arb_wdata;
        next_tex_req_granted  = tex_req_granted;
        next_dma_req_granted  = dma_req_granted;
        next_ts_req_granted   = ts_req_granted;

        // Latch new timestamp write request (coalescing: overwrites pending)
        if (ts_mem_wr) begin
            next_ts_pending  = 1'b1;
            next_ts_arb_addr = {ts_mem_addr, 1'b0};  // 23-bit word addr -> 24-bit half-word addr
            next_ts_arb_wdata = ts_mem_data;
        end

        // Track which request was granted on port 3
        // Priority: texture > DMA > timestamp
        if (tex_req && arb_port3_ready) begin
            next_tex_req_granted = 1'b1;
        end
        if (dma_req && !tex_req && arb_port3_ready) begin
            next_dma_req_granted = 1'b1;
        end
        if (ts_pending && !tex_req && !dma_req && arb_port3_ready) begin
            next_ts_req_granted = 1'b1;
        end

        // Clear grant flags and pending state on ack
        if (arb_port3_ack) begin
            if (tex_req_granted) begin
                next_tex_req_granted = 1'b0;
            end
            if (dma_req_granted) begin
                next_dma_req_granted = 1'b0;
            end
            if (ts_req_granted) begin
                next_ts_req_granted = 1'b0;
                next_ts_pending     = 1'b0;
            end
        end
    end

    always_ff @(posedge clk_core or negedge rst_n_core) begin
        if (!rst_n_core) begin
            ts_pending       <= 1'b0;
            ts_arb_addr      <= 24'd0;
            ts_arb_wdata     <= 32'd0;
            tex_req_granted  <= 1'b0;
            dma_req_granted  <= 1'b0;
            ts_req_granted   <= 1'b0;
        end else begin
            ts_pending       <= next_ts_pending;
            ts_arb_addr      <= next_ts_arb_addr;
            ts_arb_wdata     <= next_ts_arb_wdata;
            tex_req_granted  <= next_tex_req_granted;
            dma_req_granted  <= next_dma_req_granted;
            ts_req_granted   <= next_ts_req_granted;
        end
    end

    // Priority mux: texture reads > DMA writes > timestamp writes.
    // Once a request is granted (sticky `*_req_granted` flag set in the
    // tracking FSM above), the mux holds the bus for that owner until
    // arb_port3_ack — otherwise a newly-arriving higher-priority requester
    // would yank arb_port3_addr / arb_port3_we / arb_port3_burst_len out
    // from under the in-flight burst and corrupt it.
    wire any_p3_grant = tex_req_granted | dma_req_granted | ts_req_granted;
    wire pick_p3_tex  = tex_req_granted | (!any_p3_grant & tex_req);
    wire pick_p3_dma  = dma_req_granted | (!any_p3_grant & !tex_req & dma_req);
    wire pick_p3_ts   = ts_req_granted  | (!any_p3_grant & !tex_req & !dma_req & ts_pending);

    assign arb_port3_req            = pick_p3_tex | pick_p3_dma | pick_p3_ts;
    assign arb_port3_we             = pick_p3_tex ? 1'b0 : 1'b1;
    assign arb_port3_addr           = pick_p3_tex ? tex_addr
                                    : pick_p3_dma ? dma_addr
                                    :               ts_arb_addr;
    assign arb_port3_wdata          = pick_p3_ts ? ts_arb_wdata : 32'b0;
    assign arb_port3_burst_len      = pick_p3_tex ? tex_burst_len
                                    : pick_p3_dma ? dma_burst_len
                                    :               8'b0;
    assign arb_port3_burst_col_step2 = pick_p3_dma & dma_burst_col_step2;
    assign arb_port3_burst_wdata    = dma_req_granted ? dma_burst_wdata : 16'b0;

    // Route burst read data back to texture cache (UNIT-006)
    assign tex_burst_rdata      = arb_port3_burst_rdata;
    assign tex_burst_data_valid = tex_req_granted && arb_port3_burst_data_valid;

    // Route ack and burst_wdata_req back to DMA engine
    assign dma_ack              = dma_req_granted && arb_port3_ack;
    assign dma_burst_wdata_req  = dma_req_granted && arb_port3_burst_wdata_req;
    assign tex_ack              = tex_req_granted && arb_port3_ack;

    // ========================================================================
    // Display Pipeline (Phase 4 - Implemented)
    // ========================================================================

    // Timing generator signals
    wire        disp_hsync;
    wire        disp_vsync;
    wire        disp_enable /* verilator public */;
    wire [9:0]  disp_pixel_x;
    wire [9:0]  disp_pixel_y;
    wire        disp_frame_start;

    // Display controller signals
    wire [7:0]  disp_pixel_red /* verilator public */;
    wire [7:0]  disp_pixel_green /* verilator public */;
    wire [7:0]  disp_pixel_blue /* verilator public */;
    wire        disp_vsync_out /* verilator public */;

    // Timing Generator instantiation
    timing_generator u_timing_gen (
        .clk_pixel(clk_pixel),
        .rst_n(rst_n_pixel),
        .hsync(disp_hsync),
        .vsync(disp_vsync),
        .display_enable(disp_enable),
        .pixel_x(disp_pixel_x),
        .pixel_y(disp_pixel_y),
        .frame_start(disp_frame_start)
    );

    // Display Controller instantiation
    // Operates entirely in clk_core domain; timing inputs from the
    // timing generator (clk_pixel domain) are synchronized internally.
    display_controller u_display_ctrl (
        .clk_sram(clk_core),
        .rst_n_sram(rst_n_core),
        .display_enable(disp_enable),
        .pixel_x(disp_pixel_x),
        .pixel_y(disp_pixel_y),
        .frame_start(disp_frame_start),
        // x512 byte addr → [31:12] (4KB-aligned base address)
        .fb_display_base({7'b0, fb_display_addr[15:3]}),
        // Framebuffer surface dimensions (from FB_DISPLAY register)
        .fb_display_width_log2(fb_display_width_log2),
        .fb_line_double(fb_line_double),
        // Memory interface — single-word (display controller port names preserved)
        .sram_req(arb_port0_req),
        .sram_we(arb_port0_we),
        .sram_addr(arb_port0_addr),
        .sram_wdata(arb_port0_wdata),
        .sram_rdata(arb_port0_rdata),
        .sram_ack(arb_port0_ack),
        .sram_ready(arb_port0_ready),
        // Memory interface — burst (display controller port names preserved)
        .sram_burst_len(arb_port0_burst_len),
        .sram_burst_rdata(arb_port0_burst_rdata),
        .sram_burst_data_valid(arb_port0_burst_data_valid),
        // Pixel output
        .pixel_red(disp_pixel_red),
        .pixel_green(disp_pixel_green),
        .pixel_blue(disp_pixel_blue),
        .vsync_out(disp_vsync_out)
    );

    // DVI Output instantiation (excluded in sim mode; see interactive simulator)
    `ifndef SIM_DIRECT_CMD
    dvi_output u_dvi_out (
        .clk_pixel(clk_pixel),
        .clk_tmds(clk_tmds),
        .rst_n(rst_n_pixel),
        .red(disp_pixel_red),
        .green(disp_pixel_green),
        .blue(disp_pixel_blue),
        .hsync(disp_hsync),
        .vsync(disp_vsync),
        .display_enable(disp_enable),
        .tmds_red_p(tmds_data_p[2]),
        .tmds_red_n(tmds_data_n[2]),
        .tmds_green_p(tmds_data_p[1]),
        .tmds_green_n(tmds_data_n[1]),
        .tmds_blue_p(tmds_data_p[0]),
        .tmds_blue_n(tmds_data_n[0]),
        .tmds_clk_p(tmds_clk_p),
        .tmds_clk_n(tmds_clk_n)
    );
    `else
    // In SIM_DIRECT_CMD mode, UNIT-009 (DVI TMDS Encoder) is not
    // instantiated. The SDL3 display window reads pixel tap signals
    // (disp_pixel_red/green/blue, disp_enable, disp_vsync_out) directly.
    // Tie off TMDS outputs to avoid undriven warnings.
    assign tmds_data_p = 3'b0;
    assign tmds_data_n = 3'b0;
    assign tmds_clk_p  = 1'b0;
    assign tmds_clk_n  = 1'b0;
    `endif

    // GPIO VSYNC output
    assign gpio_vsync = disp_vsync_out;

    // Update vblank status signal
    assign vblank = disp_vsync;

    // ========================================================================
    // Rendering Pipeline (Phase 6 - Rasterizer + Pixel Pipeline + CC)
    // ========================================================================
    //
    // Fragment flow: Rasterizer -> Pixel Pipeline -> Color Combiner ->
    //                Pixel Pipeline (post-CC) -> FB/Z Write
    //
    // Port ownership (DD-025):
    //   Port 1 (framebuffer): owned by pixel pipeline
    //   Port 2 (Z-buffer):    owned by pixel pipeline

    wire rast_ready;

    // Rasterizer fragment output bus (to pixel pipeline)
    wire        rast_frag_valid;
    wire        rast_frag_ready;
    wire [9:0]  rast_frag_x;
    wire [9:0]  rast_frag_y;
    wire [15:0] rast_frag_z;
    wire [63:0] rast_frag_color0;
    wire [63:0] rast_frag_color1;
    wire [31:0] rast_frag_uv0;
    wire [31:0] rast_frag_uv1;
    wire [7:0]  rast_frag_lod;
    wire        rast_frag_tile_start;
    wire        rast_frag_tile_end;
    wire        rast_frag_hiz_uninit;

    rasterizer u_rasterizer (
        .clk(clk_core),
        .rst_n(rst_n_core),

        // Triangle input from register file
        .tri_valid(tri_valid),
        .tri_ready(rast_ready),

        // Vertex 0
        .v0_x(tri_x[0]),
        .v0_y(tri_y[0]),
        .v0_z(tri_z[0]),
        .v0_color0(tri_color0[0]),
        .v0_color1(tri_color1[0]),
        .v0_st0(tri_st0[0]),
        .v0_st1(tri_st1[0]),
        .v0_q(tri_q[0]),

        // Vertex 1
        .v1_x(tri_x[1]),
        .v1_y(tri_y[1]),
        .v1_z(tri_z[1]),
        .v1_color0(tri_color0[1]),
        .v1_color1(tri_color1[1]),
        .v1_st0(tri_st0[1]),
        .v1_st1(tri_st1[1]),
        .v1_q(tri_q[1]),

        // Vertex 2
        .v2_x(tri_x[2]),
        .v2_y(tri_y[2]),
        .v2_z(tri_z[2]),
        .v2_color0(tri_color0[2]),
        .v2_color1(tri_color1[2]),
        .v2_st0(tri_st0[2]),
        .v2_st1(tri_st1[2]),
        .v2_q(tri_q[2]),

        // Fragment output bus (DD-025 valid/ready handshake)
        .frag_valid(rast_frag_valid),
        .frag_ready(rast_frag_ready),
        .frag_x(rast_frag_x),
        .frag_y(rast_frag_y),
        .frag_z(rast_frag_z),
        .frag_color0(rast_frag_color0),
        .frag_color1(rast_frag_color1),
        .frag_uv0(rast_frag_uv0),
        .frag_uv1(rast_frag_uv1),
        .frag_lod(rast_frag_lod),
        .frag_tile_start(rast_frag_tile_start),
        .frag_tile_end(rast_frag_tile_end),
        .frag_hiz_uninit(rast_frag_hiz_uninit),

        // Render mode
        .z_test_en(mode_z_test),

        // Framebuffer surface dimensions (from FB_CONFIG via register file)
        .fb_width_log2(fb_width_log2),
        .fb_height_log2(fb_height_log2),

        // Hi-Z metadata write port (from pixel pipeline, UNIT-006)
        .hiz_wr_en(pp_hiz_wr_en),
        .hiz_wr_tile_index(pp_hiz_wr_tile_index),
        .hiz_wr_new_z(pp_hiz_wr_new_z),

        // Hi-Z authoritative write (from zbuf_tile_cache feedback)
        .hiz_auth_wr_en(zcache_hiz_fb_valid),
        .hiz_auth_wr_tile_index(zcache_hiz_fb_tile_idx),
        .hiz_auth_wr_min_z({zcache_hiz_fb_min_z_hi, 1'b0}),

        // Hi-Z metadata fast-clear (UNIT-005.06)
        .hiz_clear_req(hiz_clear_req),
        .hiz_clear_busy(rast_hiz_clear_busy),

        // Hi-Z diagnostic counter (UNIT-005.06)
        .hiz_rejected_tiles(hiz_rejected_tiles)
    );

    // ========================================================================
    // Pixel Pipeline (UNIT-006) — pre-combiner + post-combiner stages
    // ========================================================================

    // Pixel pipeline -> Color combiner interface
    wire        pp_cc_valid;
    wire [63:0] pp_cc_tex_color0;
    wire [63:0] pp_cc_tex_color1;
    wire [63:0] pp_cc_shade0;
    wire [63:0] pp_cc_shade1;
    wire [9:0]  pp_cc_frag_x;
    wire [9:0]  pp_cc_frag_y;
    wire [15:0] pp_cc_frag_z;

    // Pixel pipeline -> Color combiner: promoted destination color for pass 2
    wire [63:0] pp_cc_dst_color;

    // Color combiner -> Pixel pipeline interface
    wire        cc_out_valid;
    wire        cc_in_ready;
    wire [63:0] cc_out_color;
    wire [15:0] cc_out_frag_x;
    wire [15:0] cc_out_frag_y;
    wire [15:0] cc_out_frag_z;

    // Pipeline status
    wire        pp_pipeline_empty;

    // Hi-Z metadata update from pixel pipeline (UNIT-005.06)
    wire        pp_hiz_wr_en;
    wire [13:0] pp_hiz_wr_tile_index;
    wire [8:0]  pp_hiz_wr_new_z;

    // Hi-Z diagnostic counter (UNIT-005.06)
    wire [31:0] hiz_rejected_tiles /* verilator public */;

    // Hi-Z metadata fast-clear (UNIT-005.06)
    // Triggered by any FB_CONFIG write — invalidates all Hi-Z metadata so the
    // Z-buffer tile cache can lazy-fill tiles with 0x0000 on first access.
    wire        hiz_clear_req;
    wire        rast_hiz_clear_busy;
    assign hiz_clear_req = fb_config_trigger;

    // Pixel pipeline → color tile cache (UNIT-013) interface wires
    wire        pp_color_wr_req;
    wire [13:0] pp_color_wr_tile_idx;
    wire [3:0]  pp_color_wr_pixel_off;
    wire [15:0] pp_color_wr_data;
    wire        pp_color_rd_req;
    wire [13:0] pp_color_rd_tile_idx;
    wire [3:0]  pp_color_rd_pixel_off;

    // Color tile cache → pixel pipeline / SDRAM (UNIT-013)
    wire [15:0] ctcache_rd_data;
    wire        ctcache_rd_valid;
    wire        ctcache_wr_ready;
    wire        ctcache_ready;
    wire        ctcache_sdram_rd_req;
    wire [23:0] ctcache_sdram_rd_addr;
    wire        ctcache_sdram_wr_req;
    wire [23:0] ctcache_sdram_wr_addr;
    wire [15:0] ctcache_sdram_wr_data;

    // Register file → color tile cache (UNIT-013) flush / invalidate handshake
    wire        rf_fb_cache_flush_trigger;
    wire        rf_fb_cache_invalidate_trigger;
    wire        ctcache_flush_done;
    wire        ctcache_invalidate_done;

    wire        pp_zb_read_req;
    wire [13:0] pp_zb_read_tile_idx;
    wire [3:0]  pp_zb_read_pixel_off;
    wire        pp_zb_write_req;
    wire [13:0] pp_zb_write_tile_idx;
    wire [3:0]  pp_zb_write_pixel_off;
    wire [15:0] pp_zb_write_data;

    // Construct RENDER_MODE register from individual mode flags
    wire [31:0] render_mode_packed = {
        16'b0,                          // [31:16] reserved
        mode_z_compare,                 // [15:13]
        mode_dither_pattern,            // [12:11]
        mode_alpha_test,                // [10:9]
        mode_alpha_ref[0],              // [8] (low bit placeholder)
        mode_color_write,               // [7]
        mode_z_write,                   // [6]
        mode_dither_en,                 // [5]
        3'b0,                           // [4:2] reserved (was alpha_blend)
        mode_z_test,                    // [1]
        mode_stipple_en                 // [0]
    };

    // Construct FB_CONFIG register from fields
    wire [31:0] fb_config_packed = {
        12'b0,                          // [31:20] reserved
        fb_width_log2,                  // [19:16]
        fb_color_base                   // [15:0]
    };

    // Construct FB_CONTROL register (Z base in low 16 bits)
    wire [31:0] fb_control_packed = {
        16'b0,                          // [31:16] reserved
        fb_z_base                       // [15:0]
    };

    // Pack Z_RANGE from individual fields
    wire [31:0] z_range_packed = {z_range_max, z_range_min};

    // Pixel pipeline texture SRAM interface wires (to arbiter port 3).
    // The pixel_pipeline forwards the texture_sampler's port-3 master.
    wire        pp_tex_sram_req;
    wire        pp_tex_sram_we;
    wire [23:0] pp_tex_sram_addr;
    wire [31:0] pp_tex_sram_wdata;
    wire [7:0]  pp_tex_sram_burst_len;
    wire [15:0] pp_tex_sram_burst_wdata;

    // Unused rasterizer fragment output signals
    /* verilator lint_off UNUSEDSIGNAL */
    // frag_lod now connected to pixel_pipeline
    wire        _unused_frag_tile_start = rast_frag_tile_start;
    wire        _unused_frag_tile_end   = rast_frag_tile_end;
    wire        _unused_frag_hiz_uninit = rast_frag_hiz_uninit;
    wire [3:0]  _unused_fb_h_log2   = fb_height_log2;
    wire [1:0]  _unused_mode_cull   = mode_cull;
    wire [7:0]  _unused_alpha_ref   = mode_alpha_ref;
    wire [1:0]  _unused_alpha_test  = mode_alpha_test;
    wire [1:0]  _unused_dither_pat  = mode_dither_pattern;
    wire        _unused_mode_gouraud = mode_gouraud;
    wire        _unused_rect_valid  = rect_valid;
    wire        _unused_mem_rd      = mem_data_rd;
    wire [63:0] _unused_mem_addr    = mem_addr_out; // DMA uses mem_data_dword_addr instead
    // Both TEXn_CFG values are now consumed by the pixel_pipeline (which
    // forwards them to texture_sampler).  Keep these tap wires for future
    // diagnostic visibility.
    wire [9:0]  _unused_scissor_x   = scissor_x;
    wire [9:0]  _unused_scissor_y   = scissor_y;
    wire [9:0]  _unused_scissor_w   = scissor_width;
    wire [9:0]  _unused_scissor_h   = scissor_height;
    wire        _unused_dma_we      = dma_we; // Always 1, not needed in mux
    wire [15:0] _unused_fb_lut_addr = fb_lut_addr;
    wire        _unused_color_grade = color_grade_enable;
    // Arbiter port 3 single-word read data unused (texture uses burst reads)
    wire [31:0] _unused_p3_rdata       = arb_port3_rdata;
    // The texture_sampler exposes a full master interface (read-only today
    // for INDEXED8_2X2); the write-side outputs are tied off here because
    // the port-3 sharing FSM uses its own write-path operands for DMA and
    // PERF_TIMESTAMP traffic.
    wire        _unused_pp_tex_we      = pp_tex_sram_we;
    wire [31:0] _unused_pp_tex_wdata   = pp_tex_sram_wdata;
    wire [15:0] _unused_pp_tex_burst_wdata = pp_tex_sram_burst_wdata;
    /* verilator lint_on UNUSEDSIGNAL */

    pixel_pipeline u_pixel_pipeline (
        .clk(clk_core),
        .rst_n(rst_n_core),

        // Fragment input from rasterizer (DD-025)
        .frag_valid(rast_frag_valid),
        .frag_ready(rast_frag_ready),
        .frag_x(rast_frag_x),
        .frag_y(rast_frag_y),
        .frag_z(rast_frag_z),
        .frag_u0(rast_frag_uv0[15:0]),
        .frag_v0(rast_frag_uv0[31:16]),
        .frag_u1(rast_frag_uv1[15:0]),
        .frag_v1(rast_frag_uv1[31:16]),
        .frag_shade0(rast_frag_color0),
        .frag_shade1(rast_frag_color1),
        .frag_lod(rast_frag_lod),

        // Register configuration
        .reg_render_mode(render_mode_packed),
        .reg_z_range(z_range_packed),
        .reg_stipple(stipple_pattern),
        .reg_tex0_cfg(tex0_cfg),
        .reg_tex1_cfg(tex1_cfg),
        .reg_fb_config(fb_config_packed),
        .reg_fb_control(fb_control_packed),
        .reg_cc_mode_2(cc_mode_2),

        // Palette load triggers (UNIT-011.06; routed through to texture_sampler)
        .palette0_load_trigger(palette0_load_trigger),
        .palette0_base_addr   (palette0_base_addr),
        .palette1_load_trigger(palette1_load_trigger),
        .palette1_base_addr   (palette1_base_addr),

        // Output to color combiner
        .cc_valid(pp_cc_valid),
        .cc_tex_color0(pp_cc_tex_color0),
        .cc_tex_color1(pp_cc_tex_color1),
        .cc_shade0(pp_cc_shade0),
        .cc_shade1(pp_cc_shade1),
        .cc_frag_x(pp_cc_frag_x),
        .cc_frag_y(pp_cc_frag_y),
        .cc_frag_z(pp_cc_frag_z),
        .cc_dst_color(pp_cc_dst_color),

        // Input from color combiner
        .cc_in_valid(cc_out_valid),
        .cc_in_ready(cc_in_ready),
        .cc_in_color(cc_out_color),
        .cc_in_frag_x(cc_out_frag_x),
        .cc_in_frag_y(cc_out_frag_y),
        .cc_in_frag_z(cc_out_frag_z),

        // Z-buffer cache interface
        .zbuf_read_req(pp_zb_read_req),
        .zbuf_read_tile_idx(pp_zb_read_tile_idx),
        .zbuf_read_pixel_off(pp_zb_read_pixel_off),
        .zbuf_read_data(zcache_rd_data),
        .zbuf_read_valid(zcache_rd_valid),
        .zbuf_ready(zcache_ready),
        .zbuf_write_req(pp_zb_write_req),
        .zbuf_write_tile_idx(pp_zb_write_tile_idx),
        .zbuf_write_pixel_off(pp_zb_write_pixel_off),
        .zbuf_write_data(pp_zb_write_data),

        // Color tile cache interface (UNIT-013, owns arbiter port 1)
        .color_wr_req(pp_color_wr_req),
        .color_wr_tile_idx(pp_color_wr_tile_idx),
        .color_wr_pixel_off(pp_color_wr_pixel_off),
        .color_wr_data(pp_color_wr_data),
        .color_rd_req(pp_color_rd_req),
        .color_rd_tile_idx(pp_color_rd_tile_idx),
        .color_rd_pixel_off(pp_color_rd_pixel_off),
        .color_rd_data(ctcache_rd_data),
        .color_rd_valid(ctcache_rd_valid),
        .color_wr_ready(ctcache_wr_ready),
        .color_cache_ready(ctcache_ready),

        // Texture sampler SDRAM port-3 master forwarding
        .tex0_cache_inv(tex0_cache_inv),
        .tex1_cache_inv(tex1_cache_inv),
        .tex_sram_req(pp_tex_sram_req),
        .tex_sram_we(pp_tex_sram_we),
        .tex_sram_addr(pp_tex_sram_addr),
        .tex_sram_wdata(pp_tex_sram_wdata),
        .tex_sram_burst_len(pp_tex_sram_burst_len),
        .tex_sram_burst_wdata(pp_tex_sram_burst_wdata),
        .tex_sram_burst_rdata(tex_burst_rdata),
        .tex_sram_burst_data_valid(tex_burst_data_valid),
        .tex_sram_ack(tex_ack),
        .tex_sram_ready(arb_port3_ready),

        // Hi-Z metadata update (to rasterizer's raster_hiz_meta, UNIT-005.06)
        .hiz_wr_en(pp_hiz_wr_en),
        .hiz_wr_tile_index(pp_hiz_wr_tile_index),
        .hiz_wr_new_z(pp_hiz_wr_new_z),

        // Pipeline status
        .pipeline_empty(pp_pipeline_empty)
    );

    // ========================================================================
    // Color Tile Cache (UNIT-013)
    // ========================================================================
    // Sits between pixel_pipeline and arbiter port 1.  Caches 4×4 RGB565
    // tiles with lazy-fill (zero) on first write to an uninitialized tile.
    // Owns all port-1 SDRAM traffic (fill reads, eviction writes, flush).

    color_tile_cache u_color_tile_cache (
        .clk(clk_core),
        .rst_n(rst_n_core),

        // Pixel pipeline read port
        .rd_req(pp_color_rd_req),
        .rd_tile_idx(pp_color_rd_tile_idx),
        .rd_pixel_off(pp_color_rd_pixel_off),
        .rd_data(ctcache_rd_data),
        .rd_valid(ctcache_rd_valid),

        // Pixel pipeline write port
        .wr_req(pp_color_wr_req),
        .wr_tile_idx(pp_color_wr_tile_idx),
        .wr_pixel_off(pp_color_wr_pixel_off),
        .wr_data(pp_color_wr_data),
        .wr_ready(ctcache_wr_ready),

        // Cache control (FB_CACHE_CTRL handshake from register_file)
        .cache_ready(ctcache_ready),
        .flush(rf_fb_cache_flush_trigger),
        .flush_done(ctcache_flush_done),
        .invalidate(rf_fb_cache_invalidate_trigger),
        .invalidate_done(ctcache_invalidate_done),

        // SDRAM (arbiter port 1)
        .sdram_rd_req(ctcache_sdram_rd_req),
        .sdram_rd_addr(ctcache_sdram_rd_addr),
        .sdram_rd_data(arb_port1_burst_rdata),
        .sdram_rd_valid(arb_port1_burst_data_valid),
        .sdram_wr_req(ctcache_sdram_wr_req),
        .sdram_wr_addr(ctcache_sdram_wr_addr),
        .sdram_wr_data(ctcache_sdram_wr_data),
        .sdram_ready(arb_port1_ready),
        .sdram_burst_wdata_req(arb_port1_burst_wdata_req),

        // Configuration
        .fb_color_base(fb_color_base),
        .fb_width_log2(fb_width_log2)
    );

    // ========================================================================
    // Arbiter Port 1: Color Tile Cache (UNIT-013)
    // ========================================================================
    // All port-1 transfers are 16-word bursts (full 4×4 tile per request).

    assign arb_port1_req         = ctcache_sdram_rd_req | ctcache_sdram_wr_req;
    assign arb_port1_we          = ctcache_sdram_wr_req;
    assign arb_port1_addr        = ctcache_sdram_wr_req ? ctcache_sdram_wr_addr
                                                        : ctcache_sdram_rd_addr;
    assign arb_port1_wdata       = {16'b0, ctcache_sdram_wr_data};
    assign arb_port1_burst_len   = 8'd16;
    assign arb_port1_burst_wdata = ctcache_sdram_wr_data;

    // ========================================================================
    // Z-Buffer Tile Cache (UNIT-006)
    // ========================================================================
    // Sits between pixel_pipeline and arbiter port 2.  Caches 4×4 Z tiles
    // with lazy-fill from Hi-Z metadata (UNIT-005.06).

    wire [15:0] zcache_rd_data;
    wire        zcache_rd_valid;
    wire        zcache_ready;
    wire        zcache_sdram_rd_req;
    wire [23:0] zcache_sdram_rd_addr;
    wire        zcache_sdram_wr_req;
    wire [23:0] zcache_sdram_wr_addr;
    wire [15:0] zcache_sdram_wr_data;

    // Hi-Z feedback from Z-cache (eviction + consecutive-write min-Z)
    wire        zcache_hiz_fb_valid;
    wire [13:0] zcache_hiz_fb_tile_idx;
    wire [7:0]  zcache_hiz_fb_min_z_hi;

    // Flush control (sim-only: write-back all dirty lines before extraction)
`ifdef SIM_DIRECT_REG
    wire        zcache_flush      = sim_zcache_flush;
`else
    wire        zcache_flush      = 1'b0;
`endif
    wire        zcache_flush_done /* verilator public */;

    zbuf_tile_cache u_zbuf_tile_cache (
        .clk(clk_core),
        .rst_n(rst_n_core),

        // Pixel pipeline read interface
        .rd_req(pp_zb_read_req),
        .rd_tile_idx(pp_zb_read_tile_idx),
        .rd_pixel_off(pp_zb_read_pixel_off),
        .rd_data(zcache_rd_data),
        .rd_valid(zcache_rd_valid),

        // Pixel pipeline write interface
        .wr_req(pp_zb_write_req),
        .wr_tile_idx(pp_zb_write_tile_idx),
        .wr_pixel_off(pp_zb_write_pixel_off),
        .wr_data(pp_zb_write_data),
        .wr_ready(),

        // Cache status
        .cache_ready(zcache_ready),
        .flush(zcache_flush),
        .flush_done(zcache_flush_done),

        // SDRAM arbiter interface (port 2)
        .sdram_rd_req(zcache_sdram_rd_req),
        .sdram_rd_addr(zcache_sdram_rd_addr),
        .sdram_rd_data(arb_port2_burst_rdata),
        .sdram_rd_valid(arb_port2_burst_data_valid),
        .sdram_wr_req(zcache_sdram_wr_req),
        .sdram_wr_addr(zcache_sdram_wr_addr),
        .sdram_wr_data(zcache_sdram_wr_data),
        .sdram_ready(arb_port2_ready),
        .sdram_burst_wdata_req(arb_port2_burst_wdata_req),

        // Configuration
        .fb_z_base(fb_z_base),
        .fb_width_log2(fb_width_log2),

        // Invalidation + uninit flag sweep (on FB_CONFIG write)
        .invalidate(fb_config_trigger),
        .uninit_clear_req(hiz_clear_req),

        // Hi-Z min-Z feedback (to raster_hiz_meta via rasterizer)
        .hiz_fb_valid(zcache_hiz_fb_valid),
        .hiz_fb_tile_idx(zcache_hiz_fb_tile_idx),
        .hiz_fb_min_z_hi(zcache_hiz_fb_min_z_hi)
    );

    // ========================================================================
    // Arbiter Port 2: Z-Buffer (owned by zbuf_tile_cache)
    // ========================================================================

    assign arb_port2_req   = zcache_sdram_rd_req | zcache_sdram_wr_req;
    assign arb_port2_we    = zcache_sdram_wr_req;
    assign arb_port2_addr  = zcache_sdram_wr_req ? zcache_sdram_wr_addr : zcache_sdram_rd_addr;
    assign arb_port2_wdata = {16'b0, zcache_sdram_wr_data};

    // ========================================================================
    // Color Combiner (UNIT-010)
    // ========================================================================
    // Sits between pixel pipeline pre-combiner output and post-combiner input.

    color_combiner u_color_combiner (
        .clk(clk_core),
        .rst_n(rst_n_core),

        // Fragment inputs from pixel pipeline
        .tex_color0(pp_cc_tex_color0),
        .tex_color1(pp_cc_tex_color1),
        .shade0(pp_cc_shade0),
        .shade1(pp_cc_shade1),
        .frag_x({6'b0, pp_cc_frag_x}),
        .frag_y({6'b0, pp_cc_frag_y}),
        .frag_z(pp_cc_frag_z),
        .frag_valid(pp_cc_valid),

        // Configuration from register file
        .cc_mode(cc_mode),
        .cc_mode_2(cc_mode_2),
        .dst_color(pp_cc_dst_color),
        .const_color(const_color),

        // Output to pixel pipeline post-combiner stages
        .combined_color(cc_out_color),
        .out_frag_x(cc_out_frag_x),
        .out_frag_y(cc_out_frag_y),
        .out_frag_z(cc_out_frag_z),
        .out_frag_valid(cc_out_valid),

        // Backpressure
        .in_ready(),                    // CC accepts when downstream ready
        .out_ready(cc_in_ready)
    );

    // ========================================================================
    // Pipeline Done / Fragment Done (frag_done)
    // ========================================================================
    // Observable by the harness: asserts when rasterizer is idle AND pixel
    // pipeline has no fragments in flight.

    wire frag_done /* verilator public */ = !gpu_busy && pp_pipeline_empty;
    /* verilator lint_off UNUSEDSIGNAL */
    wire _unused_frag_done = frag_done;
    /* verilator lint_on UNUSEDSIGNAL */

endmodule

`default_nettype wire
