londey/pico-gs/rtl/components/texture/src/texture_sampler.sv

`default_nettype none

// Spec-ref: unit_011_texture_sampler.md
//
// Texture Sampler — INDEXED8_2X2 Two-Sampler Assembly (UNIT-011)
//
// Self-contained dual-sampler unit owning the entire INDEXED8_2X2
// texture path:
//   * Two `texture_uv_coord` instances (UNIT-011.01)
//   * Two `texture_index_cache` instances (UNIT-011.03)
//   * One shared `texture_palette_lut` instance (UNIT-011.06)
//   * 3-way SDRAM port-3 arbiter (index-fill x 2 + palette load FSM)
//   * Per-sampler 4x4 index-block fill FSM
//   * UQ1.8 -> Q4.12 promotion via fp_types_pkg::promote_uq18_to_q412
//
// Per-fragment data flow (per sampler):
//   Q4.12 UV  ->  texture_uv_coord  ->  (u_idx, v_idx, quadrant)
//                                   ->  texture_index_cache.lookup
//                                        hit  -> idx[7:0]
//                                        miss -> fill FSM (8-word burst)
//                                   ->  texture_palette_lut.lookup
//                                        (slot, idx, quadrant) -> 36-b UQ1.8
//                                   ->  promote_uq18_to_q412 -> 64-b Q4.12 RGBA
//
// Port-3 arbiter priority (per UNIT-011 / DD-026):
//   1. index cache fills (sampler 0 fill > sampler 1 fill within fills)
//   2. palette load FSM sub-bursts (preempted by in-flight index fills)
//
// External pipeline contract:
//   `frag_valid` strobes a sampling request; `frag_ready` deasserts when
//   the sampler is busy resolving a miss or waiting for a palette slot.
//   `texel_valid` rises in the cycle the Q4.12 RGBA outputs are stable
//   for the granted request.  When a sampler's `tex*_cfg.ENABLE = 0`
//   the corresponding output is forced to opaque white in Q4.12
//   (TEX_COLOR0/1 = 0x1000_1000_1000_1000) and the unit is skipped.
//
// See: UNIT-011 (Texture Sampler), UNIT-011.01/03/06,
//      tex_sample.rs (digital twin reference).

module texture_sampler
(
    input  wire         clk,
    input  wire         rst_n,

    // ====================================================================
    // Fragment request (one fragment at a time)
    // ====================================================================
    input  wire         frag_valid,        // Sampling request strobe
    output wire         frag_ready,        // Sampler accepts new request

    input  wire [15:0]  frag_u0,           // TEX0 U, Q4.12
    input  wire [15:0]  frag_v0,           // TEX0 V, Q4.12
    input  wire [15:0]  frag_u1,           // TEX1 U, Q4.12
    input  wire [15:0]  frag_v1,           // TEX1 V, Q4.12

    // ====================================================================
    // Texture configuration (subset of TEX0_CFG / TEX1_CFG)
    //   [0]      ENABLE
    //   [3:2]    FILTER (NEAREST-only; ignored)
    //   [7:4]    FORMAT (INDEXED8_2X2 only; ignored)
    //   [11:8]   WIDTH_LOG2
    //   [15:12]  HEIGHT_LOG2
    //   [17:16]  U_WRAP
    //   [19:18]  V_WRAP
    //   [24]     PALETTE_IDX
    //   [47:32]  BASE_ADDR (in 512-byte units)
    // ====================================================================
    input  wire [63:0]  tex0_cfg,
    input  wire [63:0]  tex1_cfg,

    // Per-sampler index-cache invalidation (one-cycle pulse on TEXn_CFG write)
    input  wire         tex0_cache_inv,
    input  wire         tex1_cache_inv,

    // ====================================================================
    // Palette load triggers (from register_file via gpu_top wiring)
    // ====================================================================
    input  wire         palette0_load_trigger,
    input  wire [15:0]  palette0_base_addr,
    input  wire         palette1_load_trigger,
    input  wire [15:0]  palette1_base_addr,

    // ====================================================================
    // Sampled texel outputs (Q4.12 RGBA per channel)
    //   tex_color0 = {R, G, B, A}, each 16-bit Q4.12
    // ====================================================================
    output wire         texel_valid,
    output wire [63:0]  tex_color0,
    output wire [63:0]  tex_color1,

    // ====================================================================
    // SDRAM Arbiter — Port 3 master
    // ====================================================================
    output wire         sram_req,
    output wire         sram_we,
    output wire [23:0]  sram_addr,
    output wire [31:0]  sram_wdata,
    output wire [7:0]   sram_burst_len,
    output wire [15:0]  sram_burst_wdata,
    input  wire [15:0]  sram_burst_rdata,
    input  wire         sram_burst_data_valid,
    input  wire         sram_ack,
    input  wire         sram_ready
);

    // ========================================================================
    // TEXn_CFG field decode
    // ========================================================================

    wire        tex0_enable      = tex0_cfg[0];
    wire [3:0]  tex0_width_log2  = tex0_cfg[11:8];
    wire [3:0]  tex0_height_log2 = tex0_cfg[15:12];
    wire [1:0]  tex0_u_wrap      = tex0_cfg[17:16];
    wire [1:0]  tex0_v_wrap      = tex0_cfg[19:18];
    wire        tex0_palette_idx = tex0_cfg[24];
    wire [15:0] tex0_base_addr   = tex0_cfg[47:32];

    wire        tex1_enable      = tex1_cfg[0];
    wire [3:0]  tex1_width_log2  = tex1_cfg[11:8];
    wire [3:0]  tex1_height_log2 = tex1_cfg[15:12];
    wire [1:0]  tex1_u_wrap      = tex1_cfg[17:16];
    wire [1:0]  tex1_v_wrap      = tex1_cfg[19:18];
    wire        tex1_palette_idx = tex1_cfg[24];
    wire [15:0] tex1_base_addr   = tex1_cfg[47:32];

    // Acknowledge unused TEXn_CFG bits explicitly to keep Verilator silent.
    /* verilator lint_off UNUSEDSIGNAL */
    wire [15:0] _unused_tex0_hi    = tex0_cfg[63:48];
    wire [6:0]  _unused_tex0_rsvd  = tex0_cfg[31:25];
    wire [3:0]  _unused_tex0_mip   = tex0_cfg[23:20];
    wire [3:0]  _unused_tex0_filt  = tex0_cfg[7:4];
    wire [2:0]  _unused_tex0_lo    = tex0_cfg[3:1];
    wire [15:0] _unused_tex1_hi    = tex1_cfg[63:48];
    wire [6:0]  _unused_tex1_rsvd  = tex1_cfg[31:25];
    wire [3:0]  _unused_tex1_mip   = tex1_cfg[23:20];
    wire [3:0]  _unused_tex1_filt  = tex1_cfg[7:4];
    wire [2:0]  _unused_tex1_lo    = tex1_cfg[3:1];
    /* verilator lint_on UNUSEDSIGNAL */

    // ========================================================================
    // UNIT-011.01 — UV coordinate processing (per sampler)
    // ========================================================================

    wire [9:0] s0_u_idx, s0_v_idx;
    wire [1:0] s0_quadrant;
    wire [9:0] s1_u_idx, s1_v_idx;
    wire [1:0] s1_quadrant;

    texture_uv_coord u_uv0 (
        .uv_q412_u      (frag_u0),
        .uv_q412_v      (frag_v0),
        .tex_width_log2 (tex0_width_log2),
        .tex_height_log2(tex0_height_log2),
        .tex_u_wrap     (tex0_u_wrap),
        .tex_v_wrap     (tex0_v_wrap),
        .u_idx          (s0_u_idx),
        .v_idx          (s0_v_idx),
        .quadrant       (s0_quadrant)
    );

    texture_uv_coord u_uv1 (
        .uv_q412_u      (frag_u1),
        .uv_q412_v      (frag_v1),
        .tex_width_log2 (tex1_width_log2),
        .tex_height_log2(tex1_height_log2),
        .tex_u_wrap     (tex1_u_wrap),
        .tex_v_wrap     (tex1_v_wrap),
        .u_idx          (s1_u_idx),
        .v_idx          (s1_v_idx),
        .quadrant       (s1_quadrant)
    );

    // ========================================================================
    // Latched lookup state.  Captured on `frag_valid && frag_ready` so the
    // index-fill FSM and palette LUT see stable inputs across stalls.
    // ========================================================================

    reg [9:0]   s0_u_idx_r, s0_v_idx_r;
    reg [1:0]   s0_quad_r;
    reg [9:0]   s1_u_idx_r, s1_v_idx_r;
    reg [1:0]   s1_quad_r;
    reg         s0_enable_r;
    reg         s1_enable_r;
    reg         s0_palette_idx_r;
    reg         s1_palette_idx_r;
    reg [15:0]  s0_base_r;
    reg [15:0]  s1_base_r;
    reg [3:0]   s0_w_log2_r;
    reg [3:0]   s1_w_log2_r;

    // ========================================================================
    // UNIT-011.03 — half-resolution index caches (per sampler)
    // ========================================================================

    wire        s0_lookup_valid;
    wire        s0_hit;
    wire [7:0]  s0_idx_byte;
    wire        s0_fill_first;
    wire        s0_fill_word_valid;
    wire [15:0] s0_fill_word_data;
    wire        s0_fill_word_last;
    wire        s0_fill_busy;

    wire        s1_lookup_valid;
    wire        s1_hit;
    wire [7:0]  s1_idx_byte;
    wire        s1_fill_first;
    wire        s1_fill_word_valid;
    wire [15:0] s1_fill_word_data;
    wire        s1_fill_word_last;
    wire        s1_fill_busy;

    // The cache exposes `fill_busy_o` as the contract signal the parent
    // must use to gate lookups (UNIT-011.03 §Sampler-side serialization).
    // In this assembly the sampler's request FSM already prevents lookup
    // issue during a fill (R_FILL ≠ R_LOOKUP), so the signal is observed
    // for spec-binding assertions but not consumed by FSM logic.
    /* verilator lint_off UNUSEDSIGNAL */
    wire _unused_fill_busy = s0_fill_busy | s1_fill_busy;
    /* verilator lint_on UNUSEDSIGNAL */

    texture_index_cache #(.SAMPLER_ID(1'b0)) u_idx_cache0 (
        .clk                (clk),
        .rst_n              (rst_n),
        .tex_base_lo_i      (s0_base_r),
        .valid_i            (s0_lookup_valid),
        .u_idx_i            (s0_u_idx_r),
        .v_idx_i            (s0_v_idx_r),
        .hit_o              (s0_hit),
        .idx_byte_o         (s0_idx_byte),
        .fill_first_i       (s0_fill_first),
        .fill_word_valid_i  (s0_fill_word_valid),
        .fill_word_data_i   (s0_fill_word_data),
        .fill_word_last_i   (s0_fill_word_last),
        .fill_busy_o        (s0_fill_busy),
        .invalidate_i       (tex0_cache_inv)
    );

    texture_index_cache #(.SAMPLER_ID(1'b1)) u_idx_cache1 (
        .clk                (clk),
        .rst_n              (rst_n),
        .tex_base_lo_i      (s1_base_r),
        .valid_i            (s1_lookup_valid),
        .u_idx_i            (s1_u_idx_r),
        .v_idx_i            (s1_v_idx_r),
        .hit_o              (s1_hit),
        .idx_byte_o         (s1_idx_byte),
        .fill_first_i       (s1_fill_first),
        .fill_word_valid_i  (s1_fill_word_valid),
        .fill_word_data_i   (s1_fill_word_data),
        .fill_word_last_i   (s1_fill_word_last),
        .fill_busy_o        (s1_fill_busy),
        .invalidate_i       (tex1_cache_inv)
    );

    // ========================================================================
    // SDRAM byte address of the index-block for a given (u_idx, v_idx).
    //
    // Layout (INT-014):
    //   block_index       = block_y * blocks_per_row + block_x
    //   block_byte_offset = block_index * 16
    //   byte_addr         = base_addr_512 * 512 + block_byte_offset
    //   word_addr         = byte_addr >> 1
    //
    // blocks_per_row encoding:
    //   width_log2 < 3  -> 1   (single padded 4x4 block per INT-014 minimum)
    //   width_log2 >= 3 -> 1 << (width_log2 - 3)   (= index_width / 4)
    // ========================================================================

    wire [9:0] s0_block_x = s0_u_idx_r >> 2;
    wire [9:0] s0_block_y = s0_v_idx_r >> 2;
    wire [9:0] s1_block_x = s1_u_idx_r >> 2;
    wire [9:0] s1_block_y = s1_v_idx_r >> 2;

    wire [7:0] s0_blocks_per_row = (s0_w_log2_r < 4'd3)
                                   ? 8'd1
                                   : 8'(8'd1 << (s0_w_log2_r - 4'd3));
    wire [7:0] s1_blocks_per_row = (s1_w_log2_r < 4'd3)
                                   ? 8'd1
                                   : 8'(8'd1 << (s1_w_log2_r - 4'd3));

    wire [23:0] s0_block_index       = ({14'b0, s0_block_y} * {16'b0, s0_blocks_per_row})
                                     + {14'b0, s0_block_x};
    wire [23:0] s1_block_index       = ({14'b0, s1_block_y} * {16'b0, s1_blocks_per_row})
                                     + {14'b0, s1_block_x};

    wire [23:0] s0_block_byte_offset = s0_block_index << 4;
    wire [23:0] s1_block_byte_offset = s1_block_index << 4;
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
