londey/pico-gs/(commit log)

2026-01-29 001 spi register rework (#2)
    * feat: Add implementation tasks and templates for SPI GPU project
    - Created tasks.md for ICEpi SPI GPU implementation with detailed phases and tasks.
    - Added agent-file-template.md for generating development guidelines.
    - Introduced checklist-template.md for feature-specific checklists.
    - Developed plan-template.md for structured implementation plans.
    - Created spec-template.md for feature specifications with user scenarios and requirements.
    - Added tasks-template.md for organizing tasks by user stories and phases.
    * feat: Add specification and quality checklist for SPI GPU Register Map Rework
2026-01-29 feat(gpu): Revise ICEpi SPI GPU specification to v2.0 with multi-texture support
    - Updated status to Active Development and added version history.
    - Introduced new features including 4 independent texture units, texture blend modes, compressed texture formats, and configurable z-buffer compare functions.
    - Added user stories and functional requirements for new features in v2.0.
    - Documented breaking changes and migration guide for register address updates.
    - Enhanced performance targets and clarified out-of-scope items for future revisions.
2026-01-31 feat: Add initial implementation plan, quickstart guide, research documentation, and feature specification for RP2350 host software
    - Created plan.md detailing the implementation strategy, project structure, and performance goals.
    - Added quickstart.md for hardware and software setup instructions, build and flash procedures, and verification steps.
    - Introduced research.md outlining key decisions regarding language, toolchain, dual-core communication, USB input, SPI configuration, and more.
    - Developed spec.md defining user scenarios, functional requirements, success criteria, and assumptions for the host software.
2026-01-31 Add initial implementation of ICEpi GPU v2.0
    - Introduced pin constraints for ICEpi Zero in `icepi_zero.lpf`.
    - Implemented PLL core for clock generation in `pll_core.sv`, providing 100 MHz, 25.175 MHz, and 251.75 MHz outputs.
    - Added reset synchronization module in `reset_sync.sv` to manage multi-clock domain resets.
    - Created top-level GPU module in `gpu_top.sv`, integrating clock generation, reset synchronization, SPI interface, and placeholders for memory and display subsystems.
    - Developed register file for GPU state management in `register_file.sv`, handling vertex submission and configuration registers.
    - Implemented SPI slave interface in `spi_slave.sv` for transaction handling.
    - Ad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
    [async_fifo.sv, gpu_top.sv, pll_core.sv, register_file.sv, reset_sync.sv, spi_slave.sv]
2026-01-31 Add GPU register file, SPI slave, async FIFO, and divider modules; implement testbenches for timing generator and rasterizer
    - Created `register_file.sv` to manage GPU state and vertex submission, including a vertex state machine for triangle rasterization.
    - Implemented `spi_slave.sv` for handling 72-bit SPI transactions with read/write capabilities.
    - Developed `async_fifo.sv` for asynchronous command buffering across clock domains.
    - Added `divider.sv` for fixed-point division, optimized for barycentric interpolation.
    - Introduced testbench `tb_timing_generator.sv` to verify VGA timing generation at 640x480@60Hz.
    - Created testbench `tb_rasterizer.sv` for testing triangle rasterization fu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
    [teapot.obj]
2026-02-02 Refactor asset data preparation tasks: reorganize phases, enhance descriptions, and add new tasks for build integration and error handling
    - Updated Phase 1 to include project infrastructure setup and build integration with host_app/build.rs
    - Enhanced Phase 2 with foundational types and utilities required for all user stories
    - Revised User Story 1 and User Story 2 tasks for texture and mesh processing, ensuring independent functionality
    - Introduced User Story 3 for firmware-compatible output generation, integrating with build.rs
    - Added error handling and edge case management in later phases
    - Improved documentation and task organization for clarity and parallel execution opportunities
2026-02-03 chore: update asset paths in build script and README, add placeholder assets
    [teapot.obj]
2026-02-03 feat: add architecture and design principles documentation for pico-gs project
2026-02-04 Refactor asset data preparation tasks and documentation
    - Renamed tasks document to reflect library structure.
    - Updated prerequisites to clarify required documents.
    - Enhanced organization of tasks by user story for better implementation tracking.
    - Revised phase descriptions and dependencies for clarity.
    - Added detailed test and implementation tasks for texture and mesh conversion.
    - Improved output generation and build integration steps in build.rs.
    - Ensured comprehensive test coverage and actionable error messages.
    - Streamlined parallel task execution opportunities for team collaboration.
    [build.rs, main.rs]
2026-02-04 Implement SPI GPU tasks and rework register specifications
    - Added a comprehensive task list for the ICEpi SPI GPU project, detailing phases from infrastructure to validation, including time estimates and dependencies.
    - Updated the register specification to clarify framebuffer format and texture unit requirements, ensuring compatibility with RGB565 format for bandwidth efficiency.
    - Modified the display controller to support RGB565 pixel format, including changes to FIFO data width and pixel extraction logic for color expansion.
    [display_controller.sv]
2026-02-08 feat: migrate from speckit to syskit structure
    - Create automated migration scripts (migrate-speckit.py, establish-traceability.py, validate-migration.py)
    - Generate 78 syskit documents (43 REQ, 13 INT, 22 UNIT)
    - Establish full traceability: REQ → INT → UNIT
    - Extract GPU specifications (REQ-001 through REQ-016, FR-020 through FR-029)
    - Convert all contracts to INT documents (register map, memory layout, SPI protocol, APIs)
    - Generate design units for all hardware/software modules
    - Extract 9 design decisions to ADRs in design_decisions.md
    - Update CLAUDE.md and README.md with syskit references
    - Remove specs/ folder (history preserved in git)
    Remaining work:
    - Host software user stori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
2026-02-09 Remove migration and validation scripts for speckit to syskit transition
    - Deleted migrate-speckit.py which handled the migration of speckit specifications to syskit structure, including user stories, functional requirements, contracts, and modules.
    - Removed validate-migration.py that validated the migration process, checking document counts, cross-reference integrity, required fields, traceability completeness, and content migration completeness.
2026-02-10 feat: add mipmap support for textures and enhance GPU driver API for texture uploads
2026-02-10 feat: implement per-sampler texture cache architecture to enhance texture sampling performance
2026-02-10 Enhance GPU Driver Layer and Interfaces with Dithering and Color Grading Support
    - Added new requirements for ordered dithering (REQ-132) and color grading LUT (REQ-133) to improve visual quality and flexibility in rendering.
    - Updated GPU Register Map (INT-010) to include new registers for dithering control (DITHER_MODE) and color grading (COLOR_GRADE_CTRL, COLOR_GRADE_LUT_ADDR, COLOR_GRADE_LUT_DATA).
    - Introduced new API functions in GPU Driver API (INT-020) for setting dithering mode and uploading color LUTs.
    - Modified design documents to reflect changes in framebuffer processing, ensuring 10.8 fixed-point format is used for blending and dithering.
    - Updated requirements for alpha blendi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
2026-02-10 Enhance documentation and requirements for various components
    - Updated SPI Mode 0 Protocol documentation to specify consumer as UNIT-001 and added project-specific usage details including electrical configuration, transaction format, and flow control.
    - Revised DVI TMDS Output documentation to specify consumer as UNIT-009 and included detailed timing parameters for horizontal and vertical synchronization.
    - Enhanced Wavefront OBJ Format documentation to specify consumer as UNIT-031 and added details on supported directives, parsing behavior, and output expectations.
    - Updated USB HID Keyboard documentation to specify consumer as UNIT-025 and included details on supported keycodes and USB ho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
2026-02-11 Enhance documentation and requirements for GPU architecture
    - Updated interface documentation to clarify provider and consumer relationships for DVI TMDS output and USB HID keyboard.
    - Expanded GPU register map documentation with additional referenced requirements.
    - Added new texture cache architecture document detailing cache design and functionality.
    - Revised multiple requirements to specify interactions with the GPU driver layer and scene management.
    - Improved clarity and detail in performance targets and verification methods across various requirements.
    - Included additional dependencies and interfaces for asset processing and rendering functionalities.
2026-02-12 Enhance documentation and requirements for design, interfaces, and GPU architecture; update post-attach scripts and Dockerfile for syskit installation
2026-02-12 Refactor documentation and implementation for multi-platform support
    - Updated design documents to reflect the separation of platform-agnostic and platform-specific components, particularly in the GPU driver, scene management, and input handling.
    - Introduced INT-040 (Host Platform HAL) to abstract hardware access across RP2350 and PC platforms.
    - Enhanced requirements to specify multi-platform architecture, including dual-core operation on RP2350 and single-threaded execution on PC.
    - Added new PC SPI Driver (UNIT-035) documentation and implementation details for FT232H communication.
    - Revised existing requirements to clarify the behavior of the system on different platforms, ensuring cons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
2026-02-12 Add new design, interface, and requirement units for PC SPI Driver, Host Platform HAL, and Debug Host
2026-02-12 feat: Implement RP2350 GPU host firmware with inter-core communication
    - Add texture handling with a 64x64 checkerboard texture.
    - Implement Core 1 for render command execution and GPU communication.
    - Introduce USB keyboard input handling with TinyUSB support.
    - Create main application logic for scene management and demo switching.
    - Establish inter-core command queue for render commands.
    - Develop SPI transport layer for GPU communication.
    - Remove legacy GPU driver code from host application.
    - Document PC input handler design for terminal keyboard input.
    [teapot.obj]
2026-02-12 feat: Update asset management and add new textures and models for rendering
    [teapot.obj]
2026-02-12 feat: Update GPU driver and transport interfaces for mutable state; add memory build script
2026-02-13 Enhance mesh processing and rendering pipeline
    - Updated code generation for mesh patches to include per-patch AABB and entry count.
    - Modified asset build orchestration to support packed u8 strip commands for indices.
    - Improved render command execution to handle mesh patch rendering with frustum culling and lighting.
    - Introduced DMA memory copy trait for efficient data transfer from flash to SRAM.
    - Enhanced documentation to reflect changes in mesh processing, rendering requirements, and asset generation.
2026-02-13 Refactor mesh patch handling and quantization in asset build tool
    - Split raw mesh data into patches and compute mesh-wide AABB for quantization.
    - Introduce MeshPatchDescriptor for per-patch metadata, including AABB and entry counts.
    - Update output generation to write single SoA blob files for mesh patches.
    - Enhance Rust wrapper generation to include mesh-level AABB and patch descriptors.
    - Modify tests to validate new output structure and ensure correct quantization behavior.
    - Add quantization bias matrix utility for transforming model space coordinates.
    [build.rs]
2026-02-13 fix: Ensure Z depth conversion clamps to maximum value
2026-02-13 Enhance Z-buffer functionality and rendering configuration
    - Updated SRAM arbiter documentation to reflect changes in internal interfaces and access patterns for UNIT-006 (Pixel Pipeline).
    - Modified scene manager to support Z-prepass rendering, allowing for improved depth testing and framebuffer write efficiency.
    - Revised render executor to include new RENDER_MODE register configuration, integrating color write control and Z-range settings.
    - Introduced GPU driver layer updates for new rendering modes and Z-range clipping capabilities.
    - Updated GPU register map to include new Z_RANGE register for depth range clipping and modified RENDER_MODE to include color write enable.
    - Enhanced memor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
2026-02-13 Implement early Z-test and depth range clipping in GPU pipeline
    - Added early Z-test functionality in the rasterizer to improve rendering efficiency by skipping unnecessary Z-buffer reads.
    - Introduced depth range clipping to restrict fragment processing based on specified minimum and maximum depth values.
    - Updated the register file to include Z-range configuration and color write mode.
    - Enhanced the rasterizer and GPU top-level modules to accommodate new rendering modes and depth range checks.
    - Created a dedicated early Z-test module with comprehensive testbench to validate functionality.
    - Developed testbench for register file to ensure correct behavior of Z-range and color write mode.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
    [core1.rs, early_z.sv, gpu_top.sv, main.rs]
2026-02-14 Add boot pre-population feature to async_fifo and corresponding testbenches
    - Modified async_fifo to support a BOOT_COUNT parameter, allowing pre-population of FIFO entries after reset.
    - Updated write pointer initialization to respect BOOT_COUNT, ensuring the first BOOT_COUNT entries are immediately available for reading.
    - Implemented Gray-code conversion for boot count handling.
    - Created tb_command_fifo testbench to verify boot command sequence, boot-to-normal transition, and write pointer initialization for SPI commands.
    - Developed tb_async_fifo testbench to validate CDC operations, FIFO flags, and boot pre-population pointer initialization with two independent clocks.
    [async_fifo.sv, command_fifo.sv, gpu_top.sv, tb_async_fifo.sv, tb_command_fifo.sv]
2026-02-14 Refactor display controller and related documentation for clock domain synchronization and performance improvements
    - Updated pixel clock frequency from 25.175 MHz to 25.000 MHz across display controller and TMDS encoder documentation.
    - Enhanced timing budget and clock domain architecture sections to clarify synchronous relationships between GPU core and display output.
    - Revised SRAM interface documentation to reflect unified 100 MHz clock domain, eliminating CDC overhead.
    - Adjusted performance metrics and theoretical maximum fill rates in quality metrics and performance targets.
    - Improved clarity on framebuffer management, depth testing, and rasterization requirements to align with new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
2026-02-14 feat: Add synchronous FIFO implementation and corresponding testbench
    - Introduced sync_fifo module for same-clock-domain buffering, eliminating the need for gray-code CDC logic.
    - Created tb_sync_fifo testbench to validate sync_fifo functionality, including edge cases and operational integrity.
    - Updated Makefile to include sync_fifo and its testbench.
    - Adjusted display_controller and other modules to utilize sync_fifo for improved performance.
    - Corrected clock frequencies in comments and constraints for consistency across modules.
    [display_controller.sv, dvi_output.sv, gpu_top.sv, pll_core.sv, spi_slave.sv, sync_fifo.sv, tb_sync_fifo.sv, timing_generator.sv]
2026-02-14 Enhance SRAM Controller with Burst Read/Write Support
    - Updated the SRAM controller to support burst read and write operations, improving throughput for sequential access patterns.
    - Added new states to the SRAM controller FSM for handling burst operations, including BURST_READ_SETUP, BURST_READ_NEXT, BURST_WRITE_SETUP, and BURST_WRITE_NEXT.
    - Modified documentation to reflect changes in the display controller and SRAM memory layout, emphasizing the benefits of burst mode for display scanout and framebuffer writes.
    - Improved performance metrics and resource estimates related to burst mode implementation across various components, including texture cache and framebuffer management.
    - Enhance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
2026-02-15 Add testbench for texture_cache module to verify burst fill FSM functionality
    - Implemented comprehensive test cases covering reset state, cache misses, cache hits, data integrity, cache invalidation, and burst preemption.
    - Included specific tests for BC1 and RGBA4444 formats with known test vectors.
    - Added checks for expected behavior and data outputs during various scenarios.
    - Established a behavioral SRAM model to simulate memory interactions.
    [display_controller.sv, gpu_top.sv, sram_arbiter.sv, sram_controller.sv, tb_burst_integration.sv, tb_display_burst.sv, tb_sram_arbiter.sv, tb_sram_controller.sv]
2026-02-15 Refactor documentation to replace all instances of "SRAM" with "SDRAM" where applicable
    - Updated requirements documents to reflect the transition from SRAM to SDRAM, including changes in memory layout, burst mode descriptions, and performance impacts.
    - Adjusted functional requirements and acceptance criteria to ensure clarity regarding the use of SDRAM in various components such as texture sampling, framebuffer formats, and memory controllers.
    - Enhanced descriptions of memory access patterns and performance characteristics to align with SDRAM specifications.
2026-02-16 feat: Update DVI/HDMI output pin assignments and I/O standards in icepi_zero.lpf
2026-02-17 feat: Route register file read data back to SPI slave for read transactions
2026-02-17 feat: Update ICEpi Zero pin constraints and add GPIO header documentation
2026-02-19 Refactor requirements documentation for clarity and organization
    - Updated req_101_scene_management to clarify scene management responsibilities and initialization requirements.
    - Revised req_102_render_pipeline_execution to specify command dispatching and frame boundary delineation.
    - Enhanced req_103_usb_keyboard_input with a parent requirement reference.
    - Clarified req_104_matrix_transformation to detail the MVP transformation pipeline stages.
    - Expanded req_105_gpu_communication_protocol to specify SPI transaction format and operations.
    - Updated req_106_pc_debug_host to reflect new parent requirement.
    - Retired req_110_gpu_initialization and req_111_dualcore_architecture due to archite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
2026-02-20 Add GPU register package with comprehensive register definitions and enums
    - Introduced `gpu_regs_pkg` package containing various register structures for GPU configuration.
    - Defined output structures for color registers, UV coordinates, light direction, vertex data, texture settings, framebuffer control, and performance counters.
    - Added enumerations for texture formats, filtering modes, wrap modes, culling modes, alpha blending, dithering patterns, and Z comparison methods.
    - The package supports a data width of 64 bits and includes a total of 629 lines of generated code.
2026-02-20 Refactor GPU register definitions and structures for color management
    - Updated texture unit definitions to use unified configuration for textures.
    - Introduced new enums for texture formats, filter modes, and wrap modes.
    - Renamed color register fields from SPEC_* and DIFF_* to COLOR0_* and COLOR1_* for clarity.
    - Adjusted Verilog structures and assignments to reflect new naming conventions.
    - Ensured consistent handling of color values in the GPU register interface.
2026-02-20 Refactor documentation for memory layout and transaction format
    - Removed version and date information from the SRAM memory layout, SPI transaction format, and texture memory layout documents to streamline content.
    - Updated references to version numbers in the texture memory layout to reflect current specifications.
    - Clarified texture cache details in the texture memory layout, removing outdated version references while maintaining essential technical information.
2026-02-21 refactor: Update framebuffer register definitions and add memory fill register
2026-02-21 Add technical reports on N64 lightmapping suitability and RP2350 vertex throughput analysis
    - Created a new report detailing the suitability of N64-style color combiners for lightmapping in pico-gs, covering lightmapping fundamentals, N64 combiner capabilities, UV coordinate handling, memory considerations, and advanced techniques.
    - Added a report analyzing the vertex processing throughput of the RP2350, including hardware specifications, current pipeline implementation, detailed cycle breakdowns for various scenarios, and optimization opportunities.
2026-02-22 refactor: Enhance framebuffer and display configuration descriptions for clarity and detail
2026-02-22 Enhance architecture documentation and add framebuffer cache analysis
    - Updated memory bandwidth management details in ARCHITECTURE.md to include native 16-bit pixel addressing and Z-buffer tile cache.
    - Improved descriptions of component interactions and pixel processing in the rasterizer.
    - Added a comprehensive analysis of framebuffer tile cache and SDRAM burst efficiency in a new report.
    - Highlighted the impact of switching to native 16-bit addressing on bandwidth and memory footprint.
    - Provided recommendations for optimizing framebuffer and Z-buffer access patterns.
2026-02-23 Add performance timestamp functionality to GPU driver and register file
    - Implemented `timestamp` method in `GpuDriver` to insert a timestamp marker into the command stream, capturing the current cycle counter and writing it to SDRAM.
    - Added `read_cycle_counter` method to retrieve the current cycle counter value.
    - Updated the GPU register file to include a new `PERF_TIMESTAMP` register for capturing cycle counter values and writing them to SDRAM.
    - Modified the design documentation to reflect the new cycle counter and timestamp functionality.
    - Adjusted the GPU top-level module to handle timestamp write requests and integrate with the memory arbiter.
    - Refactored related register definitio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
2026-02-23 Refactor texture memory layout documentation for clarity and accuracy
    - Updated texture format descriptions and specifications, including block sizes and memory layouts.
    - Removed deprecated RGBA4444 format and provided conversion recommendations for existing assets.
    - Clarified mipmap chain structure and size calculations for various texture formats.
    - Enhanced address calculation examples and alignment requirements for texture formats.
    - Improved overall formatting and consistency in terminology throughout the document.
2026-02-23 refactor: Update GPU driver layer implementation and documentation for clarity and accuracy
2026-02-23 refactor: Enhance ClearCommand to support depth value and update framebuffer clearing logic
2026-02-24 feat: Add verification documentation and templates for improved traceability
2026-02-25 Update specification references and enhance SDRAM model functionality
    - Updated specification references in multiple source files to reflect the latest documentation.
    - Implemented burst read and write methods in the SDRAM model to support sequential access.
    - Enhanced the test harness for the register file to accommodate new mode outputs and improve validation checks.
    - Refactored SPI write transaction handling to ensure proper synchronization with the SDRAM model.
    - Added a new test scaffold for improved testing capabilities.
2026-02-25 fix: Update specification reference date in register_file.sv; enhance harness.cpp for command-line argument parsing and execution flow; add .gitignore for transient simulation output files
    [harness.cpp, register_file.sv]
2026-02-25 fix: Update depth-tested triangle golden image reference to PNG format; adjust GPU busy signal logic and rasterizer Z-buffer handling
    [gpu_top.sv, harness.cpp, rasterizer.sv]
2026-02-25 Refactor requirements and update specifications across multiple documents
    - Updated parent requirements and allocated units in GPU flow control, SPI hardware, rasterizer, and fragment processor documents.
    - Added interfaces and allocated units for texture mipmapping, texture samplers, and blend/framebuffer requirements.
    - Enhanced clarity in display output and timing requirements, including related requirements.
    - Revised performance targets and resource constraints to specify allocated units.
    - Improved asset processing and pipeline requirements with clear allocations.
    - Updated SPI communication protocol references to align with the host SPI driver.
    - Adjusted various render modules to ref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
2026-02-26 Implement behavioral SDRAM model for Verilator simulator
    - Added `sdram_model_sim.cpp` and `sdram_model_sim.h` to implement a cycle-accurate SDRAM model for the W9825G6KH SDRAM controller.
    - Included timing fidelity for row activation, CAS latency, auto-refresh, and burst cancel/PRECHARGE sequencing.
    - Created `test_sdram_model.cpp` to validate the SDRAM model with various tests including write/read correctness, read latency, auto-refresh behavior, burst cancel handling, and burst write correctness.
    - Modified `gpu_top.sv` to support simulation-only command injection and adjusted DVI output instantiation based on simulation mode.
    - Added `verilator_sim.f` to configure Verilator simulation fl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
    [gpu_sim.cpp, gpu_top.sv, sdram_model_sim.h]
2026-02-27 Refactor project structure and enhance documentation
    - Updated `.cargo/config.toml` to specify a custom target directory for build outputs.
    - Enhanced `syskit-guide.md` to include instructions for using `/syskit-technical-report` for preliminary investigations.
    - Added new command `syskit-technical-report.md` for documenting findings from investigations.
    - Introduced `syskit-trace.md` to display traceability trees for syskit IDs.
    - Updated `.gitignore` to consolidate build outputs and ignore unnecessary files.
    - Modified `ARCHITECTURE.md` to include a new unit for the Verilator Interactive Simulator App.
    - Added C++ code style guidelines to `CLAUDE.md`.
    - Adjusted `build.sh` to reflect chang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
2026-02-27 fix: Update spec references and header file extensions for SDRAM model
    [gpu_sim.cpp]
2026-02-27 refactor: Enhance test framework by introducing TestResults struct and improving assertion macros
2026-02-27 refactor: Update PNG writer to use std::span for framebuffer and improve error handling
    [harness.cpp, png_writer.cpp, png_writer.hpp]
2026-02-27 feat: Add technical report on Marlin as Verilator wrapper feasibility
2026-02-28 Enhance framebuffer configuration and display output handling
    - Updated documentation for framebuffer configuration to include `FB_CONFIG` register, which now encompasses color and Z-buffer base addresses along with surface dimensions (WIDTH_LOG2, HEIGHT_LOG2).
    - Clarified the impact of `FB_DISPLAY.FB_WIDTH_LOG2` on display scanout bandwidth and rendering performance, emphasizing the relationship between framebuffer width and available bandwidth.
    - Adjusted verification documentation to reflect the new framebuffer configuration, ensuring tests account for dynamic surface dimensions.
    - Improved clarity on the rasterizer's handling of framebuffer dimensions and the effects of LINE_DOUBLE on re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
2026-02-28 refactor: Update rasterizer module to support framebuffer dimensions from FB_CONFIG
2026-02-28 feat: Add framebuffer dimensions to GPU top module and update register file spec reference
2026-02-28 feat: Update display controller and testbench for framebuffer dimensions and scaling
2026-02-28 feat: Enhance triangle rasterizer testbench with bounding-box clamping checks and surface dimension handling
2026-02-28 feat: Update framebuffer extraction to support dynamic surface dimensions and improve addressing calculations
2026-02-28 feat: Update Gouraud triangle and depth-tested triangle tests for 512-wide framebuffer dimensions and adjust vertex positions
2026-02-28 feat: Add VER-014 textured cube tests and update test framework
2026-02-28 Enhance triangle rasterizer testbench with incremental interpolation and fragment output bus
    - Updated testbench to support incremental attribute interpolation and derivative precomputation.
    - Expanded vertex attribute definitions to include additional color and UV components.
    - Introduced fragment output bus with signals for fragment validity, coordinates, depth, colors, and UVs.
    - Added helper tasks for setting default vertex attributes and monitoring fragment emission.
    - Implemented back-pressure testing for fragment output bus to ensure proper handling of fragment readiness.
    - Enhanced existing tests to verify correct behavior under various conditions, including bounding-box clamping and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
    [rasterizer.sv, tb_rasterizer.sv]
2026-02-28 Refactor pixel_pipeline: Implement pipeline FSM and integrate color combiner interface
    - Added pipeline finite state machine (FSM) to manage fragment processing stages.
    - Updated fragment acceptance logic to only accept new fragments when idle.
    - Integrated color combiner input/output signals for better data flow.
    - Enhanced framebuffer and Z-buffer read/write logic with proper request handling.
    - Implemented combinational logic for stipple and early Z-tests.
    - Stubbed texture sampling with white opaque texels for initial testing.
    - Added detailed comments for clarity on pipeline stages and operations.
2026-02-28 Add BC1 texture decoder and update texture cache for new formats
    - Implemented a new module `texture_bc1` to decode BC1 (DXT1) compressed texture blocks into RGBA5652 format.
    - Updated `texture_cache` to support additional texture formats including BC2, BC3, BC4, RGB565, RGBA8888, and R8.
    - Modified the burst length definitions and SRAM address calculations to accommodate the new formats.
    - Removed support for RGBA4444 format and adjusted the decompression logic accordingly.
    - Enhanced the testbench to include tests for the new BC1, BC2, BC3, and BC4 decoders, ensuring correct functionality and format selection.
    [pixel_pipeline.sv, texture_cache.sv]
2026-02-28 Enhance color_combiner_tb for VER-004 compliance
    - Updated testbench to cover all 14 procedures for VER-004.
    - Improved documentation for each test case, detailing expected behavior and configurations.
    - Added new constants for Q4.12 representation and extended CC_SOURCE encoding.
    - Implemented helper functions for fragment driving and UNORM8 to Q4.12 promotion.
    - Refactored existing tests to align with new specifications, including saturation checks and per-component independence.
    - Introduced additional tests for MODULATE_ADD, FOG, and saturation behaviors.
    - Enhanced timeout mechanism for simulation stability.
    [color_combiner.sv, color_combiner_tb.sv]
2026-02-28 Integrate pixel pipeline into GPU RTL with texture cache and golden images
    Complete the pixel pipeline integration (UNIT-006) connecting rasterized
    fragments through texture sampling, Z-testing, color combining, and
    framebuffer write. All five golden image tests (VER-010 through VER-014)
    pass.
    RTL fixes:
    - Wire texture cache fill FSM through pixel_pipeline to arbiter port 3
    - Add PP_TEX_LOOKUP/PP_TEX_WAIT FSM states for cache hit/miss handling
    - Fix texture_cache read_bank_addr sub-block quad selection
    - Fix U/V coordinate swap in gpu_top (pack_uv puts U in [15:0])
    - Fix rasterizer bbox_sx/sy to use delta from V0 for Gouraud start values
    - Fix rasterizer derivative scaling to use area_shif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
    [gpu_top.sv, harness.cpp, pixel_pipeline.sv, rasterizer.sv, register_file.sv, sram_arbiter.sv, texture_cache.sv]
2026-02-28 Add testbenches for dither and framebuffer promotion modules
    - Implemented tb_dither.sv to test the ordered dithering functionality using a 16x16 Bayer matrix.
    - Added comprehensive test cases for various input colors, including edge cases for bypass mode and maximum dither values.
    - Implemented tb_fb_promote.sv to validate RGB565 to Q4.12 conversion through MSB-replication.
    - Included tests for primary colors, mid-gray, and various intensity levels to ensure accurate conversion.
2026-02-28 Add Q4.12 fixed-point type package and update references in render modules
    [dither.sv, early_z.sv, fb_promote.sv, fp_types_pkg.sv, pixel_pipeline.sv, stipple.sv, texel_promote.sv, texture_cache.sv]
2026-03-01 Update pixel pipeline documentation and references to Q4.12 fixed-point format; adjust spec references across multiple files
    [color_combiner.sv, dither.sv, early_z.sv, fb_promote.sv, fp_types_pkg.sv, pixel_pipeline.sv, stipple.sv, texel_promote.sv]
2026-03-01 Add testbench for raster_edge_walk module and update rasterizer testbench for attribute accumulation
    - Created a new testbench `tb_raster_edge_walk.sv` to verify the functionality of the raster_edge_walk module, including position tracking, edge functions, and fragment valid/ready handshake.
    - Implemented various test cases to validate the behavior of the raster_edge_walk module under different conditions.
    - Updated `tb_rasterizer.sv` to reference the correct signals from the `u_attr_accum` structure for color and Z derivatives, ensuring accurate comparisons with reference values.
    [raster_attr_accum.sv, raster_deriv.sv, raster_edge_walk.sv, rasterizer.sv, tb_raster_attr_accum.sv, tb_raster_deriv.sv, tb_raster_edge_walk.sv, tb_rasterizer.sv]
2026-03-01 Enhance synthesis process: Add profiling scripts and summary generation for Yosys synthesis stages; update build scripts for memory monitoring and logging.
2026-03-03 Refactor documentation for GPU interfaces and requirements
    - Updated GPU register map documentation (INT-010) to include external consumer details and clarified key requirement areas.
    - Enhanced SRAM memory layout documentation (INT-011) with external consumer information and refined requirement areas.
    - Revised SPI transaction format documentation (INT-012) to specify external consumer roles and updated requirement areas.
    - Improved GPIO status signals documentation (INT-013) by adding external consumer context.
    - Expanded texture memory layout documentation (INT-014) with external consumer details and clarified requirement areas.
    - Updated quality metrics documentation to focus on GPU-spec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
2026-03-03 Remove pico-gs-pc and pico-gs-rp2350 crates
    - Deleted the `pico-gs-pc` crate, including its Cargo.toml, source files, and input handling.
    - Removed the `pico-gs-rp2350` crate, including its Cargo.toml, build script, memory layout, core1 execution, input handling, main application logic, command queue, and transport implementation.
    - Updated documentation to reflect the change from "GPU Debug GUI" to "GPU Interactive Simulator".
    - Adjusted internal documentation to include references to the external consumer `pico-racer` for various memory layouts and functionalities.
    [teapot.obj]
2026-03-04 Add comprehensive technical report for rasterizer redesign
    This commit introduces a detailed technical report outlining the comprehensive plan for the pico-gs rasterizer (UNIT-005). The report addresses the current state of the rasterizer specifications and implementation, identifies divergences from intended design goals, and proposes a clean replacement for the rasterizer requirements and design documents.
    Key highlights include:
    - Background on the rasterizer's evolution and resource issues.
    - Investigation into current specifications, RTL implementation, and register interfaces.
    - Findings on traversal order, perspective correction, attribute precision, and color interpolation strategie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
2026-03-04 Refactor area setup handling in rasterization tests
    - Removed AREA_SETUP commands from various test scripts (ver_011_depth_test.cpp, ver_012_textured.cpp, ver_013_color_combined.cpp, ver_014_textured_cube.cpp) and replaced them with comments indicating that inv_area is hardcoded in raster_deriv.sv.
    - Updated tb_raster_deriv.sv to eliminate inv_area_reg and area_shift_reg, replacing their functionality with hardcoded values for inv_area and area_shift.
    - Adjusted tb_rasterizer.sv to remove inv_area variable assignments and updated references to use hardcoded inv_area values.
    - Ensured that all relevant calculations in the tests reflect the new hardcoded inv_area and area_shift values, maintai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
    [gpu_top.sv, harness.cpp, raster_deriv.sv, rasterizer.sv, register_file.sv, tb_raster_deriv.sv, tb_rasterizer.sv]
2026-03-05 Update testbench for rasterizer: enhance fragment output handling and add new tests for tile traversal and perspective correction
    [tb_rasterizer.sv]
2026-03-05 Update testbench for raster_deriv and rasterizer: correct initialization values and clarify derivative computation
    [tb_raster_deriv.sv, tb_rasterizer.sv]
2026-03-06 Update development guidelines: uncomment build script requirement and clarify board change approval
2026-03-06 Refactor rasterizer reciprocal computation and enhance perspective correction pipeline
    - Split the shared reciprocal LUT into two dedicated modules: `raster_recip_area.sv` for triangle setup inv_area computation and `raster_recip_q.sv` for per-pixel 1/Q computation, improving modularity and clarity.
    - Update the perspective correction pipeline from a 2-cycle to a 3-cycle process, incorporating a BRAM read stage for enhanced efficiency.
    - Adjust DSP slice usage in the rasterizer, increasing from 7 to 8 slices to accommodate the new reciprocal modules.
    - Implement a setup-iteration overlap FIFO to allow concurrent triangle setup and iteration, reducing stalls for small triangles.
    - Update docu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
2026-03-08 First cut of digital twin Implement GPU command processor and graphics pipeline
    - Added command processor to interpret GPU commands and manage state updates.
    - Implemented vertex transformation stage to convert object-space vertices to clip space.
    - Developed rasterization stage for triangles using fixed-point arithmetic.
    - Created fragment processing stage for depth testing, texturing, and framebuffer writing.
    - Established inter-stage data structures for GPU pipeline communication.
    - Introduced test harness for golden reference comparison and framebuffer validation.
    - Added integration tests for rendering known scenes and verifying output.
    [main.rs]
2026-03-08 feat: enhance build process and add digital twin functionality
    - Updated .gitignore to include build directory.
    - Added serde dependency to Cargo.lock for serialization support.
    - Modified build.sh to include steps for building and testing the digital twin (gs-twin).
    - Enhanced main.rs to support rendering a new scene (ver_010) and added a register write script.
    - Updated Cargo.toml to enable serde feature for fixed-point arithmetic.
    - Introduced reg.rs for register-write interface matching RTL's register_file.sv.
    - Implemented integer-pixel rasterization in rasterize.rs to match RTL behavior.
    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
    [main.rs]
2026-03-08 Refactor GPU pipeline: remove command processing, fragment, vertex stages, and related tests
    - Deleted command processing logic in `command_proc.rs`, including GPU command execution and immediate-mode drawing.
    - Removed fragment processing logic in `fragment.rs`, including depth testing and color modulation.
    - Eliminated vertex transformation logic in `vertex.rs`, which handled MVP matrix transformations.
    - Updated `mod.rs` to reflect the removal of the command, fragment, and vertex modules, simplifying the pipeline structure.
    - Removed rasterization logic in `rasterize.rs`, including triangle rasterization and attribute interpolation.
    - Deleted test harness functions related to single trian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
2026-03-08 Refactor and enhance documentation across the codebase
    - Removed unused dependencies from Cargo.lock to streamline the project.
    - Updated dependencies in gs-twin-cli's Cargo.toml to disable default features and specify required features explicitly.
    - Improved documentation in main.rs, cmd.rs, hex_parser.rs, lib.rs, math.rs, mem.rs, pipeline.rs, reg.rs, and test_harness.rs by adding detailed comments and examples for functions and structs.
    - Introduced a new pipeline module with a rasterize submodule to encapsulate rasterization logic.
    - Enhanced the DepthFunc enum in cmd.rs with additional variants and documentation.
    - Added comprehensive documentation for framebuffer and depth buffer operat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
2026-03-08 Implement GPU pipeline fragment stages: add alpha blending, alpha test, color combining, depth range clipping, early Z test, stipple testing, texture sampling, dithering, and pixel writing
2026-03-09 Refactor UV handling to ST in GPU register files and tests
    - Renamed UV0_UV1 to ST0_ST1 in common.py and updated associated functions.
    - Updated comments and variable names in ver_012.py, ver_013.py, ver_014.py to reflect ST usage.
    - Modified hex output files to replace UV0_UV1 with ST0_ST1.
    - Adjusted testbench files (register_file_v10_tb.sv, tb_register_file.sv) to use ST0_ST1 instead of UV0_UV1.
    - Ensured all references to UV are replaced with ST in the relevant files for consistency.
    [gpu_top.sv, raster_attr_accum.sv, raster_deriv.sv, rasterizer.sv]
2026-03-09 Remove obsolete documentation files for SPI transaction format, GPIO status signals, and texture memory layout
    - Deleted `int_012_spi_transaction_format.md` as it is no longer relevant to the current architecture.
    - Removed `int_013_gpio_status_signals.md` which is outdated and not aligned with the latest GPIO specifications.
    - Eliminated `int_014_texture_memory_layout.md` due to changes in texture handling and memory organization.
2026-03-09 Refactor GPU memory model to use flat SDRAM backing store
    - Updated GpuMemory structure to represent a flat 32 MiB SDRAM as a Vec<u16>.
    - Removed Framebuffer and RawZBuffer structures, integrating their functionality into GpuMemory.
    - Implemented tiled addressing for framebuffer and Z-buffer operations.
    - Modified alpha blending, display, early Z-test, pixel write, and register write functions to utilize the new GpuMemory structure.
    - Updated tests and comparison functions to work with linear RGB565 pixel data instead of Framebuffer.
2026-03-10 Enhance GPU architecture with GpuAction enum and texture sampler integration
2026-03-10 Enhance GPU fragment processing with new pipeline stages and color handling
2026-03-11 Enhance rendering scripts with texture uploads and buffer clears
    - Added color buffer clear commands to `ver_013_color_combined.hex`, `ver_014_textured_cube.hex`, and `ver_015_size_grid.hex` to ensure a clean framebuffer before rendering.
    - Updated texture uploads in `ver_013_color_combined.hex` and `ver_014_textured_cube.hex` to include a 16x16 checker texture with appropriate data.
    - Modified vertex data in both `ver_013_color_combined.hex` and `ver_014_textured_cube.hex` to adjust texture coordinates and positions for improved rendering accuracy.
    - Introduced a new color combination mode in `ver_014_textured_cube.hex` to enhance visual effects during rendering.
    - Adjusted framebuffer conf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
2026-03-11 Refactor depth test scripts and add perspective road test
    - Updated ver_011_depth_test.hex to use reverse-Z with adjusted triangle depths for correct occlusion.
    - Modified ver_014_textured_cube.hex to implement reverse-Z and corrected texture base address, along with color adjustments for cube faces.
    - Introduced new ver_016_perspective_road.hex script to test Z interpolation and perspective depth gradient with a two-triangle road setup.
    [harness.cpp, raster_attr_accum.sv, raster_deriv.sv, raster_edge_walk.sv, raster_recip_area.sv]
2026-03-11 Enhance perspective-correct texturing in GPU scripts
    - Updated texture emission functions in ver_014.py and ver_016.py to incorporate perspective-correct texturing using `pack_st_perspective` and `q_perspective`.
    - Modified vertex data structures to include perspective weight (w) for each vertex in triangle emission functions.
    - Adjusted hex files (ver_012_textured.hex, ver_013_color_combined.hex, ver_014_textured_cube.hex, ver_016_perspective_road.hex) to reflect changes in vertex data format and texture coordinates, ensuring compatibility with the new perspective calculations.
    - Ensured that all relevant comments and documentation within the code are updated to reflect the changes made.
    [raster_deriv.sv, rasterizer.sv]
2026-03-12 Refactor memory fill operations and enhance texture handling in GPU tests
    - Updated memory fill base address to 24 bits across various test scripts to accommodate larger address space.
    - Modified texture upload logic in ver_016.py to utilize a 64x64 checker texture with 16x16 squares, implementing bilinear filtering.
    - Adjusted Z-buffer clearing operations in multiple test scripts to reflect new memory addressing.
    - Enhanced triangle emission logic in ver_016.py to support rendering of road strips instead of a single quad, improving depth interpolation.
    - Added a new helper function for emitting block-aligned checker textures.
    - Updated register file testbench to handle new memory fill layou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
2026-03-13 Implement debug pixel support in rasterization pipeline
    - Added `rasterize_iter_debug` function to create a debug-aware iterator for capturing accumulator state at specific pixel coordinates.
    - Enhanced `TriangleIter` struct with fields for debug pixel tracking and last captured debug state.
    - Modified fragment emission logic to capture debug information when the current pixel matches the debug target.
    - Introduced `emit_fragment_debug` function to emit fragments along with detailed debug information.
    - Updated tests and scripts to remove unnecessary dummy NOPs related to FIFO FWFT workaround.
    - Added methods to access texture configuration registers in the register file.
    [gpu_top.sv, main.rs]
2026-03-14 Enhance Dockerfile dependencies and improve framebuffer handling in pixel pipeline and rasterizer
2026-03-14 Update texture tests to render into a 512x480 framebuffer
    - Modified ver_017.py, ver_018.py, ver_019.py, and ver_020.py to change the framebuffer size from 64x64 to 512x480.
    - Updated comments and framebuffer configurations accordingly.
    - Added new test ver_021.py for RGBA8888 texture rendering with a 512x480 framebuffer.
    - Adjusted corresponding hex files (ver_017_bc1_texture.hex, ver_018_bc2_texture.hex, ver_019_bc3_texture.hex, ver_020_bc4_texture.hex, ver_021_rgba8888_texture.hex) to reflect the new framebuffer size and configurations.
2026-03-14 Enhance texture handling and promotion logic in GPU architecture
    - Updated documentation for compressed textures to clarify cache intermediate formats based on TEXn_FMT.CACHE_MODE.
    - Revised texture sampling requirements to specify active cache formats (RGBA5652 or UQ1.8) during cache hits and misses.
    - Adjusted texture cache capacity specifications to reflect the selected cache mode and its impact on EBR usage.
    - Enhanced texture format promotion details to include specific paths for RGBA5652 and UQ1.8 formats.
    - Improved verification methods to ensure accurate promotion and decoding across different cache modes.
    - Updated integration tests for textured triangles and cubes to account for ch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
2026-03-15 Enhance texture_rgba8888 module to support CACHE_MODE=1 (UQ1.8 RGBA)
    - Updated texture_rgba8888.sv to include CACHE_MODE input for selecting between RGBA5652 and UQ1.8 formats.
    - Modified output to accommodate 36-bit UQ1.8 format, expanding channels from 8-bit to 9-bit.
    - Adjusted testbench (texture_decoder_tb.sv) to validate new CACHE_MODE functionality for various texture formats, including BC1, BC2, BC3, BC4, RGB565, RGBA8888, and R8.
    - Added comprehensive tests for CACHE_MODE=1, ensuring correct output for both RGBA5652 and UQ1.8 formats.
    - Verified bit layout for UQ1.8 in test cases, ensuring proper channel expansion and ordering.
    [dither.sv, early_z.sv, fb_promote.sv, fp_types_pkg.sv, pixel_pipeline.sv, raster_attr_accum.sv, raster_deriv.sv, raster_edge_walk.sv]
2026-03-15 Refactor texture sampling pipeline and introduce TexelUq18 type
    - Updated `tex_sample.rs` to implement a new `TrilinearBlender` trait for improved texture sampling.
    - Introduced a `TextureSampler` struct that encapsulates the full texture sampling pipeline, including a block fetcher, sample gatherer, and bilinear blender.
    - Enhanced the `sample` method to utilize the new structure and handle trilinear filtering.
    - Created a new `texel.rs` file defining the `TexelUq18` type, which serves as the sole texture cache storage format, promoting texels to Q4.12 format for downstream processing.
    - Removed redundant code and improved organization for better maintainability and clarity.
2026-03-16 Add golden image test for R8 texture decoding
    This commit introduces a new test script for verifying the R8 texture decoding path. The test utilizes a 256x256 R8 grayscale texture and renders it on a 512x480 quad. It includes framebuffer configuration, texture setup, and vertex definitions to ensure proper rendering of the texture. The script is designed to validate the 8bpp 4x4-tiled single-channel decode functionality.
2026-03-18 Add texture sampler module and update various testbench file paths
    - Introduced a new texture sampler module in `texture_sampler.sv` that implements UV coordinate wrapping, bilinear tap computation, and blending for texture sampling.
    - Updated the `command_fifo.sv` to conditionally set boot command parameters based on simulation flags.
    - Modified testbench files to change the output VCD file paths to a centralized build directory (`../build/sim_out/`) for better organization and consistency.
2026-03-19 Add Memory DMA Engine and Enhance SDRAM Controller
    - Introduced a new Memory DMA Engine (`mem_dma`) to handle MEM_DATA and MEM_FILL write paths, allowing for efficient burst writes to SDRAM.
    - Updated `gpu_top` to integrate the new DMA engine, including necessary signal connections and state management for DMA requests.
    - Enhanced the SDRAM controller to properly handle concurrent refresh operations during burst writes, ensuring data integrity and preventing double-writes.
    - Modified the register file to support pre-incremented dword addresses for memory operations.
    - Added comprehensive test cases to validate the functionality of the new DMA engine and the robustness of the SDRAM controller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
    [gpu_top.sv, mem_dma.sv, pixel_pipeline.sv, raster_edge_walk.sv, register_file.sv, sdram_controller.sv, tb_sdram_controller.sv, texture_cache.sv]
2026-03-22 Refactor GPU simulation Lua path and add shared types for gs-twin-core
    - Updated Lua script path in gpu_sim.cpp to point to the correct directory.
    - Introduced a new Cargo.toml for the gs-twin-core crate, defining dependencies and metadata.
    - Added alpha_test.rs for alpha testing functionality in the fragment pipeline.
    - Created debug_types.rs to define debug data structures for rasterizer state.
    - Implemented depth_range.rs for depth range clipping of fragments.
    - Defined fragment.rs to encapsulate per-stage fragment types for the pixel pipeline.
    - Developed hex_parser.rs to parse GPU test script `.hex` files, including directives for framebuffer and textures.
    - Established lib.rs to expose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
    [async_fifo.sv, color_combiner.sv, color_combiner_tb.sv]
2026-03-22 Refactor rasterizer and pixel pipeline documentation to reflect updated unit structure
    - Updated references from UNIT-004 (Triangle Setup) to UNIT-005.01 (Triangle Setup) in various design and verification documents.
    - Adjusted internal interface descriptions to clarify data flow between units.
    - Revised implementation details to align with the new sub-unit organization within the rasterizer.
    - Corrected references to derivative precomputation and perspective correction modules in the verification documents.
    - Ensured consistency across requirements and verification tests regarding triangle setup and rasterization processes.
2026-03-23 Enhance texture handling and verification documentation
    - Updated mipmapping requirements to specify address calculation hardware in UNIT-011.01.
    - Clarified texture cache requirements, specifying UNIT-011 for texture sampling and caching.
    - Revised texture sampler documentation to reflect changes in UNIT-011 instantiation.
    - Improved color combiner requirements to source texture colors from UNIT-011.
    - Adjusted resource constraints to include UNIT-011 allocations.
    - Enhanced verification strategy to include UNIT-011 in re-approval triggers and test descriptions.
    - Updated texture decoder verification to reference UNIT-011.04 for block decompression.
    - Clarified integration tests to specify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
2026-03-24 Update texture components and documentation for UNIT-011
    - Updated specification references in texture cache, L2 cache, and texture decoder files to reflect new documentation.
    - Added texture_bc5 decoder to the texture decoder testbench, including comprehensive test cases for BC5 format.
    - Modified format-select mux to accommodate the new BC5 format, updating related test cases and comments.
    - Adjusted README and design documentation to include new units related to texture processing (UNIT-011).
    - Corrected file paths in the Makefile for texel promotion and texture components.
    - Updated fixed-point type definitions package reference to the latest specification.
    [dither.sv, early_z.sv, fb_promote.sv, fp_types_pkg.sv, pixel_pipeline.sv, stipple.sv, texel_promote.sv, texture_cache.sv]
2026-03-25 Implement Hi-Z metadata management for hierarchical Z rejection
    - Added requirements for Hi-Z metadata updates and fast-clear behavior in Z-buffer operations documentation.
    - Enhanced Z-buffer clear functionality to invalidate Hi-Z metadata entries without writing to individual Z-buffer words.
    - Updated resource constraints to include Hi-Z metadata storage in EBR budget.
    - Verified Hi-Z tile rejection behavior in rasterizer tests, ensuring correct fragment emissions based on depth comparisons.
    - Integrated Hi-Z metadata handling in the pixel pipeline, including lazy initialization and rejection counting.
    - Implemented a new HizMetadata structure to manage per-tile metadata for hierarchical Z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
    [dither.sv, early_z.sv, fb_promote.sv, fp_types_pkg.sv, gpu_top.sv, harness.cpp]
2026-03-26 fix(harness): update Hi-Z rejection counter logic for depth_test scene
    [gpu_top.sv, harness.cpp, pixel_pipeline.sv, raster_edge_walk.sv, rasterizer.sv]
2026-03-26 Add testbench for sync_fifo and update Makefile paths
    - Introduced a comprehensive testbench for the sync_fifo module, validating FIFO operations including reset state, single read/write, full/empty flags, overflow/underflow protection, and count accuracy.
    - Updated Makefile to reflect new directory structure for RTL test files, ensuring correct paths for testbench files across various components.
    [async_fifo.sv, color_combiner.sv, color_combiner_tb.sv, command_fifo.sv, display_controller.sv, dither.sv, dvi_output.sv, early_z.sv]
2026-03-27 Add texture decoder testbenches and update Makefile for integration
    - Introduced testbenches for texture formats: R8, RGB565, and RGBA8888.
    - Implemented checks for correct texel extraction and channel expansion.
    - Updated integration Makefile to include new test targets for block decoders.
    - Added channel expansion functions to fp_types_pkg for consistent UQ1.8 conversion across decoders.
    [fp_types_pkg.sv]
2026-03-27 Refactor texture cache fill process and integrate block decoding
    - Removed the decompression state from the cache fill FSM, simplifying the flow to IDLE → FETCH → WRITE_BANKS → IDLE.
    - Integrated texture_block_decode for direct decoding of texels during the WRITE state, eliminating the need for intermediate decompression storage.
    - Updated write_count to track the number of texels written per cycle, reducing its size from 4 bits to 2 bits.
    - Adjusted bank write logic to directly use decoded texels, improving efficiency.
    - Modified Makefile to include texture_block_decode.sv in RTL sources for integration and simulation.
2026-04-02 refactor(zbuf_tile_cache): improve eviction request handling and prevent data overwrite during burst writes
    [harness.cpp, zbuf_tile_cache.sv]
2026-04-02 Add bilinear filter test vector generator and integration into Makefile
    - Introduced a new binary `gen_bilinear_test_vectors` to generate hex files for bilinear filter test vectors.
    - Implemented the logic for generating stimulus and expected output vectors in `src/bin/gen_bilinear_test_vectors.rs`.
    - Updated `Cargo.toml` to include the new binary.
    - Modified the integration `Makefile` to add a target for generating bilinear filter test vectors and integrated it into the DT-verified texture testbench workflow.
2026-04-04 Enhance documentation and verification files
    - Added sub-requirements to GPU SPI Hardware (REQ-001), Rasterizer (REQ-002), System Constraints (REQ-011), and Host SPI Driver (REQ-013) documentation for better clarity and organization.
    - Updated paths in verification documentation to reflect the new directory structure for integration tests, changing references from PPM to PNG format for output files.
    - Corrected test implementation paths in various verification files to align with the updated directory structure.
    - Adjusted comments in the `fp_types_pkg.sv` file to reflect the correct specification reference date.
    - Fixed a comment in the `Gpu` struct to accurately describe the purpose of the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
    [dither.sv, early_z.sv, fb_promote.sv, fp_types_pkg.sv, pixel_pipeline.sv, stipple.sv, tb_pixel_pipeline_uninit_flags.sv]
2026-04-04 Add technical report on Bilinear Filter DSP analysis and optimization strategies
2026-04-04 Remove obsolete syskit commands and related documentation files: syskit-impact, syskit-implement, syskit-plan, syskit-propose, syskit-refine, syskit-technical-report, and syskit-trace. Update Dockerf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
2026-04-05 feat: add cycle-accurate GPU emulator and SDRAM model
    - Implemented a simplified PLL clock model in `ecp5-model` to manage clock domains.
    - Created a new `pico-gs-emulator` crate for a cycle-accurate GPU emulator.
    - Developed clock domain management in `clock.rs`, utilizing the PLL model.
    - Established a state hierarchy for the GPU in `state.rs`, encapsulating all module states.
    - Added module tick functions for display, memory, pixel pipeline, rasterizer, and SPI.
    - Implemented a controller-level SDRAM model in `sdram-model` with cycle-accurate timing.
    - Defined timing constants for the W9825G6KH SDRAM chip in `timing.rs`.
    - Added tests to verify functionality of the emulator and SDRAM cont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
2026-04-06 Remove cycle-accurate emulator, clarify two-tier verification strategy
    Remove pico-gs-emulator, ecp5-model, and sdram-model crates — Verilator
    owns cycle-accurate verification; the digital twin remains the algorithmic
    oracle for golden reference output.
    Relocate generated register SV from components/registers/generated/ to
    components/registers/rtl/generated/ and consolidate gpu-registers
    dependency via workspace. Clean up devcontainer extensions.
    Add DT/RTL gap analysis report documenting pipeline stall propagation
    status and DT stub inventory (stipple, dither, alpha-blend).
2026-04-08 Narrow color derivatives from 32-bit to 16-bit signed
    Reduce color attribute derivative registers from Q8.16 (32-bit) to Q8.8
    (16-bit signed) and color accumulators from 32-bit to 24-bit, saving
    ~700 register bits and ~1000 LUT4 in the rasterizer. Z, S/T, and Q
    derivatives remain at full 32-bit width.
    The final framebuffer is RGB565 (5/6/5 bits per channel), so 8
    fractional bits of interpolation precision is more than sufficient.
    Max accumulated error after 512 steps is ~2 UNORM8 units, which maps
    to less than 1 LSB at RGB565 resolution.
    RTL: color derivative ports narrowed to signed [15:0], color inits to
    signed [23:0], accumulators to signed [23:0] with updated clamping
    logic (guard[23:1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
    [raster_attr_accum.sv, raster_deriv.sv, rasterizer.sv, tb_deriv_dt.sv, tb_raster_attr_accum.sv]
2026-04-11 Refactor alpha blending implementation and update pipeline configuration
    - Updated the alpha blend golden image test to streamline the blending modes and improve clarity in the framebuffer setup.
    - Retired the alpha_blend unit and integrated blending functionality into the color combiner's second pass, utilizing a new color tile buffer for efficient destination color fetching.
    - Adjusted the pipeline configuration to reflect the new architecture, including changes to DSP usage and latency notes for the color combiner.
    - Updated the YAML schedule to accommodate the new blending process, ensuring proper timing and resource allocation for the color combiner stages.
    - Revised fixed-point type pa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
    [color_combiner.sv, color_combiner_tb.sv]
2026-04-13 refactor: update rasterizer states to render pipeline stages with detailed descriptions
2026-04-15 refactor: update texture sampler RTL references and clarify bilinear filter DSP requirements
2026-04-22 Implement texture sampling and Z-buffer tile cache components
    - Add texture UV coordinate processing module with bilinear tap computation and wrap mode handling.
    - Create texture sampling facade that integrates the texture pipeline, including fetchers, filters, and blenders.
    - Introduce Z-buffer tile cache with a 4-way set-associative write-back mechanism, including lazy-fill for uninitialized tiles.
    - Implement per-tile uninitialized flag tracking for efficient Z-buffer management.
2026-04-23 Refactor documentation and code references to align with UNIT-011 updates
    - Updated references in verification documents to reflect the transition from INT-032 to UNIT-011 for cache miss handling protocols and related components.
    - Adjusted comments in RTL source files to replace outdated INT-032 references with UNIT-011 specifications.
    - Modified test implementation notes and failure criteria in verification documents to ensure consistency with the new architecture.
    - Revised texture sampling and block decoding logic to incorporate UNIT-011 standards, enhancing clarity and accuracy in the codebase.
    - Ensured all relevant scripts and README files are updated to reflect the changes in texture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
    [fp_types_pkg.sv, harness.cpp, pixel_pipeline.sv, texel_promote.sv]
2026-04-24 Refactor texture sampling subsystem to support NEAREST filtering only
    - Removed UNIT-011.02 (Bilinear/Trilinear Filter) documentation and related references.
    - Updated UNIT-011 texture sampler to reflect NEAREST filtering mode exclusively.
    - Adjusted interfaces and requirements to eliminate bilinear and trilinear filtering references.
    - Modified L1 cache documentation to clarify single-cycle texel access without bilinear quad support.
    - Revised GPU register map to indicate NEAREST filtering only.
    - Deleted mipmapping requirement (REQ-003.07) as it is no longer applicable.
    - Updated quality metrics and resource constraints to align with the new filtering approach.
    - Ensured all relevant docum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
2026-04-25 Refactor texture filtering and UV coordinate processing
    - Removed the bilinear filtering implementation from the texture filtering module, simplifying the texture sampling pipeline to support only nearest filtering.
    - Updated UV coordinate processing to eliminate bilinear tap computation, focusing on nearest tap calculations.
    - Adjusted test vector generation to remove bilinear mode cases, ensuring all tests reflect the current nearest-only functionality.
    - Cleaned up related documentation and comments to align with the new implementation.
2026-04-25 Enhance verification documentation for perspective road rendering and introduce palette slot verification
    - Updated the verification method for perspective road rendering (VER-016) to include INDEXED8_2X2 texture sampling and detailed preconditions for golden image re-approval after PR2 implementation.
    - Expanded the verified design units and requirements to reflect changes in texture handling and palette management.
    - Added a new verification document (VER-025) for palette slots, detailing test scenarios for simultaneous palette usage, mid-frame reloads, quadrant coverage, MIRROR wrap behavior, and cache invalidation semantics.
    - Ensured comprehensive pass criteria and expected results for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
2026-04-27 Refactor texture sampling component to improve clarity and performance
    - Updated module structure and documentation for the texture sampling component.
    - Replaced the `TrilinearBlender` trait with a simplified `TextureSampler` interface that directly handles sampling.
    - Introduced a dedicated `IndexCache` for half-resolution texture indexing, improving cache management.
    - Enhanced palette handling by allowing shared access to the `PaletteLut` across samplers.
    - Implemented a new method for handling index-cache misses, optimizing SDRAM reads.
    - Added tests to validate sampler behavior, including disabled states and palette loading.
2026-04-28 Enhance DMA and arbiter modules to support byte addressing and stride 2 for fill operations
2026-04-29 Refactor palette slot BRAM and texture palette LUT to simplify port handling and improve clarity
2026-04-29 Enhance framebuffer and color tile cache functionality
    - Updated framebuffer format documentation to clarify the role of the color tile cache (UNIT-013) and its impact on SDRAM writes and cache hit rates.
    - Added details on framebuffer clear operations, including the behavior of FB_CACHE_CTRL.INVALIDATE_TRIGGER and lazy-fill for color tiles.
    - Improved double-buffered rendering requirements to ensure proper flushing of dirty cache lines before framebuffer swaps.
    - Clarified resource constraints for the color tile cache (UNIT-013) in performance targets and resource budget sections.
    - Introduced a new verification document for the color tile cache (VER-006) to ensure proper functionality and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
